zgeez/Pixel-Badge/docs/README.md

# Docs

Start here:

- [Architecture](architecture.md): how the pieces fit together
- [Hardware](hardware.md): the board and the parts on it
- [Firmware](firmware.md): building, controls, tests
- [Rev A firmware](rev-a-firmware.md): pins, memory, scan and power code on the nRF52840
- [App](../app/README.md)
- [Validation](validation.md): what has been measured, and what hasn't

Reference:

- [BLE protocol](ble-protocol.md) and [audio protocol](audio-protocol.md)
- [Power and USB](power.md)
- [NFC](nfc.md) and its [setup tools](../scripts/nfc/README.md)
- [Bring-up checklist](bringup.md), [expected values](bringup-expected.md), [log lines](bringup-logs.md)
- DK bench guides: [wiring](prototype-wiring.md), [BLE](ble-bench.md), [NFC](nfc-prototype.md), [audio](audio-prototype.md), [motion](motion-prototype.md)
- [Decision records](decisions/README.md), [datasheets and sources](references.md), [footprint provenance](../hardware/libraries/README.md)

Dated records in `validation/results/` describe the firmware and setup used at
the time. For how things work today, use these guides.
