zgeez/Pixel-Badge/docs/images/README.md

# Images

Photos and renders are WebP. App screenshots are 1170 × 2532 PNGs with test
data. None of the files carry EXIF, GPS or device metadata.

| Files | Shows |
|---|---|
| `rev-a-charging-bench.webp`, `rev-a-qr-hero.webp`, `rev-a-scan-artwork.webp` | Rev A board 1 running |
| `rev-a-audio-rec.webp` | Recording view with the app |
| `rev-a-fluid.mp4`, `rev-a-fluid-poster.webp` | Fluid effect video and its still |
| `rev-a-fluid-before-fix.webp`, `rev-a-fluid-settled.webp` | Fluid edge pile before and after the fix |
| `rev-a-carrier-kit.webp`, `rev-a-magnetic-backing-photo.webp`, `rev-a-pcb-rear-carrier.webp` | Printed carrier parts |
| `carrier-open.webp` | Carrier CAD |
| `pcb-front-render.webp`, `pcb-rear-render.webp` | KiCad renders |
| `qr-bench.webp`, `bench-overview.webp`, `display-wiring.webp` | nRF5340 DK prototype bench |
| `app-badge.png`, `app-links.png`, `app-text.png`, `app-studio.png` | App screens |
