zgeez/Pixel-Badge/docs/references.md

# References

Authoritative sources for hardware and API claims. Prefer original
manufacturer documentation over secondary sources. When a design decision relies
on a specific document, cite the document revision and section.

## Nordic Semiconductor

- [nRF Connect SDK v3.4.1 documentation](https://nrfconnectdocs.nordicsemi.com/ncs/3.4.1/nrf/index.html)
- [Zephyr documentation as shipped with nRF Connect SDK v3.4.1](https://nrfconnectdocs.nordicsemi.com/ncs/3.4.1/zephyr/index.html)
- [nRF Connect SDK toolchain Docker image](https://nrfconnectdocs.nordicsemi.com/ncs/3.4.1/nrf/scripts/docker/README.html)
- [nRF5340 Product Specification](https://docs.nordicsemi.com/r/bundle/ps_nrf5340/page/keyfeatures_html5.html)
  (HTML tracks the latest revision; accessed 2026-10-04):
  [USBREG](https://docs.nordicsemi.com/r/bundle/ps_nrf5340/page/chapters/usbregulator/doc/usbregulator.html)
  for dedicated VBUS/main-supply requirements, decoupling, USB operating limits,
  and source resistance;
  [Reference circuitry](https://docs.nordicsemi.com/r/bundle/ps_nrf5340/page/chapters/ref_circuitry.html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)
  for supply configurations and recommended VBUS series conditioning, and its
  BOM tables for the DC/DC inductors (10 µH, 50 mA and 80 mA, ±20%, 0603;
  accessed 2026-10-06).
- [nRF5340 SAADC](https://docs.nordicsemi.com/r/bundle/ps_nrf5340/page/saadc.html)
  (latest Product Specification HTML; accessed 2026-10-04), **Digital output**,
  **Reference**, **Acquisition time/Table 2** and **Electrical specification**:
  ADC errors/calibration, VSS–VDD analog-input limits, gain/reference and
  source-resistance/acquisition constraints for battery sensing.
- [nRF5340 DK Hardware user guide](https://docs.nordicsemi.com/bundle/ug_nrf5340_dk/page/ug/dk/intro.html);
  [Programming external boards](https://docs.nordicsemi.com/r/bundle/ug_nrf5340_dk/page/ug/dk/ext_programming_support_p19.html)
  (P19 10-pin debug out: pin 3 to GND selects the external target, the board's
  voltage must match the DK, 3 V when the DK is USB powered, pin 1 supplies
  power only with SB47 shorted);
  [nRF5340 SoC direct supply](https://docs.nordicsemi.com/r/bundle/ug_nrf5340_dk/page/ug/dk/direct_supply.html)
  (P21, SW10 VEXT->nRF, 1.7–3.6 V, also drives the voltage follower) and
  [VDD power sources](https://docs.nordicsemi.com/r/bundle/ug_nrf5340_dk/page/ug/dk/vdd_power_sources.html)
  (accessed 2026-10-06)

- [nRF52840 Product Specification](https://docs.nordicsemi.com/bundle/ps_nrf52840/page/keyfeatures_html5.html)
  (Rev A SoC, [ADR 0015](decisions/0015-nrf52840-e73-module.md)); [CLOCK](https://docs.nordicsemi.com/bundle/ps_nrf52840/page/clock.html): external LFXO load capacitors
  (accessed 2026-10-13)

## Ebyte E73-2G4M08S1C

- E73-2G4M08S1C specification (Chinese, ©2012–2019), LCSC copy for C356849:
  [PDF](https://wmsc.lcsc.com/wmsc/upload/file/pdf/v2/lcsc/2504101957_Chengdu-Ebyte-Elec-Tech-E73-2G4M08S1C_C356849.pdf),
  SHA-256 `4ffa0c3e959bc193ed013d5e9c3062cceb720c22aac751637a21cc0b9dc149af`
  (downloaded 2026-10-13). §2: parameters (1.7–5.5 V, 13 × 18 mm, ceramic
  antenna, 32.768 kHz crystal external); §3: mechanical drawing (3.00 mm thick,
  bottom-view pad dimensions) and pin table (low-frequency pins marked);
  §5.1: module reference circuit.
- [Ebyte product page, pin definitions](https://www.cdebyte.com/products/E73-2G4M08S1C/2)

## Raytac MDBT53-P1M (superseded for Rev A by ADR 0015)

- [MDBT53-1M & MDBT53-P1M Specification, Ver.E](https://www.raytac.com/document/act.php?act=1&index_id=78),
  issued **2024-10-25**. §2.1 (pp.7–8): dimensions/pin orientation;
  §2.2 (pp.9–10): solder-pad layout; §2.3 (pp.11–14): antenna keep-out;
  §2.5 (pp.15–18): pinout, including VDD/VDDH and USB VBUS/D+/D−;
  §5: ratings; §8 (p.42): clock/reference-circuit notes;
  §8.1.2 (p.44): normal-voltage DC/DC reference circuit, including external
  VBUS conditioning and decoupling. Page numbers are the document's printed
  numbers. Release notes on p.71 identify the Ver.E changes.
- [MDBT53 / MDBT53-P / MDBT53-U Footprint & Design Guide, 241021](https://www.raytac.com/document/act.php?act=1&index_id=74),
  package dated **2024-10-21** (RAR archive). Use the **MDBT53-P** variant:
  `2D & 3D Drawing/MDBT53-P/`, the supplied footprint libraries,
  `53 Series Reference solder pad Layout-F_v6-230825v2.pdf`,
  `Recommended RF Layout/53 recommendended RF layout-F-241021.pdf`,
  and `Recommended 32.768KHZ Crystal Spec/` (crystal specification and Nordic
  guidance). The package also includes the reflow profile. Check crystal load
  configuration against the chosen crystal and firmware; an example part in
  the package is not a frozen Rev A BOM selection.
- Raytac R&D, written reply to the project (email, **2026-10-08**): the DECUSB
  capacitor is included in the MDBT53 modules (no external capacitor needed
  for the internal USB LDO); C25 (4.7 µF behind R22 2.2 Ω) in the reference
  circuit is C_VBUS.
- nRF5340 VBUS source resistance: at most 6 Ω DC including the cable when VDDH
  is not connected to VBUS, so that VBUS stays above 4.35 V. The nRF5340
  Product Specification figure as quoted by a user and confirmed by Nordic staff on
  [DevZone](https://devzone.nordicsemi.com/f/nordic-q-a/129336/thingy-91-x---npm1300-vbusout-and-nrf5340-vbus-source-resistance);
  the Product Specification table itself was not retrieved for this project.

The manufacturer download endpoints above deliver the documents directly.
If Raytac replaces a file, locate the named revision via its
[module product downloads](https://www.raytac.com/tw/product/ins.php?index_id=103)
and [support index](https://www.raytac.com/document/). Downloads verified on
2026-10-04 had these SHA-256 hashes (retain the exact reviewed files in the
local design evidence; do not substitute a new revision silently):

| Document | SHA-256 |
|---|---|
| Ver.E PDF | `b10ea0cfdc962bf20122c0f91fb75d807f8feee2774d09086bf526208f93a217` |
| 241021 RAR | `aa0ffdbf622c99a0c9f68498f8f4eb870cc05d39fb83beda038e45ce71184220` |

## Zephyr RTOS

The nRF Connect SDK uses a Nordic fork of Zephyr; when upstream and SDK
documentation differ, the SDK-versioned documentation above applies.

- [C++ support](https://docs.zephyrproject.org/latest/develop/languages/cpp/index.html)
- [Logging](https://docs.zephyrproject.org/latest/services/logging/index.html)
- [Ztest](https://docs.zephyrproject.org/latest/develop/test/ztest.html)
- [Twister](https://docs.zephyrproject.org/latest/develop/test/twister.html)
- [native_sim board](https://docs.zephyrproject.org/latest/boards/native/native_sim/doc/index.html)

## Debug and logging

- [SEGGER Real-Time Transfer (RTT)](https://www.segger.com/products/debug-probes/j-link/technology/about-real-time-transfer/)

## PCB design and manufacturing

- [KiCad 10.0 documentation](https://docs.kicad.org/10.0/)
- [JLCPCB PCB capabilities](https://jlcpcb.com/capabilities/pcb-capabilities)

## Standards

- USB-IF [USB Type-C Cable and Connector Specification Release 2.5](https://www.usb.org/document-library/usb-type-cr-cable-and-connector-specification-release-25),
  **March 2026** (published 2026-04-08),
  [official release ZIP](https://www.usb.org/sites/default/files/USB%20Type-C%202.5%20Release%20202603.zip).
  Use `USB Type-C Spec R2.5 - March 2026.pdf`:
  §4.5.1.3.2/Figure 4-9 (p.165) requires CC1 and CC2 sink terminations;
  §4.11.1/Table 4-28 (p.245) specifies 5.1 kΩ Rd and total-resistance tolerance;
  §4.6.2.1 defines current behavior and refers Default USB Power sinks to the
  applicable USB specification; Table 4-36 (p.255) gives sink CC voltage ranges
  and thresholds for current-advertisement detection; tSinkAdj (60 ms) bounds
  the sink's reaction to an advertisement change. Page numbers are printed numbers;
  accessed 2026-10-04. No USB PD functionality is selected.
- QR Code: ISO/IEC 18004 (QR Code bar code symbology specification)
- DENSO WAVE:
  [QR versions and dimensions](https://www.qrcode.com/en/about/version.html)
  (Version 1: 21×21; each version adds four modules per side) and
  [required quiet zone](https://www.qrcode.com/en/howto/code.html/index.html)
  (four modules on every side). Accessed 2026-10-04; supports the 29×29
  Version 1 versus 33×33 Version 2 display-fit calculation.

## Component datasheets

Record part number, manufacturer, document revision, and link. Sources for
provisional parts do not imply final part selection or hardware validation.

| Part | Function | Manufacturer document | Revision |
|---|---|---|---|
| BQ25620 (selected charger) | Switching charger, NVDC power path, BC1.2 detection (Tables 8-1/8-2), POR defaults (§8.6), TS/JEITA network (§8.3.5.4.2), inductor/capacitor selection (§9.2.2), RYK0018A land pattern (4226526/A), I²C address 0x6B | [TI BQ25620/BQ25622, SLUSEG2D](https://www.ti.com/lit/ds/symlink/bq25620.pdf) | Rev.D, February 2025 |
| BQ24074 (previously selected; replaced) | Linear-charger analysis kept for reference: K_ISET, thermal Eq. 11 | [TI BQ2407x, SLUS810N](https://www.ti.com/lit/gpn/bq24074) | Rev.N, October 2021 |
| NT3H2111 (selected: NT3H2111W0FHKH, XQFN-8) | Passive NFC, I²C NDEF persistence and RF-write protection | [NXP NT3H2111_2211](https://www.nxp.com/docs/en/data-sheet/NT3H2111_2211.pdf), §8.3.11/Tables 9–10 (pp.26–29), §8.7 (pp.38–39), §10.8; memory maps §§8.3.2–8.3.5 | Rev.3.6, 2023-07-21 |
| NTAG NDEF example | Minimal URI TLV, CC and address-byte personalization | [NXP AN11786](https://www.nxp.com/docs/en/application-note/AN11786.pdf) | Rev.1.1, cover dated 2018-06-02 |
| Android NFC RF verifier | Native Type 2 transceive and reader mode | [NfcA](https://developer.android.com/reference/android/nfc/tech/NfcA), [NfcAdapter](https://developer.android.com/reference/android/nfc/NfcAdapter) | API documentation; checked 2026-10-11 |
| NT3H2111 / NT3H2211 errata | RF/I²C corruption, field-detect/timing, verification, configuration locks and recovery | [NXP ES_NT3H2111_2211](https://www.nxp.com/docs/en/errata/ES_NT3H2111_2211.pdf), §§2–4 | Rev.4.1, 2025-10-30 |
| NTAG antenna design | Coil target frequency, capacitance budget, rectangular-coil inductance formula, turn exponent | NXP AN11276 NTAG Antenna Design Guide, §§4.2–4.3, Table 5 (NXP-authored; retrieved from the [NXP Community attachment](https://community.nxp.com/pwmxy87654/attachments/pwmxy87654/nfc/10167/1/AN11276.pdf), SHA-256 `ce97eea73d4517fc5d9caed533aba2e35a2d25ca6f07b315bd40309bf5d77d2d`) | Rev.1.8, 2018-10-23 |
| TPS63802 (selected logic regulator) | 3.3 V buck-boost; pin functions Table 7-1; FB setting §10.2.2.5; inductor selection §10.2.2.2; DLA0010A package and land pattern (drawing 4223750/D) | [TI TPS63802, SLVSEU9D](https://www.ti.com/lit/ds/symlink/tps63802.pdf) | Rev.D, January 2021 |
| TPS61023 (selected LED boost) | VLED boost with load disconnect; VREF/OVP/EN in §6.5; FB §8.2.2.1; inductor §8.2.2.2; feed-forward §8.2.2.4; DRL0006A land pattern (4223266/F) | [TI TPS61023, SLVSF14B](https://www.ti.com/lit/ds/symlink/tps61023.pdf) | Rev.B, August 2020 |
| XGL4020-102MEC (TPS61023 and BQ25620 inductor) | 1.0 µH ±20%, DCR 9.0 mΩ max, Isat 3.8 / 6.3 / 8.8 A (10 / 20 / 30% drop, 25 °C), Irms 8.8 A (20 °C rise), L vs current, 4.0 × 4.0 × 2.10 mm max, recommended land pattern | [Coilcraft XGL4020, Documents 1529-1 to 1529-3](https://www.coilcraft.com/pdfs/xgl4020.pdf) | Revised 02/19/26 |
| DFE201612E-R47M=P2 (TPS63802 inductor) | 0.47 µH ±20%, DCR 26 mΩ max, 5.5 A (−30% L), 4.5 A (40 °C rise) | Murata reference specification J(E)TE243A-0006B-01 | — |
| ICM-42688-P (conditional IMU) | Pinout (Table 9), application circuit and bypass BOM (§§4.2–4.3), I²C address and 1 MHz limit, I²C driver settings §12.3, INT_ASYNC_RESET §12.6, invalid-data values §12.8, registers §§13–15, LGA-14 package §10.2 | TDK InvenSense DS-000347 | Rev.1.2 |
| SPH0641LM4H-1 (microphone) | Pinout, SELECT timing (Table 7), application circuit and bypass note, example land pattern and PCB acoustic hole (0.6–1.0 mm) | [Knowles SPH0641LM4H-1 datasheet](https://mm.digikey.com/Volume0/opasdata/d220001/medias/docus/1290/SPH0641LM4H-1.pdf) (Knowles document hosted by Digi-Key) | Rev D |
| NT3H2111W0FHKH package | XQFN8 SOT902-3 outline (Figure 31) and reflow footprint sot902-3_fr (Figure 32, p. 71) used for the project footprint | NXP NT3H2111_2211 | Rev. 3.6 |
| TYPE-C-31-M-12 (USB-C receptacle) | Pinout and recommended PCB layout (component side) | HRO drawing TYPE-C-31-M-12 | 2020-12-08 |
| PCM12SMTR (power switch) | SPDT terminal functions and PC mounting pattern | C&K PCM series | 27 Aug 2019 |
| TS-1088-AR02016 (buttons) | Body, height 2.0 mm, 160 gf; PCB welding drawing (pads 1.05 × 2.00 mm, 3.40/5.50 mm) | XUNPU TS-1088 drawing | — |
| KT-0603R (status LED) | Red 0603, Vf 1.8–2.4 V at 20 mA (distributor listing) | Hubei KENTO listing (LCSC C2286) | — |
| TLC59283 RGE package | Pin functions (Table 4-1, RGE column), thermal pad not connected inside, RGE0024C outline and land pattern (4224376/C) | TI TLC59283, SBVS199C | Rev.C, January 2024 |
| SN74LVC8T245 (row-chain translator) | Function table (OE low, DIR high = A to B), VCC isolation below 100 mV, Ioff, unused inputs | TI SN74LVC8T245, SCES584D | Rev.D, May 2026 |
| SN74HC595 (row registers) | Pinout, VCC 2–6 V, output drive at 4.5 V, timing | TI SN74HC595, SCLS041J | Rev.J, October 2021 |
| SN74LVC1G123 (scan-stall monostable) | Pin functions (Q output only), B rising-edge retrigger with A low and CLR high, tw 1.0–1.1 ms guaranteed at Rext 10 kΩ / Cext 0.1 µF (Switching Characteristics §§5.8–5.9, MIN/MAX at VCC 3.3 V ± 0.3 V, −40 to 125 °C) | TI SN74LVC1G123, SCES586E | Rev.E, March 2024 |
| SN74LVC1G04 / SN74LVC1G32 (SAFE inverter, BLANK OR) | DBV pin functions | TI SCES214AF / SCES219W | October 2025 / August 2026 |
| 4D03WGJ0103T5E (gate pull-ups) | 4 × 10 kΩ isolated, convex terminals, 0603 × 4 | UNI-ROYAL chip resistor array specification | — |
| KT-0603W (matrix LED) | Absolute maximums (25 °C): 100 mW, 30 mA DC, 60 mA peak (1/10 duty, 0.1 ms), 5 V reverse, −40 to 85 °C; at 5 mA: 145–360 mcd, Vf 2.6–3.1 V, 120°; typical curves (Vf and intensity vs current, current derating vs temperature); land pattern | Hubei KENTO specification for approval, CICADT 0603-0.6DT white, LCSC C2290 PDF | Rev A.0, 2018-12-06 |
| AO3401A / AO3400A | Row and VBAT high-side switch; VBAT and CC-sense N-MOSFETs; IDSS, VGS(th), RDS(on), SOT-23 pinout | Alpha & Omega AO3401A and AO3400A datasheets | Rev.3.1 (December 2023 / July 2023) |
| MLZ1608M100WT000 (module DC/DC inductors) | 10 µH ±20% (2 MHz), DCR 1.05 Ω ±30%; Isat 90 mA max (current at which inductance has fallen by up to 50%); Itemp 250 mA typ, a reference value for a 20 °C rise, not a rating; inductance vs DC bias curve | TDK *Inductors for decoupling circuits, Multilayer ferrite, MLZ series, MLZ1608 type* | 20201224 |
| CM7V-T1A 32.768 kHz, 9 pF (selected crystal) | CL, RS, C0, drive level against the Raytac crystal specification | Micro Crystal CM7V-T1A datasheet | Version 8.0, 10.2016 |
| Adafruit 328 / PKCELL LIPO785060 (selected pack) | Capacity, charge and discharge limits, temperature ranges, dimensions, plug | [Adafruit product 328](https://www.adafruit.com/product/328); [PKCELL LIPO785060 2500 mAh specification](https://cdn-shop.adafruit.com/product-files/328/LP785060+2500mAh+3.7V+20190510.pdf) | Valid 2019-05-10 (accessed 2026-10-05) |
| S2B-PH-K-S(LF)(SN) (battery header J302) | Through-hole side-entry header: height 4.8 mm, Ø0.7 mm holes at 2.0 mm pitch, circuit 1 position viewed from the mounting surface | [JST PH connector catalogue](https://www.jst-mfg.com/product/pdf/eng/ePH.pdf) | — |
| Ricoh R5478N101CD (pack protection IC) | Over-charge/over-discharge/excess-current thresholds and delays | Ricoh R5475N/R5478N datasheet EA-291-121009 (selection guide) | EA-291-121009 |
| NCP15XH103F03RC (board NTC) | 10 kΩ ±1%, B25/50 3380 K ±1% (B25/85 3434 K), 103AT-class; resistance–temperature table used for the TS thresholds | Murata NCP series, catalog R44E | R44E-12 |
| TLC59283 (selected column driver) | IREF setting (Equation 1), IOLC 32.9–37.7 mA at a 35.3 mA target (25 °C), IOLC vs temperature (Figure 5-9), 2–35 mA range below VCC 3.6 V | [TI TLC59283, SBVS199C](https://www.ti.com/lit/ds/symlink/tlc59283.pdf) | Rev.C, January 2024 |
| BQ27427 (comparison only; not selected) | Representative capacity/state-of-charge gauge with chemistry selection | [TI BQ27427, SLUSEB5B](https://www.ti.com/lit/ds/symlink/bq27427.pdf), features, §6.4 device modes and §7 application | Rev.B, September 2025 |

The pack's protection-board trip current, delays and recovery are not in the
documents above; record them if the vendor provides them. Do not assign
electrical values from targets.
