zgeez/Pixel-Badge/hardware/mechanical/mode-button-cap.3mf

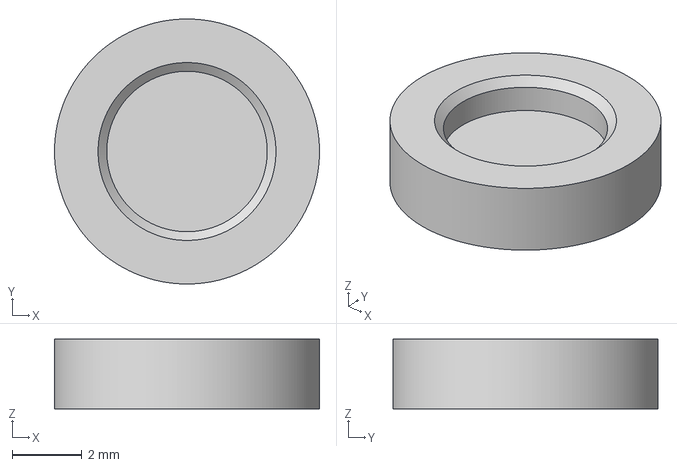
[picture p20: CAD file, 2026-11-04]
hardware/mechanical/mode-button-cap.3mf
7.60 x 7.60 x 2.00 mm
