zgeez/Pixel-Badge/hardware/mechanical/matrix-pixel-grid.3mf

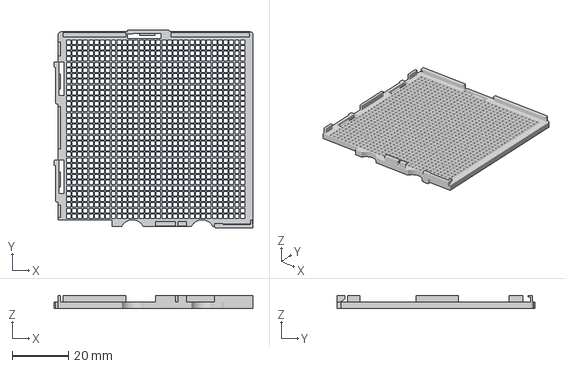
[picture p21: CAD file, 2026-11-04]
hardware/mechanical/matrix-pixel-grid.3mf
70.9 x 70.5 x 4.80 mm
