zgeez/Pixel-Badge/hardware/mechanical/button-plunger.3mf

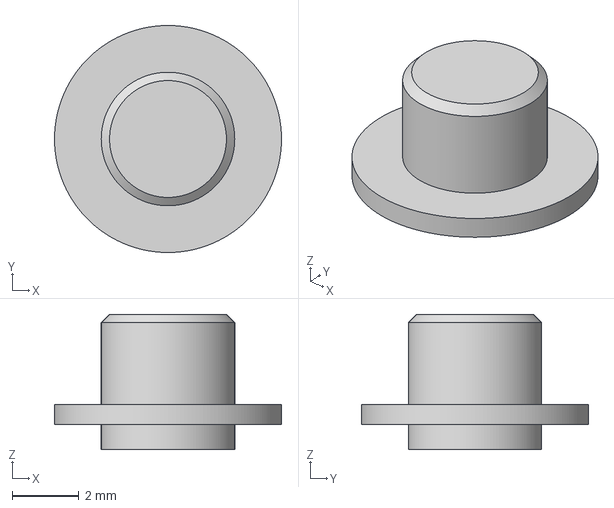
[picture p22: CAD file, 2026-11-04]
hardware/mechanical/button-plunger.3mf
6.80 x 6.80 x 4.05 mm
