zgeez/Pixel-Badge/hardware/mechanical/magnet-retaining-cap.3mf

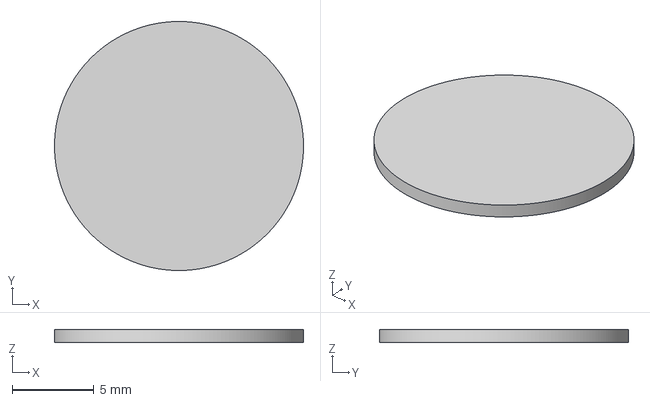
[picture p23: CAD file, 2026-11-04]
hardware/mechanical/magnet-retaining-cap.3mf
15.2 x 15.2 x 0.8 mm
