zgeez/Pixel-Badge/hardware/mechanical/action-button-cap.3mf

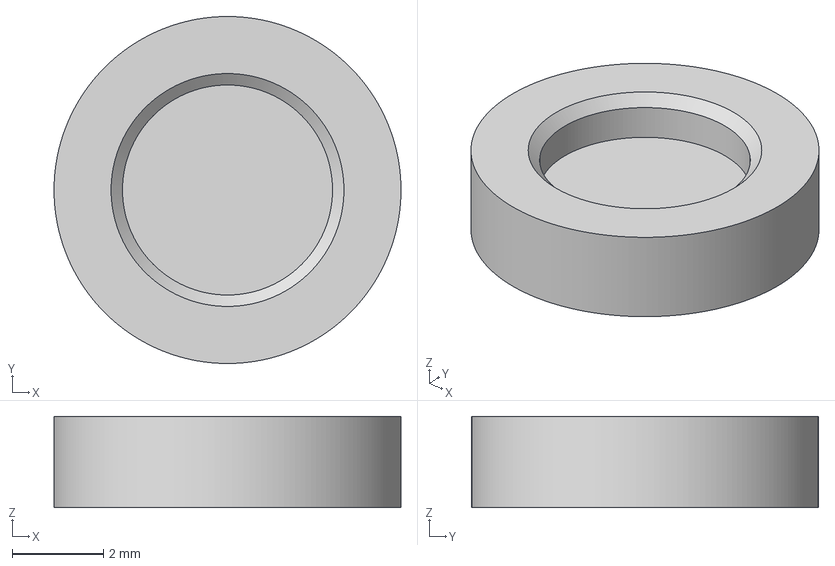
[picture p24: CAD file, 2026-11-04]
hardware/mechanical/action-button-cap.3mf
7.60 x 7.60 x 2.00 mm
