zgeez/Pixel-Badge/hardware/mechanical/matrix-diffuser.3mf

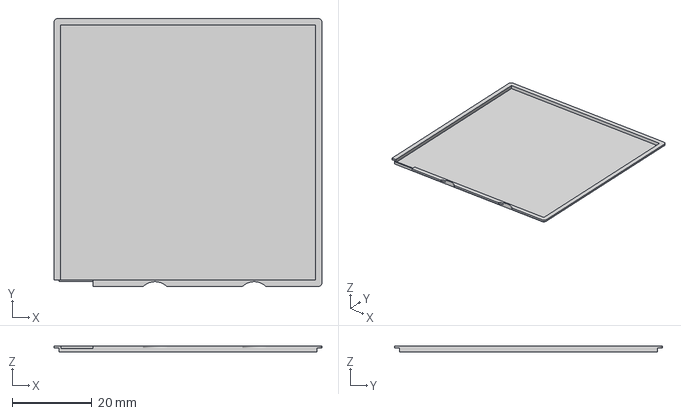
[picture p25: CAD file, 2026-11-04]
hardware/mechanical/matrix-diffuser.3mf
67.0 x 67.0 x 1.60 mm
