zgeez/Pixel-Badge/hardware/mechanical/magnetic-backing.3mf

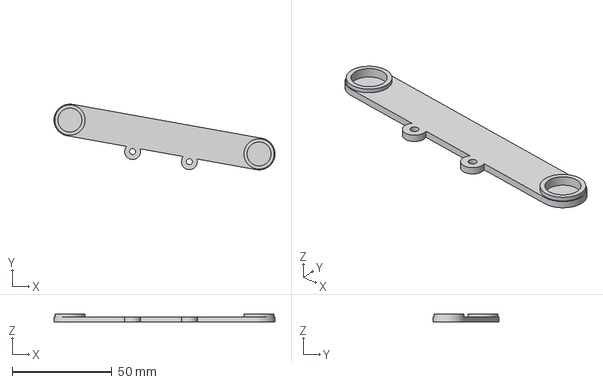
[picture p26: CAD file, 2026-11-04]
hardware/mechanical/magnetic-backing.3mf
110.9 x 33.0 x 3.80 mm
