zgeez/Pixel-Badge/hardware/mechanical/pcb-no-rear-jst.3mf

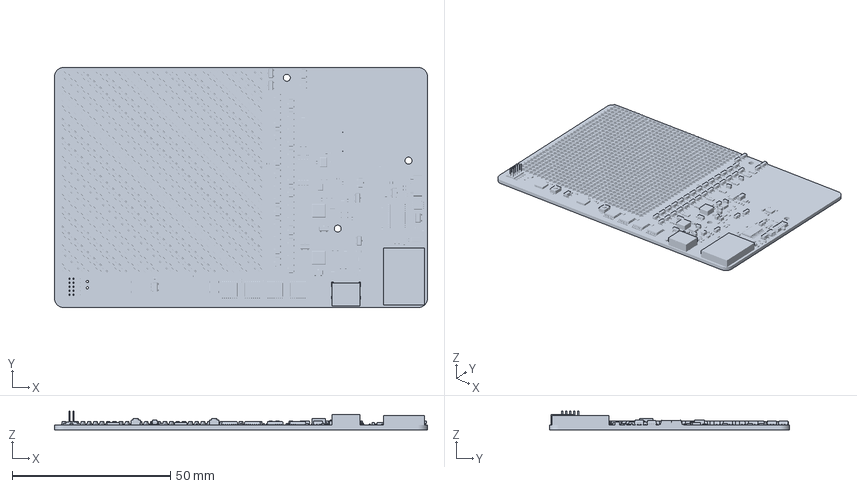
[picture p27: CAD file, 2026-11-04]
hardware/mechanical/pcb-no-rear-jst.3mf
118.0 x 76.0 x 6.00 mm
