zgeez/Pixel-Badge/hardware/mechanical/rear-carrier.3mf

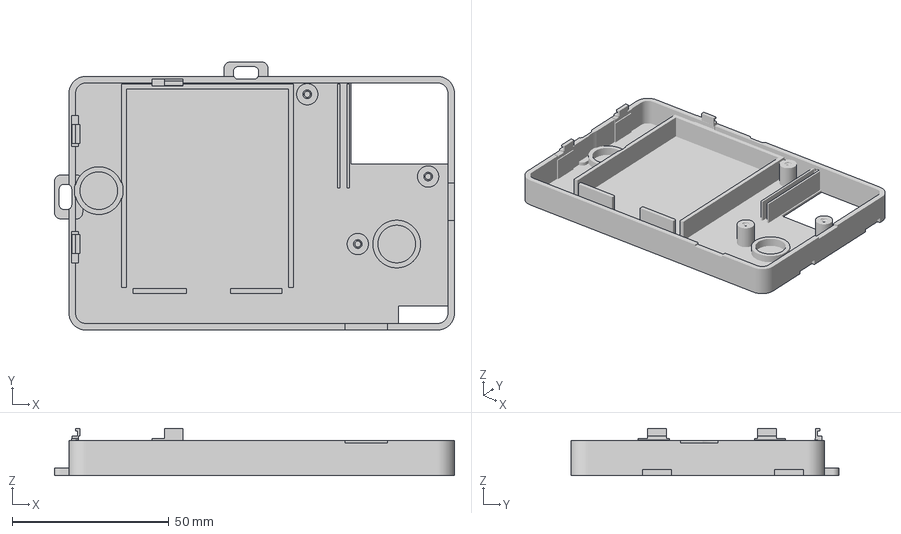
[picture p28: CAD file, 2026-11-04]
hardware/mechanical/rear-carrier.3mf
127.4 x 85.4 x 15.1 mm
