zgeez/Pixel-Badge/hardware/mechanical/m2-thread-coupon.3mf

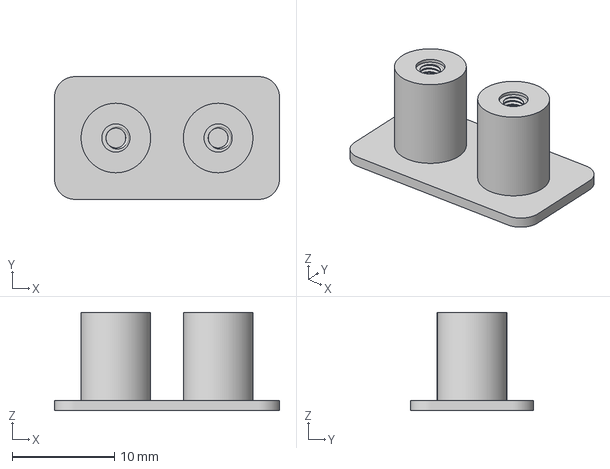
[picture p29: CAD file, 2026-11-04]
hardware/mechanical/m2-thread-coupon.3mf
22.0 x 12.0 x 9.60 mm
