zgeez/Pixel-Badge/hardware/mechanical/front-face.3mf

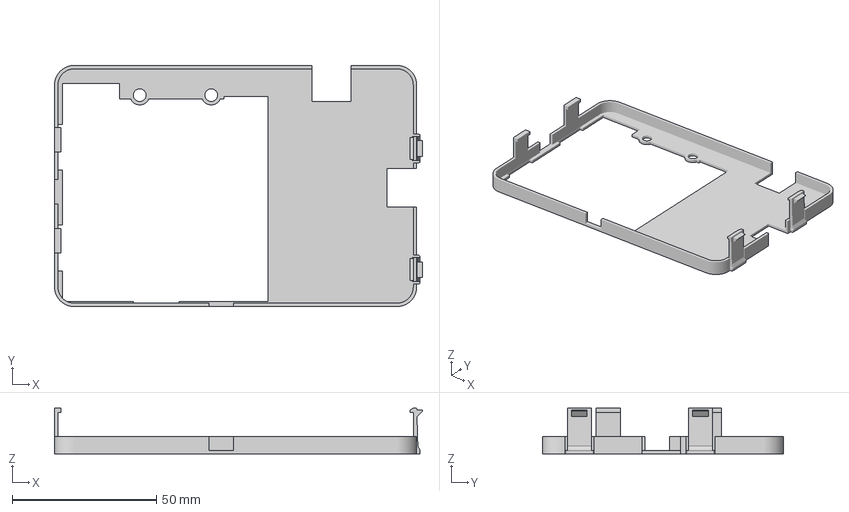
[picture p30: CAD file, 2026-11-04]
hardware/mechanical/front-face.3mf
127.6 x 83.6 x 15.9 mm
