zgeez/Pixel-Badge/validation/results/2026-10-11-hub75-qr-screening/results.csv

setting | code | payload | polarity | brightness | phone | app | distance_cm | angle_deg | light | trials | decoded_le_1s | decoded_le_3s | failed | notes
1 | V1-L | HTTPS://EXAMPLE.COM | normal | 255 | Nothing 4a Pro (owner wording) | Google Lens | adjusted | 0 | indoor, varied | 3 |  |  | 0 | decoded 3 of 3 (owner: all settings passed); time per try not recorded; distance adjusted to brightness and lighting
2 | V1-L | HTTPS://EXAMPLE.COM | normal | 64 | Nothing 4a Pro (owner wording) | Google Lens | adjusted | 0 | indoor, varied | 3 |  |  | 0 | decoded 3 of 3 (owner: all settings passed); time per try not recorded; distance adjusted to brightness and lighting
3 | V1-L | HTTPS://EXAMPLE.COM | normal | 16 | Nothing 4a Pro (owner wording) | Google Lens | adjusted | 0 | indoor, varied | 3 |  |  | 0 | decoded 3 of 3 (owner: all settings passed); time per try not recorded; distance adjusted to brightness and lighting
4 | V1-L | HTTPS://EXAMPLE.COM | inverted | 255 | Nothing 4a Pro (owner wording) | Google Lens | adjusted | 0 | indoor, varied | 3 |  |  | 0 | decoded 3 of 3 (owner: all settings passed); time per try not recorded; distance adjusted to brightness and lighting
5 | V1-L | HTTPS://EXAMPLE.COM | inverted | 64 | Nothing 4a Pro (owner wording) | Google Lens | adjusted | 0 | indoor, varied | 3 |  |  | 0 | decoded 3 of 3 (owner: all settings passed); time per try not recorded; distance adjusted to brightness and lighting
6 | V1-L | HTTPS://EXAMPLE.COM | inverted | 16 | Nothing 4a Pro (owner wording) | Google Lens | adjusted | 0 | indoor, varied | 3 |  |  | 0 | decoded 3 of 3 (owner: all settings passed); time per try not recorded; distance adjusted to brightness and lighting
7 | V1-M | HTTPS://EXAMPLE.COM | normal | 255 | Nothing 4a Pro (owner wording) | Google Lens | adjusted | 0 | indoor, varied | 3 |  |  | 0 | decoded 3 of 3 (owner: all settings passed); time per try not recorded; distance adjusted to brightness and lighting
8 | V1-M | HTTPS://EXAMPLE.COM | normal | 64 | Nothing 4a Pro (owner wording) | Google Lens | adjusted | 0 | indoor, varied | 3 |  |  | 0 | decoded 3 of 3 (owner: all settings passed); time per try not recorded; distance adjusted to brightness and lighting
9 | V1-M | HTTPS://EXAMPLE.COM | normal | 16 | Nothing 4a Pro (owner wording) | Google Lens | adjusted | 0 | indoor, varied | 3 |  |  | 0 | decoded 3 of 3 (owner: all settings passed); time per try not recorded; distance adjusted to brightness and lighting
10 | V1-M | HTTPS://EXAMPLE.COM | inverted | 255 | Nothing 4a Pro (owner wording) | Google Lens | adjusted | 0 | indoor, varied | 3 |  |  | 0 | decoded 3 of 3 (owner: all settings passed); time per try not recorded; distance adjusted to brightness and lighting
11 | V1-M | HTTPS://EXAMPLE.COM | inverted | 64 | Nothing 4a Pro (owner wording) | Google Lens | adjusted | 0 | indoor, varied | 3 |  |  | 0 | decoded 3 of 3 (owner: all settings passed); time per try not recorded; distance adjusted to brightness and lighting
12 | V1-M | HTTPS://EXAMPLE.COM | inverted | 16 | Nothing 4a Pro (owner wording) | Google Lens | adjusted | 0 | indoor, varied | 3 |  |  | 0 | decoded 3 of 3 (owner: all settings passed); time per try not recorded; distance adjusted to brightness and lighting
13 | V1-Q | HTTPS://IANA.ORG | normal | 255 | Nothing 4a Pro (owner wording) | Google Lens | adjusted | 0 | indoor, varied | 3 |  |  | 0 | decoded 3 of 3 (owner: all settings passed); time per try not recorded; distance adjusted to brightness and lighting
14 | V1-Q | HTTPS://IANA.ORG | normal | 64 | Nothing 4a Pro (owner wording) | Google Lens | adjusted | 0 | indoor, varied | 3 |  |  | 0 | decoded 3 of 3 (owner: all settings passed); time per try not recorded; distance adjusted to brightness and lighting
15 | V1-Q | HTTPS://IANA.ORG | normal | 16 | Nothing 4a Pro (owner wording) | Google Lens | adjusted | 0 | indoor, varied | 3 |  |  | 0 | decoded 3 of 3 (owner: all settings passed); time per try not recorded; distance adjusted to brightness and lighting
16 | V1-Q | HTTPS://IANA.ORG | inverted | 255 | Nothing 4a Pro (owner wording) | Google Lens | adjusted | 0 | indoor, varied | 3 |  |  | 0 | decoded 3 of 3 (owner: all settings passed); time per try not recorded; distance adjusted to brightness and lighting
17 | V1-Q | HTTPS://IANA.ORG | inverted | 64 | Nothing 4a Pro (owner wording) | Google Lens | adjusted | 0 | indoor, varied | 3 |  |  | 0 | decoded 3 of 3 (owner: all settings passed); time per try not recorded; distance adjusted to brightness and lighting
18 | V1-Q | HTTPS://IANA.ORG | inverted | 16 | Nothing 4a Pro (owner wording) | Google Lens | adjusted | 0 | indoor, varied | 3 |  |  | 0 | decoded 3 of 3 (owner: all settings passed); time per try not recorded; distance adjusted to brightness and lighting
