zgeez/Pixel-Badge/validation/results/2026-10-09-dk-matrix-timing/halt.png

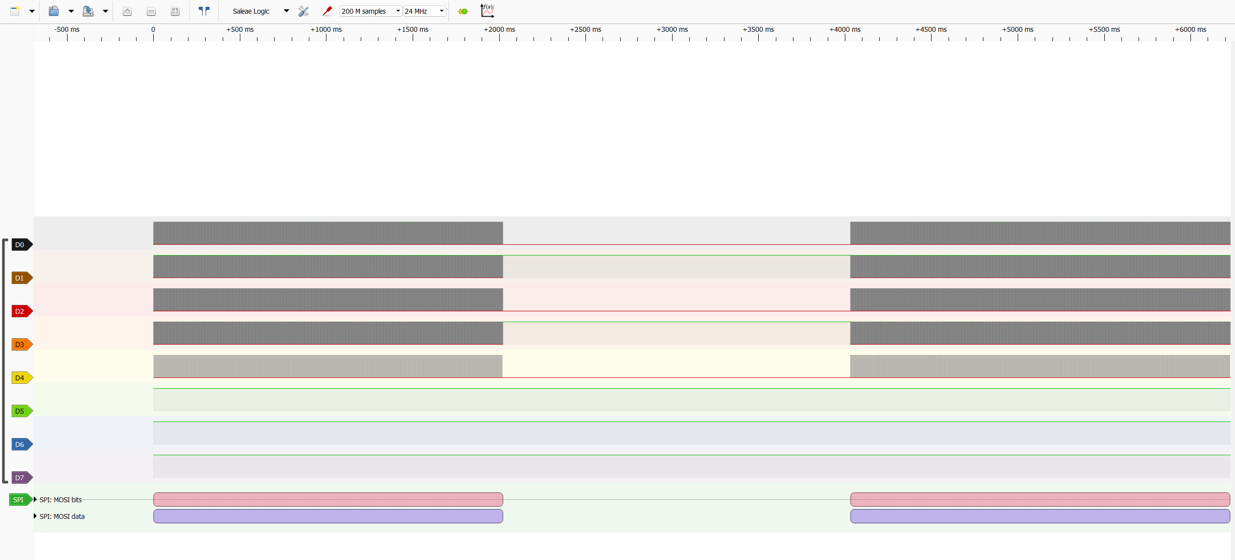
validation/results/2026-10-09-dk-matrix-timing/halt.png
