zgeez/Pixel-Badge/validation/results/2026-10-17-app-visual-cleanup/selection-menus.png

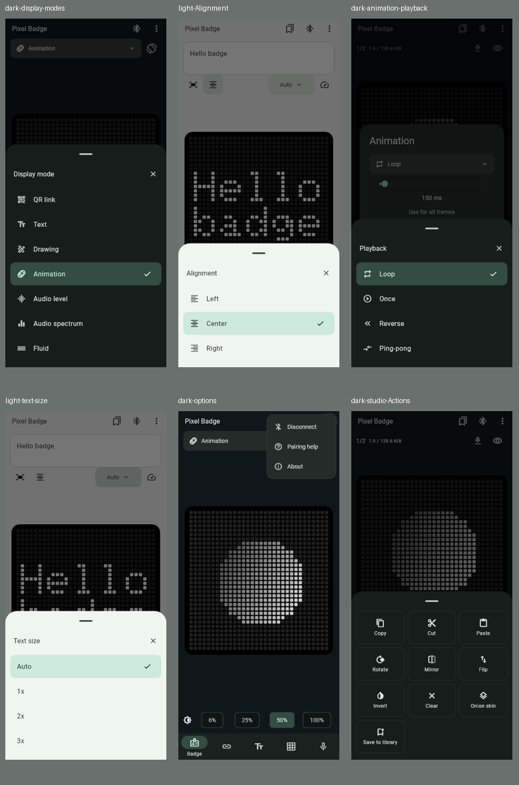
validation/results/2026-10-17-app-visual-cleanup/selection-menus.png
