zgeez/Pixel-Badge/validation/results/2026-10-17-bounce-lines/keyboard-editor.png

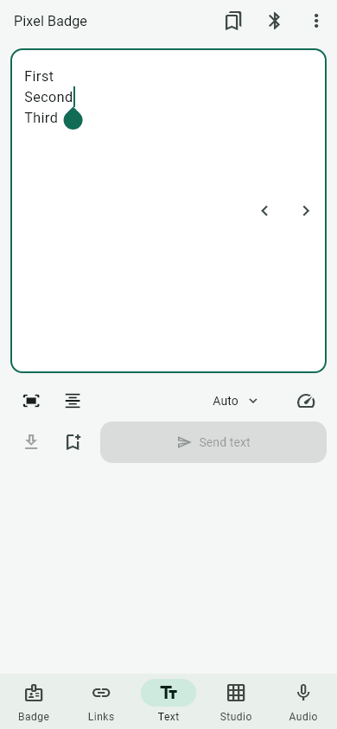
validation/results/2026-10-17-bounce-lines/keyboard-editor.png
