zgeez/Pixel-Badge/validation/results/2026-10-17-bounce-lines/keyboard-large-text.png

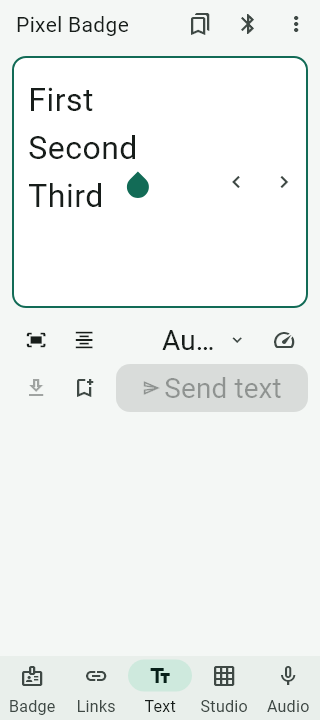
validation/results/2026-10-17-bounce-lines/keyboard-large-text.png
