zgeez/Pixel-Badge/validation/results/2026-10-17-editor-transfer/editor-caret.png

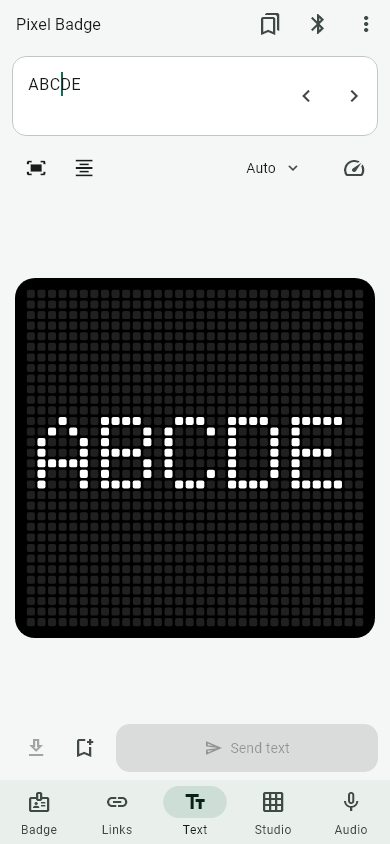
validation/results/2026-10-17-editor-transfer/editor-caret.png
