zgeez/Pixel-Badge/hardware/smart-led-badge.kicad_pcb

## KiCad design hardware/smart-led-badge.kicad_pcb (2026-10-19)

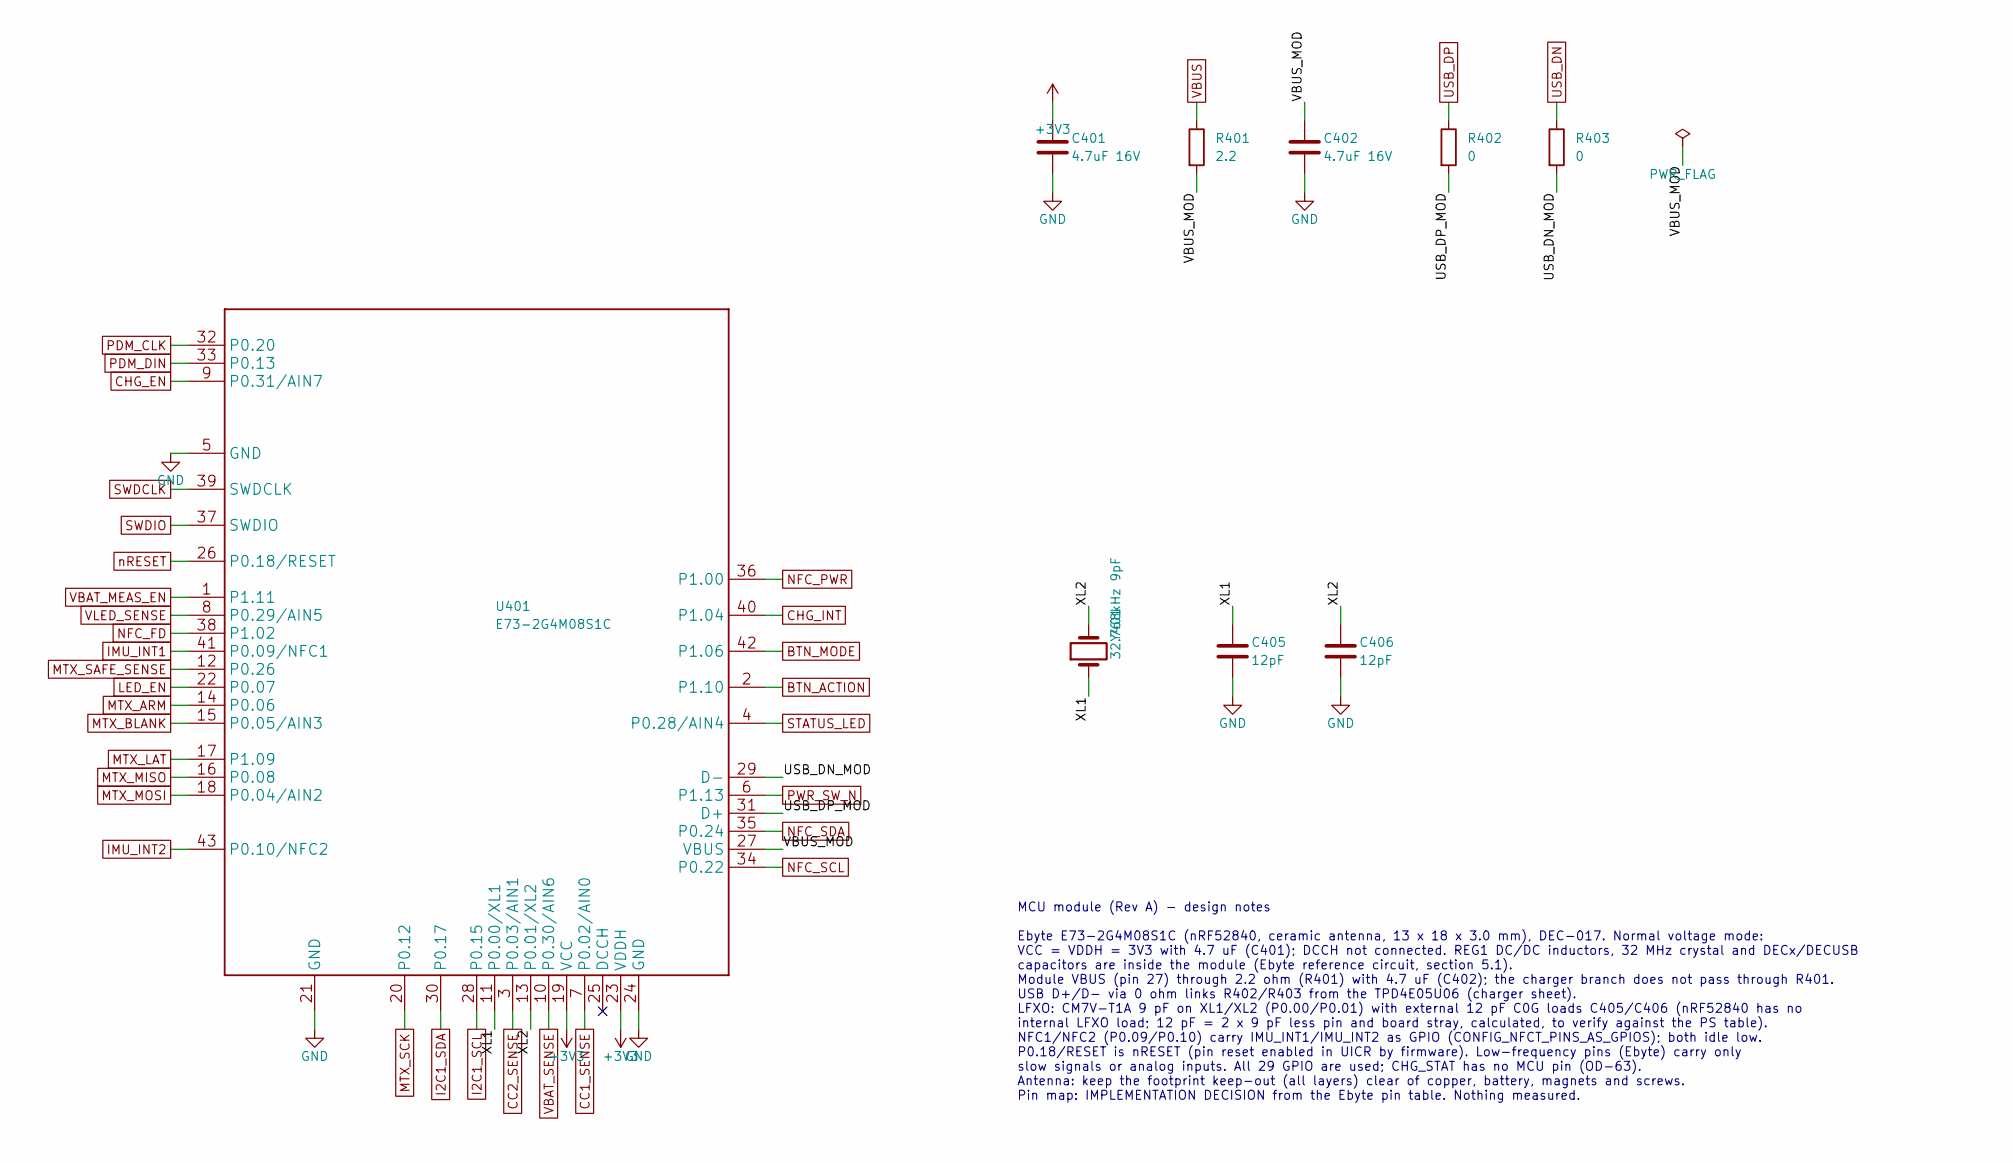
[picture p42: schematic mcu_module.kicad_sch, MCU Module]

Parts:
C401, C402: 4.7uF 16V; C_0603_1608Metric; MPN CL10A475KO8NNNC; LCSC C19666
C405, C406: 12pF; C_0402_1005Metric; MPN 0402CG120J500NT; LCSC C1547
R401: 2.2; R_0603_1608Metric; MPN 0603WAF220KT5E; LCSC C22939
R402, R403: 0; R_0402_1005Metric; MPN 0402WGF0000TCE; LCSC C17168
U401: E73-2G4M08S1C; Ebyte_E73-2G4M08S1C; MPN E73-2G4M08S1C; LCSC C356849
Y401: 32.768kHz 9pF; Crystal_SMD_3215-2Pin_3.2x1.5mm; MPN CM7V-T1A-32.768KHZ-9PF-20PPM-TA-QC; LCSC C5366538

Connections:
+3V3: C401.1, U401.19 (VCC), U401.23 (VDDH); also elsewhere on the board
/MCU Module/USB_DN_MOD: R403.2, U401.29 (D-)
/MCU Module/USB_DP_MOD: R402.2, U401.31 (D+)
/MCU Module/VBUS_MOD: C402.1, R401.2, U401.27 (VBUS)
/MCU Module/XL1: C405.1, U401.11 (P0.00/XL1), Y401.1
/MCU Module/XL2: C406.1, U401.13 (P0.01/XL2), Y401.2
BTN_ACTION: U401.2 (P1.10); also elsewhere on the board
BTN_MODE: U401.42 (P1.06); also elsewhere on the board
CC1_SENSE: U401.7 (P0.02/AIN0); also elsewhere on the board
CC2_SENSE: U401.3 (P0.03/AIN1); also elsewhere on the board
CHG_EN: U401.9 (P0.31/AIN7); also elsewhere on the board
CHG_INT: U401.40 (P1.04); also elsewhere on the board
GND: C401.2, C402.2, C405.2, C406.2, U401.5 (GND), U401.21 (GND), U401.24 (GND); also elsewhere on the board
I2C1_SCL: U401.28 (P0.15); also elsewhere on the board
I2C1_SDA: U401.30 (P0.17); also elsewhere on the board
IMU_INT1: U401.41 (P0.09/NFC1); also elsewhere on the board
IMU_INT2: U401.43 (P0.10/NFC2); also elsewhere on the board
LED_EN: U401.22 (P0.07); also elsewhere on the board
MTX_ARM: U401.14 (P0.06); also elsewhere on the board
MTX_BLANK: U401.15 (P0.05/AIN3); also elsewhere on the board
MTX_LAT: U401.17 (P1.09); also elsewhere on the board
MTX_MISO: U401.16 (P0.08); also elsewhere on the board
MTX_MOSI: U401.18 (P0.04/AIN2); also elsewhere on the board
MTX_SAFE_SENSE: U401.12 (P0.26); also elsewhere on the board
MTX_SCK: U401.20 (P0.12); also elsewhere on the board
NFC_FD: U401.38 (P1.02); also elsewhere on the board
NFC_PWR: U401.36 (P1.00); also elsewhere on the board
NFC_SCL: U401.34 (P0.22); also elsewhere on the board
NFC_SDA: U401.35 (P0.24); also elsewhere on the board
PDM_CLK: U401.32 (P0.20); also elsewhere on the board
PDM_DIN: U401.33 (P0.13); also elsewhere on the board
PWR_SW_N: U401.6 (P1.13); also elsewhere on the board
STATUS_LED: U401.4 (P0.28/AIN4); also elsewhere on the board
SWDCLK: U401.39 (SWDCLK); also elsewhere on the board
SWDIO: U401.37 (SWDIO); also elsewhere on the board
USB_DN: R403.1; also elsewhere on the board
USB_DP: R402.1; also elsewhere on the board
VBAT_MEAS_EN: U401.1 (P1.11); also elsewhere on the board
VBAT_SENSE: U401.10 (P0.30/AIN6); also elsewhere on the board
VBUS: R401.1; also elsewhere on the board
VLED_SENSE: U401.8 (P0.29/AIN5); also elsewhere on the board
nRESET: U401.26 (P0.18/RESET); also elsewhere on the board

Notes on the sheet:
MCU module (Rev A) - design notes Ebyte E73-2G4M08S1C (nRF52840, ceramic antenna, 13 x 18 x 3.0 mm), DEC-017. Normal voltage mode: VCC = VDDH = 3V3 with 4.7 uF (C401); DCCH not connected. REG1 DC/DC inductors, 32 MHz crystal and DECx/DECUSB capacitors are inside the module (Ebyte reference circuit,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

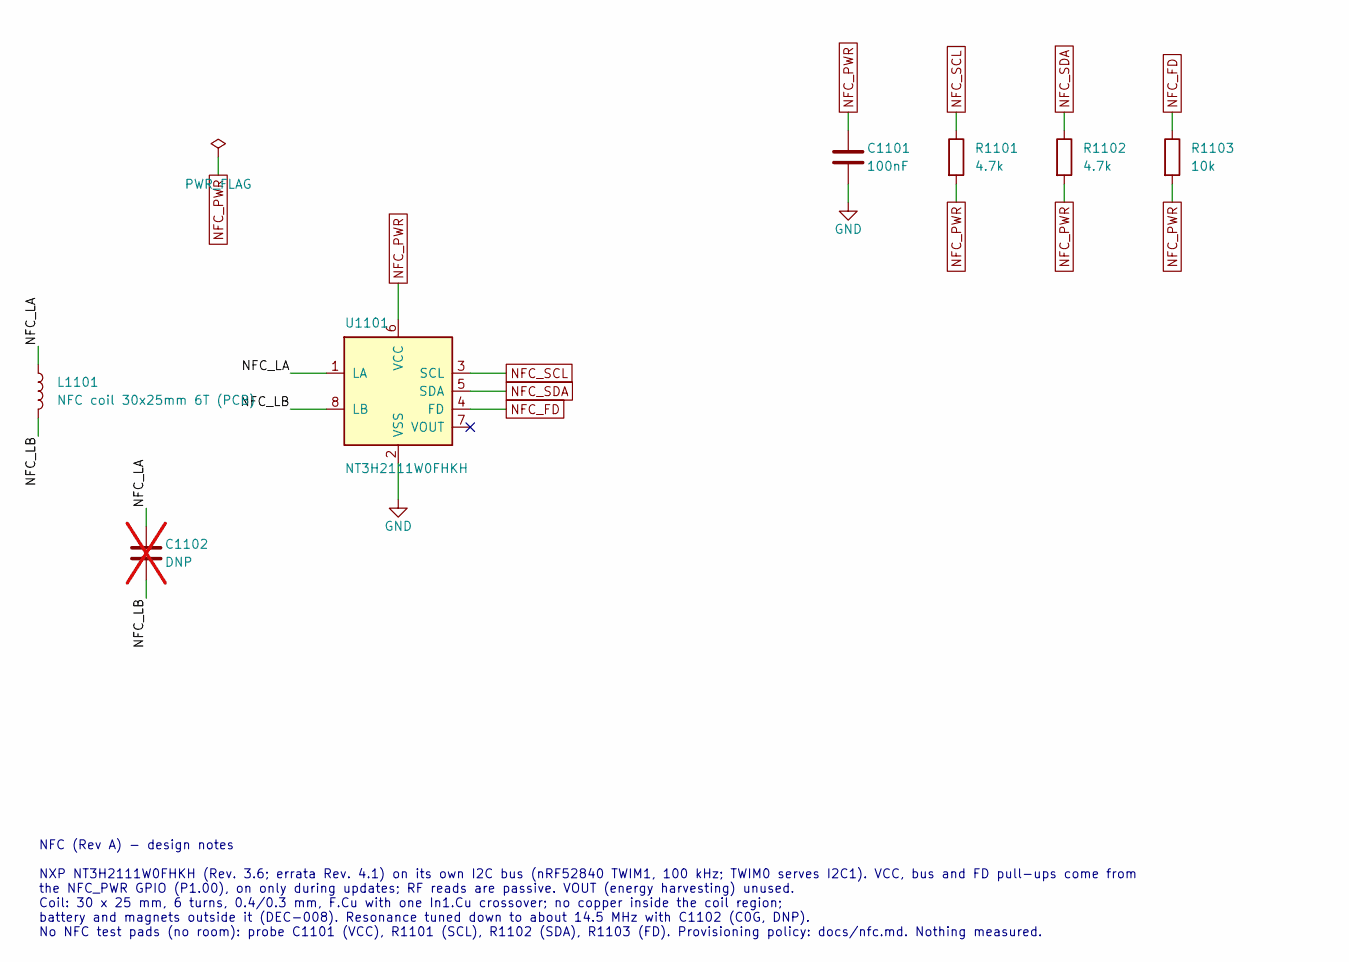
[picture p43: schematic nfc.kicad_sch]

Parts:
C1101: 100nF; C_0402_1005Metric; MPN CL05B104KO5NNNC; LCSC C1525
C1102: DNP; C_0402_1005Metric; not fitted
L1101: NFC coil 30x25mm 6T (PCB); L_NFC_Coil_30x25mm_6T
R1101, R1102: 4.7k; R_0402_1005Metric; MPN 0402WGF4701TCE; LCSC C25900
R1103: 10k; R_0402_1005Metric; MPN 0402WGF1002TCE; LCSC C25744
U1101: NT3H2111W0FHKH; NXP_XQFN-8_SOT902-3; MPN NT3H2111W0FHKH; LCSC C710403

Connections:
/NFC/NFC_LA: C1102.1, L1101.1, U1101.1 (LA)
/NFC/NFC_LB: C1102.2, L1101.2, U1101.8 (LB)
GND: C1101.2, U1101.2 (VSS); also elsewhere on the board
NFC_FD: R1103.1, U1101.4 (FD); also elsewhere on the board
NFC_PWR: C1101.1, R1101.2, R1102.2, R1103.2, U1101.6 (VCC); also elsewhere on the board
NFC_SCL: R1101.1, U1101.3 (SCL); also elsewhere on the board
NFC_SDA: R1102.1, U1101.5 (SDA); also elsewhere on the board

Notes on the sheet:
NFC (Rev A) - design notes NXP NT3H2111W0FHKH (Rev. 3.6; errata Rev. 4.1) on its own I2C bus (nRF52840 TWIM1, 100 kHz; TWIM0 serves I2C1). VCC, bus and FD pull-ups come from the NFC_PWR GPIO (P1.00), on only during updates; RF reads are passive. VOUT (energy harvesting) unused. Coil: 30 x 25 mm, 6 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

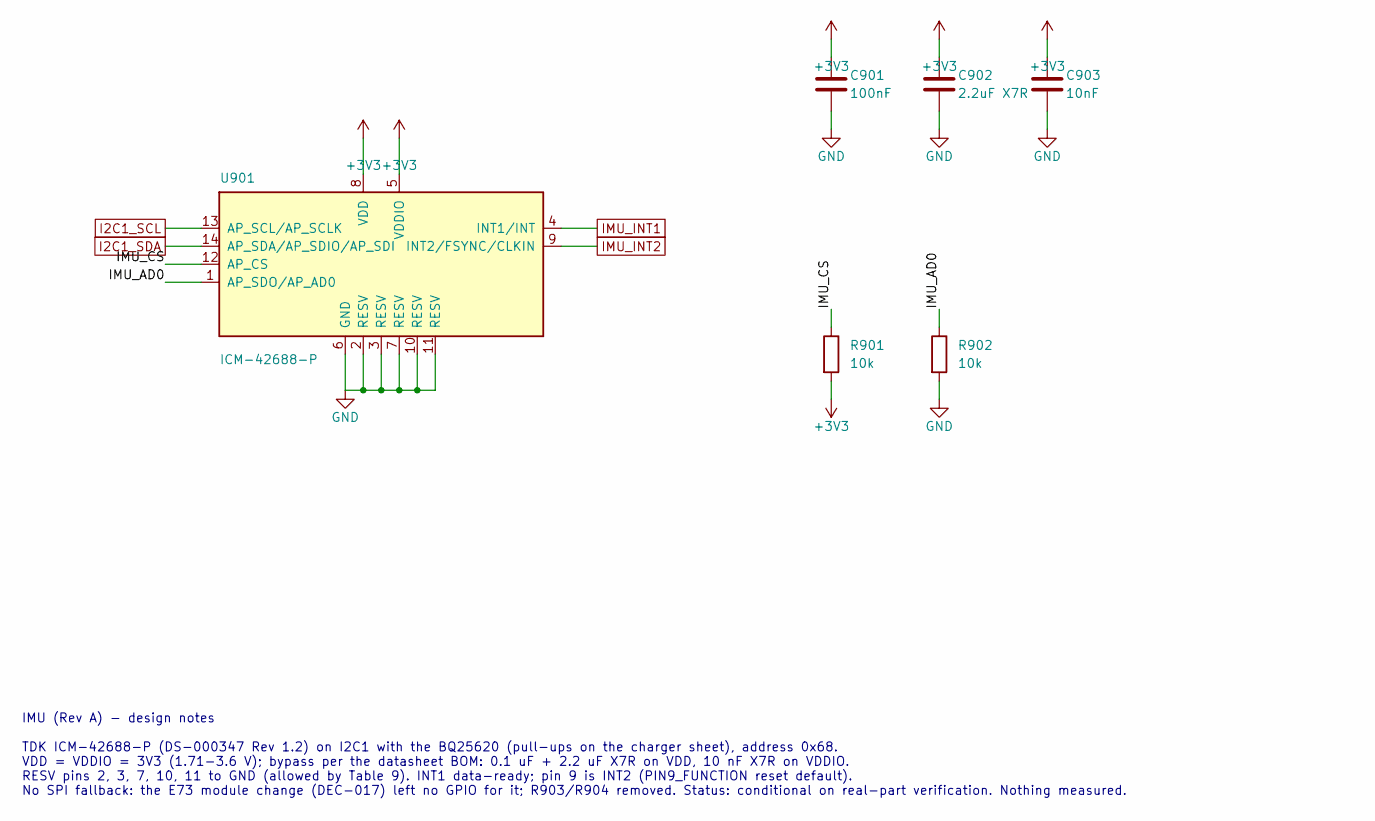
[picture p44: schematic imu.kicad_sch]

Parts:
C901: 100nF; C_0402_1005Metric; MPN CL05B104KO5NNNC; LCSC C1525
C902: 2.2uF X7R; C_0603_1608Metric; MPN 0603B225K160NT; LCSC C43922
C903: 10nF; C_0402_1005Metric; MPN CL05B103KB5NNNC; LCSC C15195
R901, R902: 10k; R_0402_1005Metric; MPN 0402WGF1002TCE; LCSC C25744
U901: ICM-42688-P; LGA-14_3x2.5mm_P0.5mm_LayoutBorder3x4y; MPN ICM-42688-P; LCSC C1850418

Connections:
+3V3: C901.1, C902.1, C903.1, R901.2, U901.5 (VDDIO), U901.8 (VDD); also elsewhere on the board
/IMU/IMU_AD0: R902.1, U901.1 (AP_SDO/AP_AD0)
/IMU/IMU_CS: R901.1, U901.12 (AP_CS)
GND: C901.2, C902.2, C903.2, R902.2, U901.2 (RESV), U901.3 (RESV), U901.6 (GND), U901.7 (RESV), U901.10 (RESV), U901.11 (RESV); also elsewhere on the board
I2C1_SCL: U901.13 (AP_SCL/AP_SCLK); also elsewhere on the board
I2C1_SDA: U901.14 (AP_SDA/AP_SDIO/AP_SDI); also elsewhere on the board
IMU_INT1: U901.4 (INT1/INT); also elsewhere on the board
IMU_INT2: U901.9 (INT2/FSYNC/CLKIN); also elsewhere on the board

Notes on the sheet:
IMU (Rev A) - design notes TDK ICM-42688-P (DS-000347 Rev 1.2) on I2C1 with the BQ25620 (pull-ups on the charger sheet), address 0x68. VDD = VDDIO = 3V3 (1.71-3.6 V); bypass per the datasheet BOM: 0.1 uF + 2.2 uF X7R on VDD, 10 nF X7R on VDDIO. RESV pins 2, 3, 7, 10, 11 to GND (allowed by Table 9).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

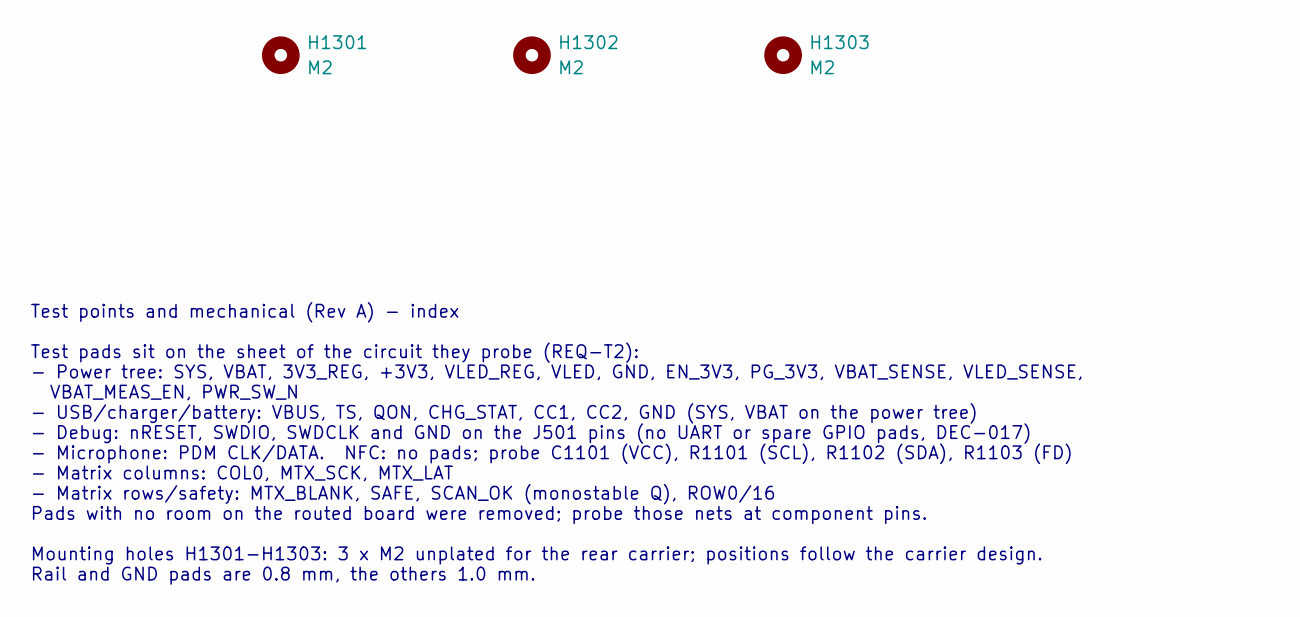
[picture p45: schematic test_points.kicad_sch, Test Points]

Parts:
H1301, H1302, H1303: M2; MountingHole_2.2mm_M2

Notes on the sheet:
Test points and mechanical (Rev A) - index Test pads sit on the sheet of the circuit they probe (REQ-T2): - Power tree: SYS, VBAT, 3V3_REG, +3V3, VLED_REG, VLED, GND, EN_3V3, PG_3V3, VBAT_SENSE, VLED_SENSE, VBAT_MEAS_EN, PWR_SW_N - USB/charger/battery: VBUS, TS, QON, CHG_STAT, CC1, CC2, GND (SYS, V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

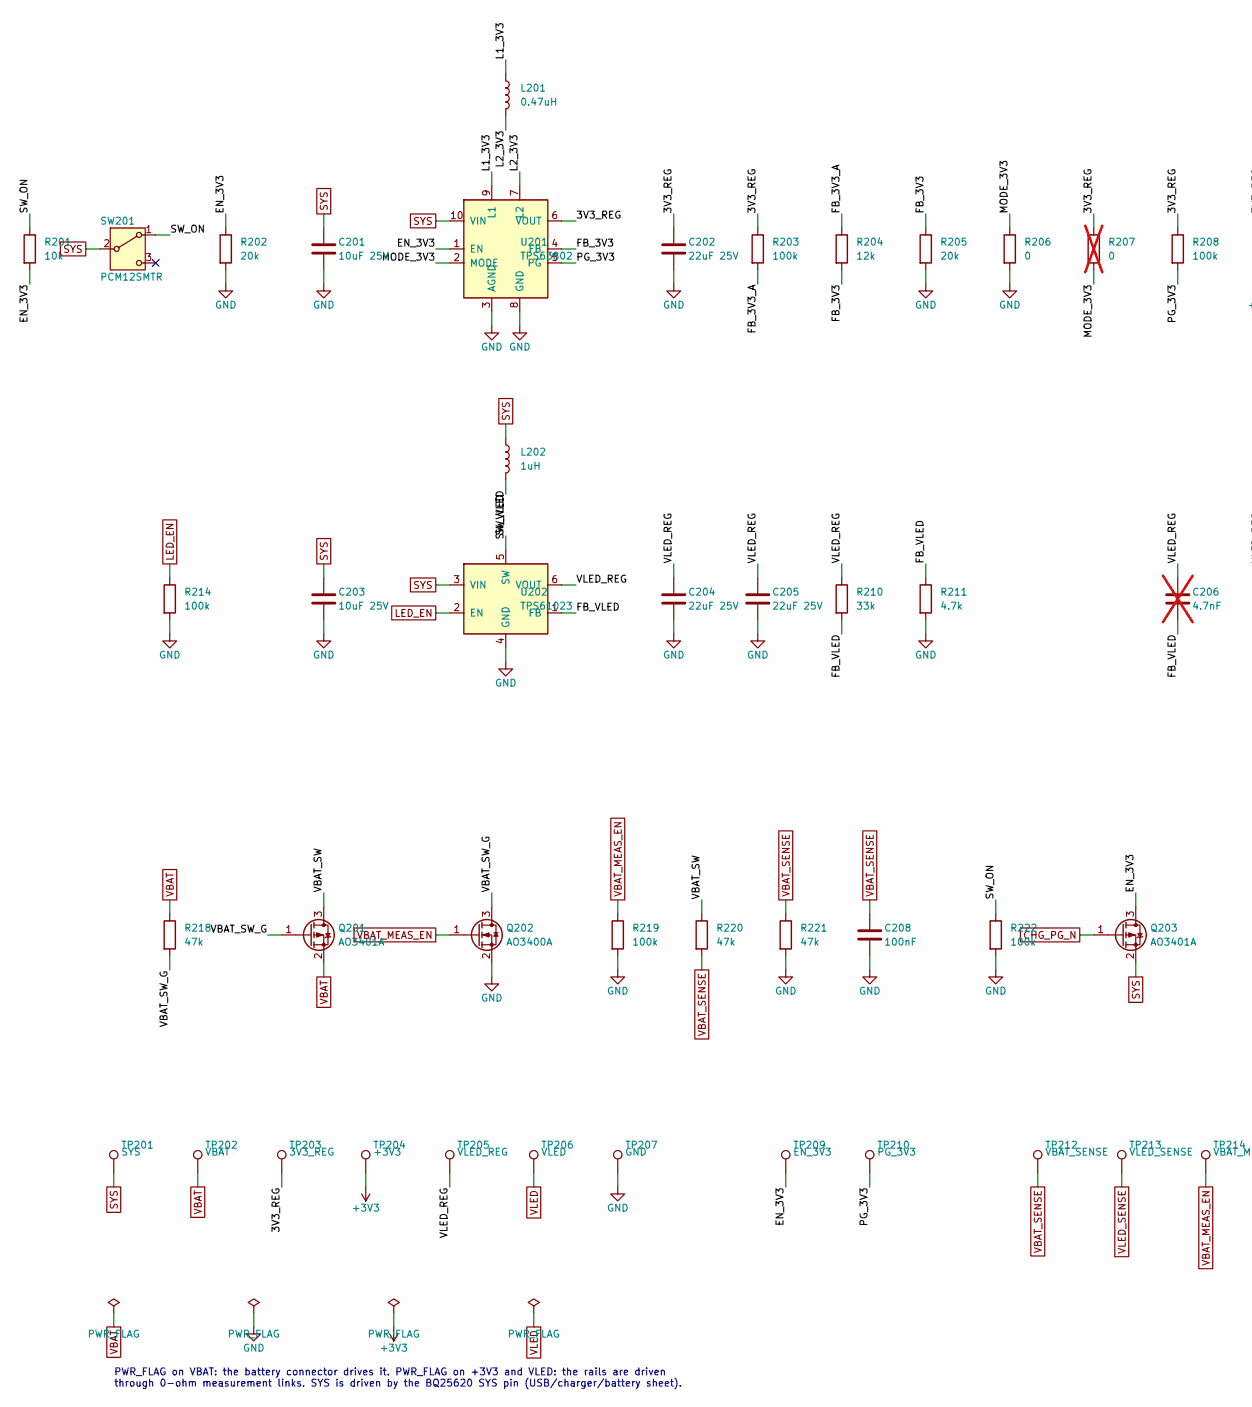
[picture p46: schematic power_tree.kicad_sch, Regulators and Power Tree, part in row 1, column 1]

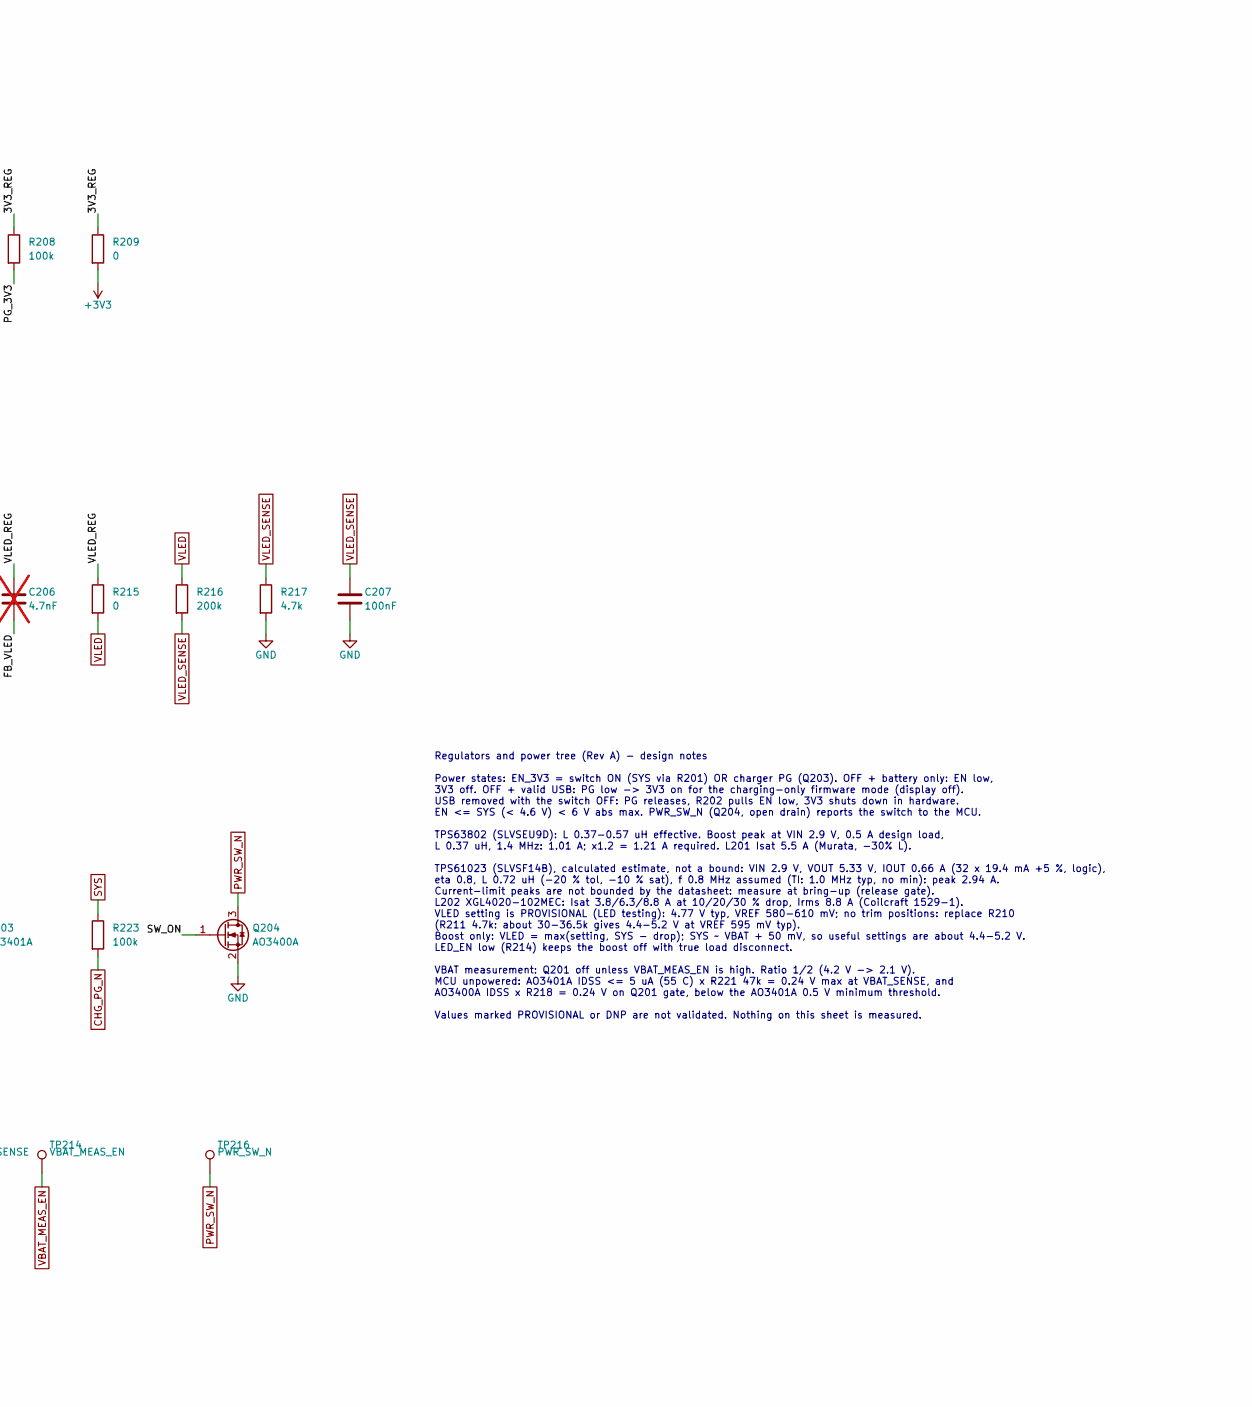
[picture p47: schematic power_tree.kicad_sch, Regulators and Power Tree, part in row 1, column 2]

Parts:
C201, C203: 10uF 25V; C_0805_2012Metric; MPN CL21A106KAYNNNE; LCSC C15850
C202, C204, C205: 22uF 25V; C_0805_2012Metric; MPN CL21A226MAQNNNE; LCSC C45783
C206: 4.7nF; C_0402_1005Metric; not fitted
C207, C208: 100nF; C_0402_1005Metric; MPN CL05B104KO5NNNC; LCSC C1525
L201: 0.47uH; L_Murata_DFE201612E; MPN DFE201612E-R47M=P2; LCSC C668312
L202: 1uH; L_Coilcraft_XGL4020; MPN XGL4020-102MEC; LCSC C5357696
Q201, Q203: AO3401A; SOT-23; MPN AO3401A; LCSC C15127
Q202, Q204: AO3400A; SOT-23; MPN AO3400A; LCSC C20917
R201: 10k; R_0402_1005Metric; MPN 0402WGF1002TCE; LCSC C25744
R202, R205: 20k; R_0402_1005Metric; MPN 0402WGF2002TCE; LCSC C25765
R203, R208, R214, R219, R222, R223: 100k; R_0402_1005Metric; MPN 0402WGF1003TCE; LCSC C25741
R204: 12k; R_0402_1005Metric; MPN 0402WGF1202TCE; LCSC C25752
R206: 0; R_0402_1005Metric; MPN 0402WGF0000TCE; LCSC C17168
R207: 0; R_0402_1005Metric; not fitted
R209, R215: 0; R_0805_2012Metric; MPN 0805W8F0000T5E; LCSC C17477
R210: 33k; R_0402_1005Metric; MPN 0402WGF3302TCE; LCSC C25779
R211, R217: 4.7k; R_0402_1005Metric; MPN 0402WGF4701TCE; LCSC C25900
R216: 200k; R_0402_1005Metric; MPN 0402WGF2003TCE; LCSC C25764
R218, R220, R221: 47k; R_0402_1005Metric; MPN 0402WGF4702TCE; LCSC C25792
SW201: PCM12SMTR; SW_SPDT_PCM12; MPN PCM12SMTR; LCSC C221841
TP201: SYS; TestPoint_Pad_D0.8mm
TP202: VBAT; TestPoint_Pad_D0.8mm
TP203: 3V3_REG; TestPoint_Pad_D0.8mm
TP204: +3V3; TestPoint_Pad_D0.8mm
TP205: VLED_REG; TestPoint_Pad_D0.8mm
TP206: VLED; TestPoint_Pad_D0.8mm
TP207: GND; TestPoint_Pad_D0.8mm
TP209: EN_3V3; TestPoint_Pad_D1.0mm
TP210: PG_3V3; TestPoint_Pad_D1.0mm
TP212: VBAT_SENSE; TestPoint_Pad_D1.0mm
TP213: VLED_SENSE; TestPoint_Pad_D1.0mm
TP214: VBAT_MEAS_EN; TestPoint_Pad_D1.0mm
TP216: PWR_SW_N; TestPoint_Pad_D1.0mm
U201: TPS63802; Texas_DLA0010A; MPN TPS63802DLAR; LCSC C2845237
U202: TPS61023; Texas_DRL0006A; MPN TPS61023DRLR; LCSC C919459

Connections:
+3V3: R209.2, TP204.1; also elsewhere on the board
/Regulators and Power Tree/3V3_REG: C202.1, R203.1, R207.1, R208.1, R209.1, TP203.1, U201.6 (VOUT)
/Regulators and Power Tree/EN_3V3: Q203.3 (D), R201.2, R202.1, TP209.1, U201.1 (EN)
/Regulators and Power Tree/FB_3V3: R204.2, R205.1, U201.4 (FB)
/Regulators and Power Tree/FB_3V3_A: R203.2, R204.1
/Regulators and Power Tree/FB_VLED: C206.2, R210.2, R211.1, U202.1 (FB)
/Regulators and Power Tree/L1_3V3: L201.1, U201.9 (L1)
/Regulators and Power Tree/L2_3V3: L201.2, U201.7 (L2)
/Regulators and Power Tree/MODE_3V3: R206.1, R207.2, U201.2 (MODE)
/Regulators and Power Tree/PG_3V3: R208.2, TP210.1, U201.5 (PG)
/Regulators and Power Tree/SW_ON: Q204.1 (G), R201.1, R222.1, SW201.1 (A)
/Regulators and Power Tree/SW_VLED: L202.2, U202.5 (SW)
/Regulators and Power Tree/VBAT_SW: Q201.3 (D), R220.1
/Regulators and Power Tree/VBAT_SW_G: Q201.1 (G), Q202.3 (D), R218.2
/Regulators and Power Tree/VLED_REG: C204.1, C205.1, C206.1, R210.1, R215.1, TP205.1, U202.6 (VOUT)
CHG_PG_N: Q203.1 (G), R223.2; also elsewhere on the board
GND: C201.2, C202.2, C203.2, C204.2, C205.2, C207.2, C208.2, Q202.2 (S), Q204.2 (S), R202.2, R205.2, R206.2, R211.2, R214.2, R217.2, R219.2, R221.2, R222.2, TP207.1, U201.3 (AGND), U201.8 (GND), U202.4 (GND); also elsewhere on the board
LED_EN: R214.1, U202.2 (EN); also elsewhere on the board
PWR_SW_N: Q204.3 (D), TP216.1; also elsewhere on the board
SYS: C201.1, C203.1, L202.1, Q203.2 (S), R223.1, SW201.2 (B), TP201.1, U201.10 (VIN), U202.3 (VIN); also elsewhere on the board
VBAT: Q201.2 (S), R218.1, TP202.1; also elsewhere on the board
VBAT_MEAS_EN: Q202.1 (G), R219.1, TP214.1; also elsewhere on the board
VBAT_SENSE: C208.1, R220.2, R221.1, TP212.1; also elsewhere on the board
VLED: R215.2, R216.1, TP206.1; also elsewhere on the board
VLED_SENSE: C207.1, R216.2, R217.1, TP213.1; also elsewhere on the board

Notes on the sheet:
PWR_FLAG on VBAT: the battery connector drives it. PWR_FLAG on +3V3 and VLED: the rails are driven through 0-ohm measurement links. SYS is driven by the BQ25620 SYS pin (USB/charger/battery sheet).
Regulators and power tree (Rev A) - design notes Power states: EN_3V3 = switch ON (SYS via R201) OR charger PG (Q203). OFF + battery only: EN low, 3V3 off. OFF + valid USB: PG low -> 3V3 on for the charging-only firmware mode (display off). USB removed with the switch OFF: PG releases, R202 pulls E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

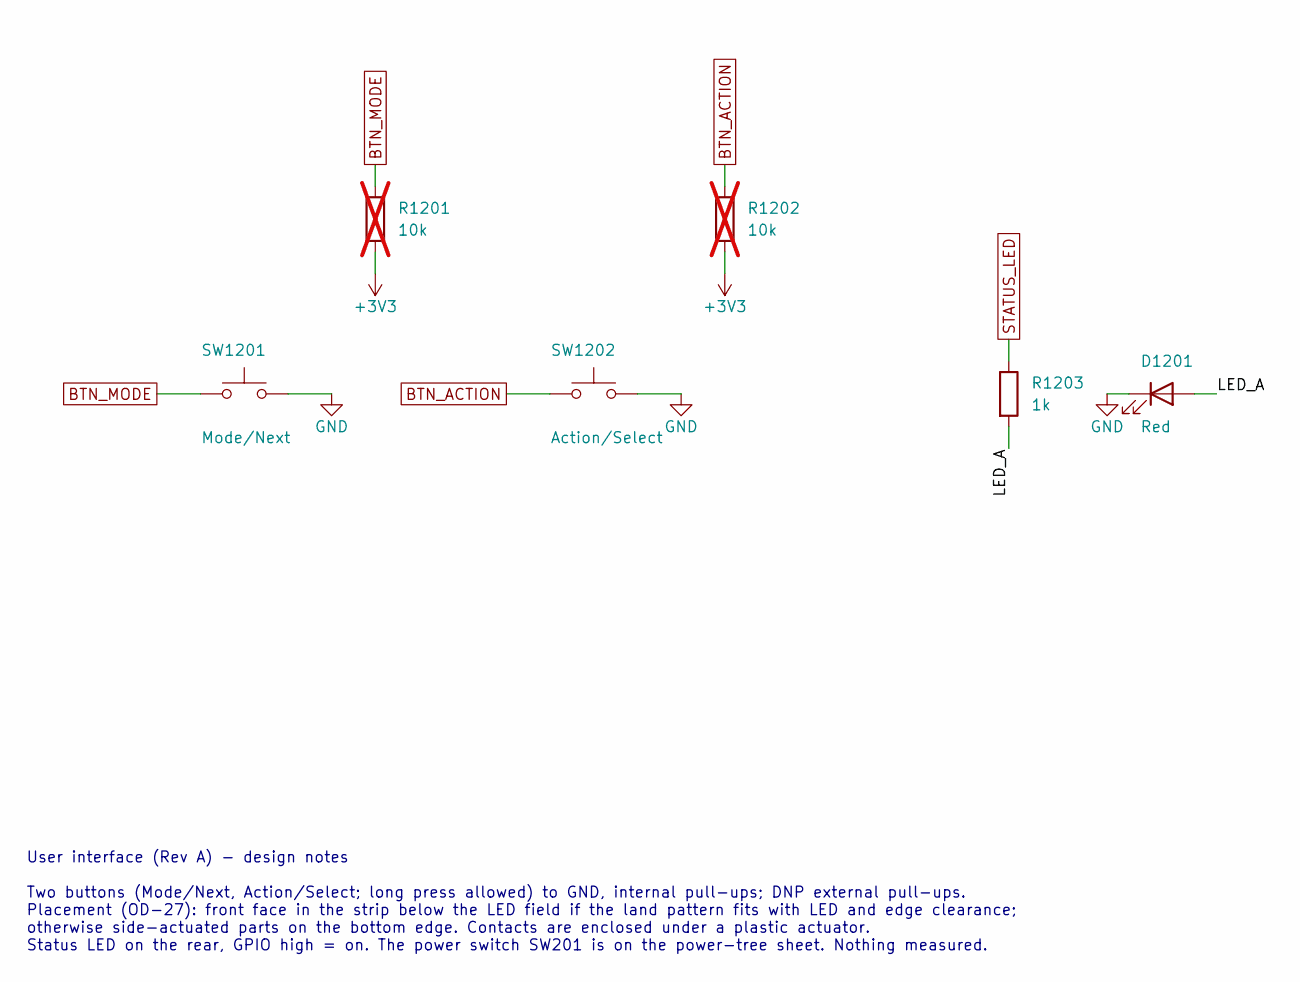
[picture p48: schematic user_interface.kicad_sch, User Interface]

Parts:
D1201: Red; LED_0603_1608Metric; MPN KT-0603R; LCSC C2286
R1201, R1202: 10k; R_0402_1005Metric; not fitted
R1203: 1k; R_0402_1005Metric; MPN 0402WGF1001TCE; LCSC C11702
SW1201: Mode/Next; SW_XUNPU_TS-1088; MPN TS-1088-AR02016; LCSC C720477
SW1202: Action/Select; SW_XUNPU_TS-1088; MPN TS-1088-AR02016; LCSC C720477

Connections:
+3V3: R1201.2, R1202.2; also elsewhere on the board
/User Interface/LED_A: D1201.2 (A), R1203.2
BTN_ACTION: R1202.1, SW1202.1; also elsewhere on the board
BTN_MODE: R1201.1, SW1201.1; also elsewhere on the board
GND: D1201.1 (K), SW1201.2, SW1202.2; also elsewhere on the board
STATUS_LED: R1203.1; also elsewhere on the board

Notes on the sheet:
User interface (Rev A) - design notes Two buttons (Mode/Next, Action/Select; long press allowed) to GND, internal pull-ups; DNP external pull-ups. Placement (OD-27): front face in the strip below the LED field if the land pattern fits with LED and edge clearance; otherwise side-actuated parts on th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
