zgeez/Pixel-Badge/hardware/smart-led-badge.kicad_pcb

## KiCad design hardware/smart-led-badge.kicad_pcb (continued)

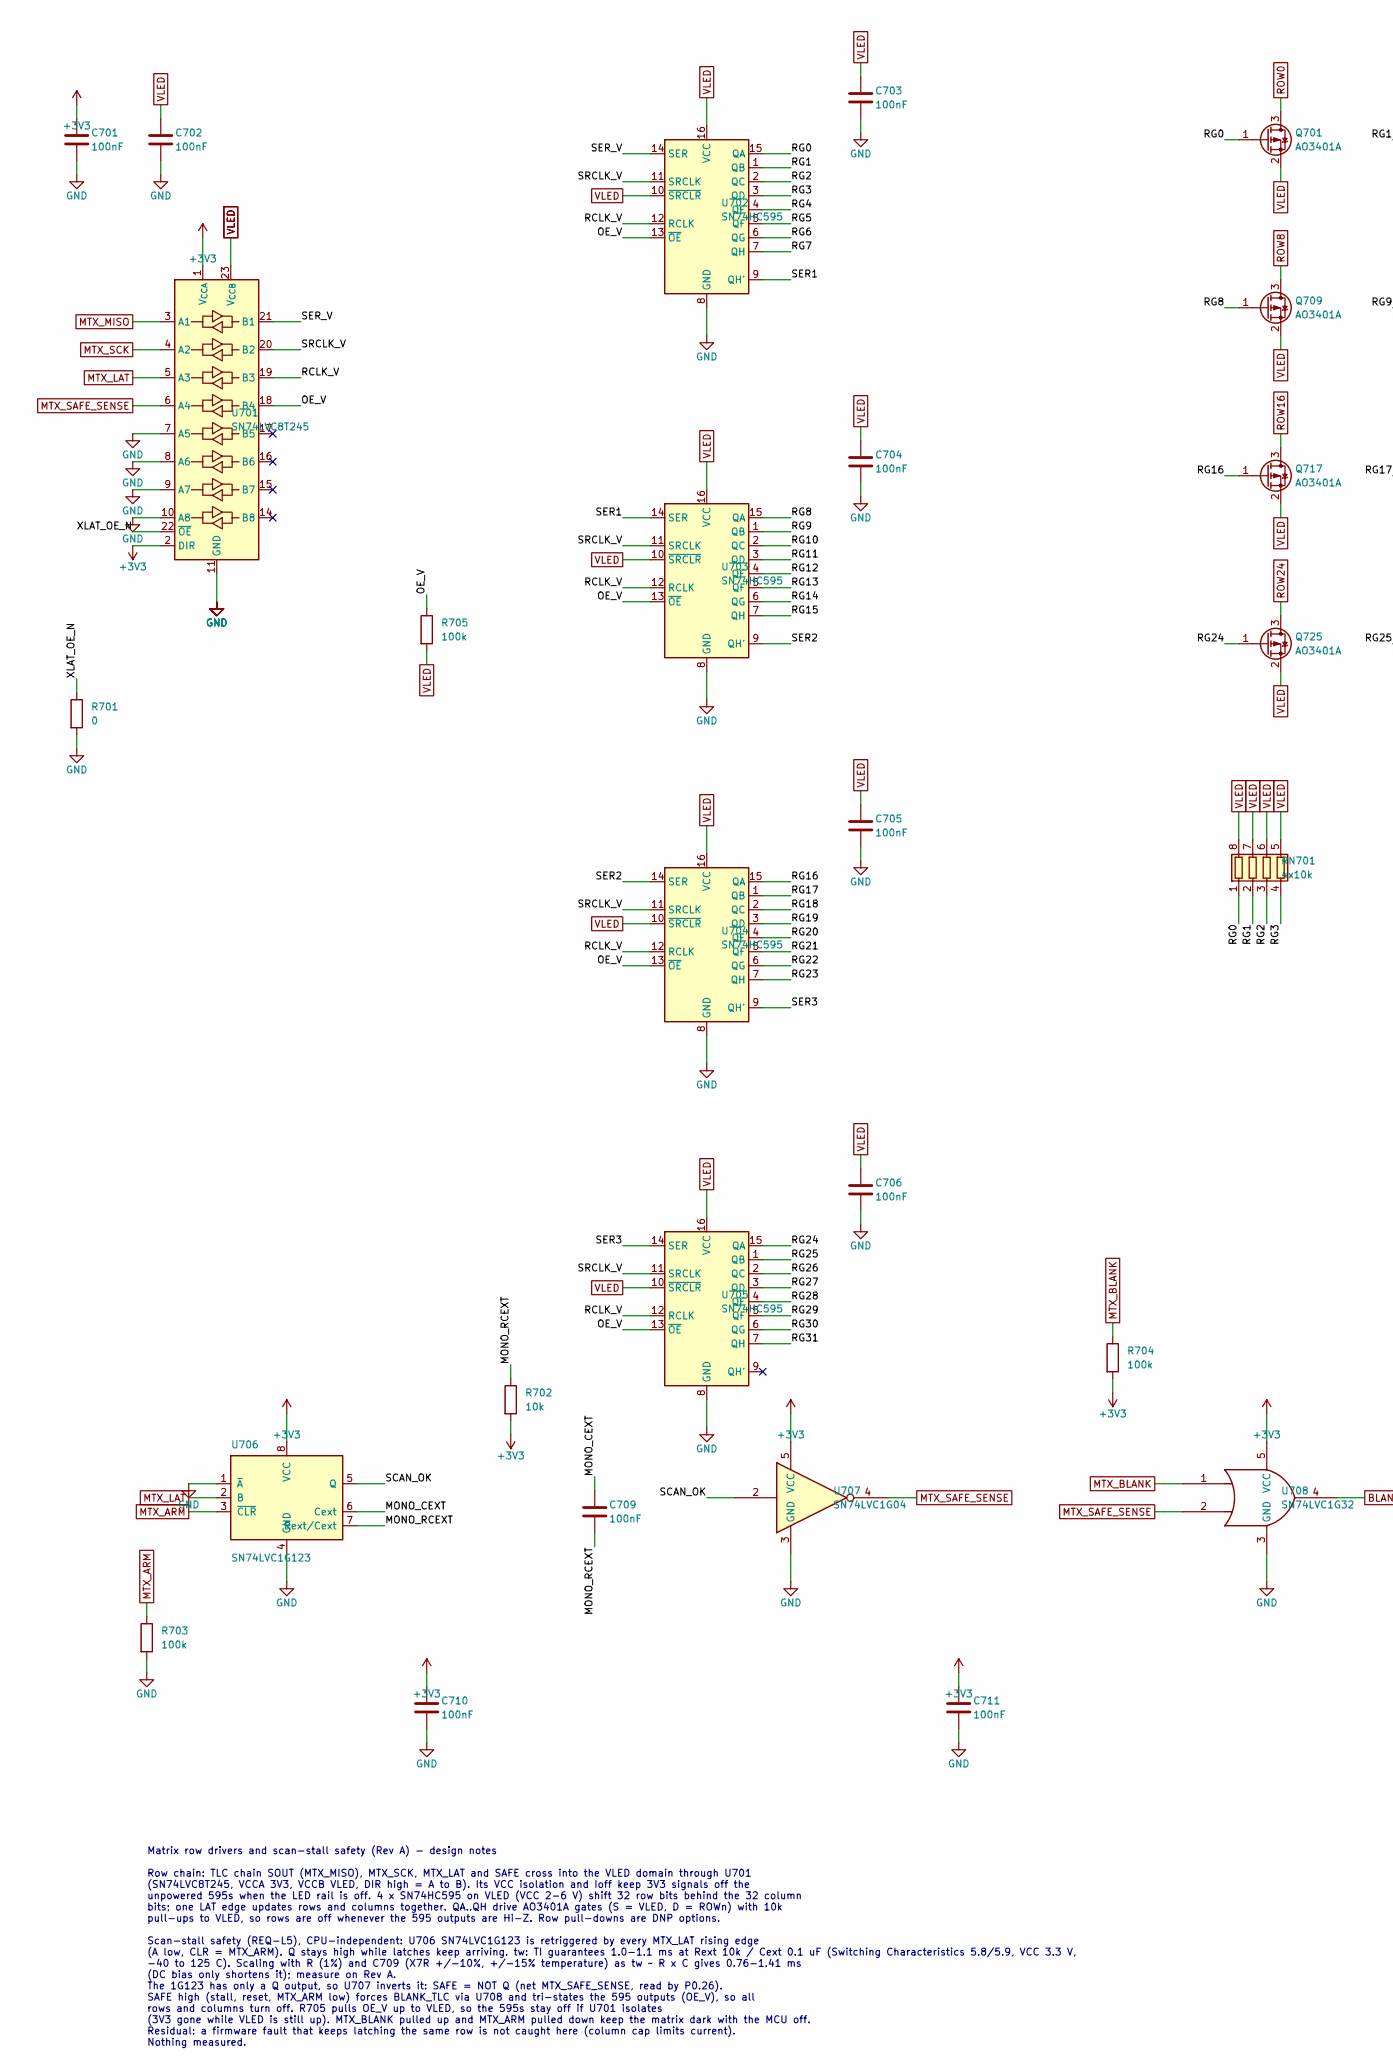
[picture p49: schematic matrix_rows.kicad_sch, Matrix Row Drivers and Safety, part in row 1, column 1]

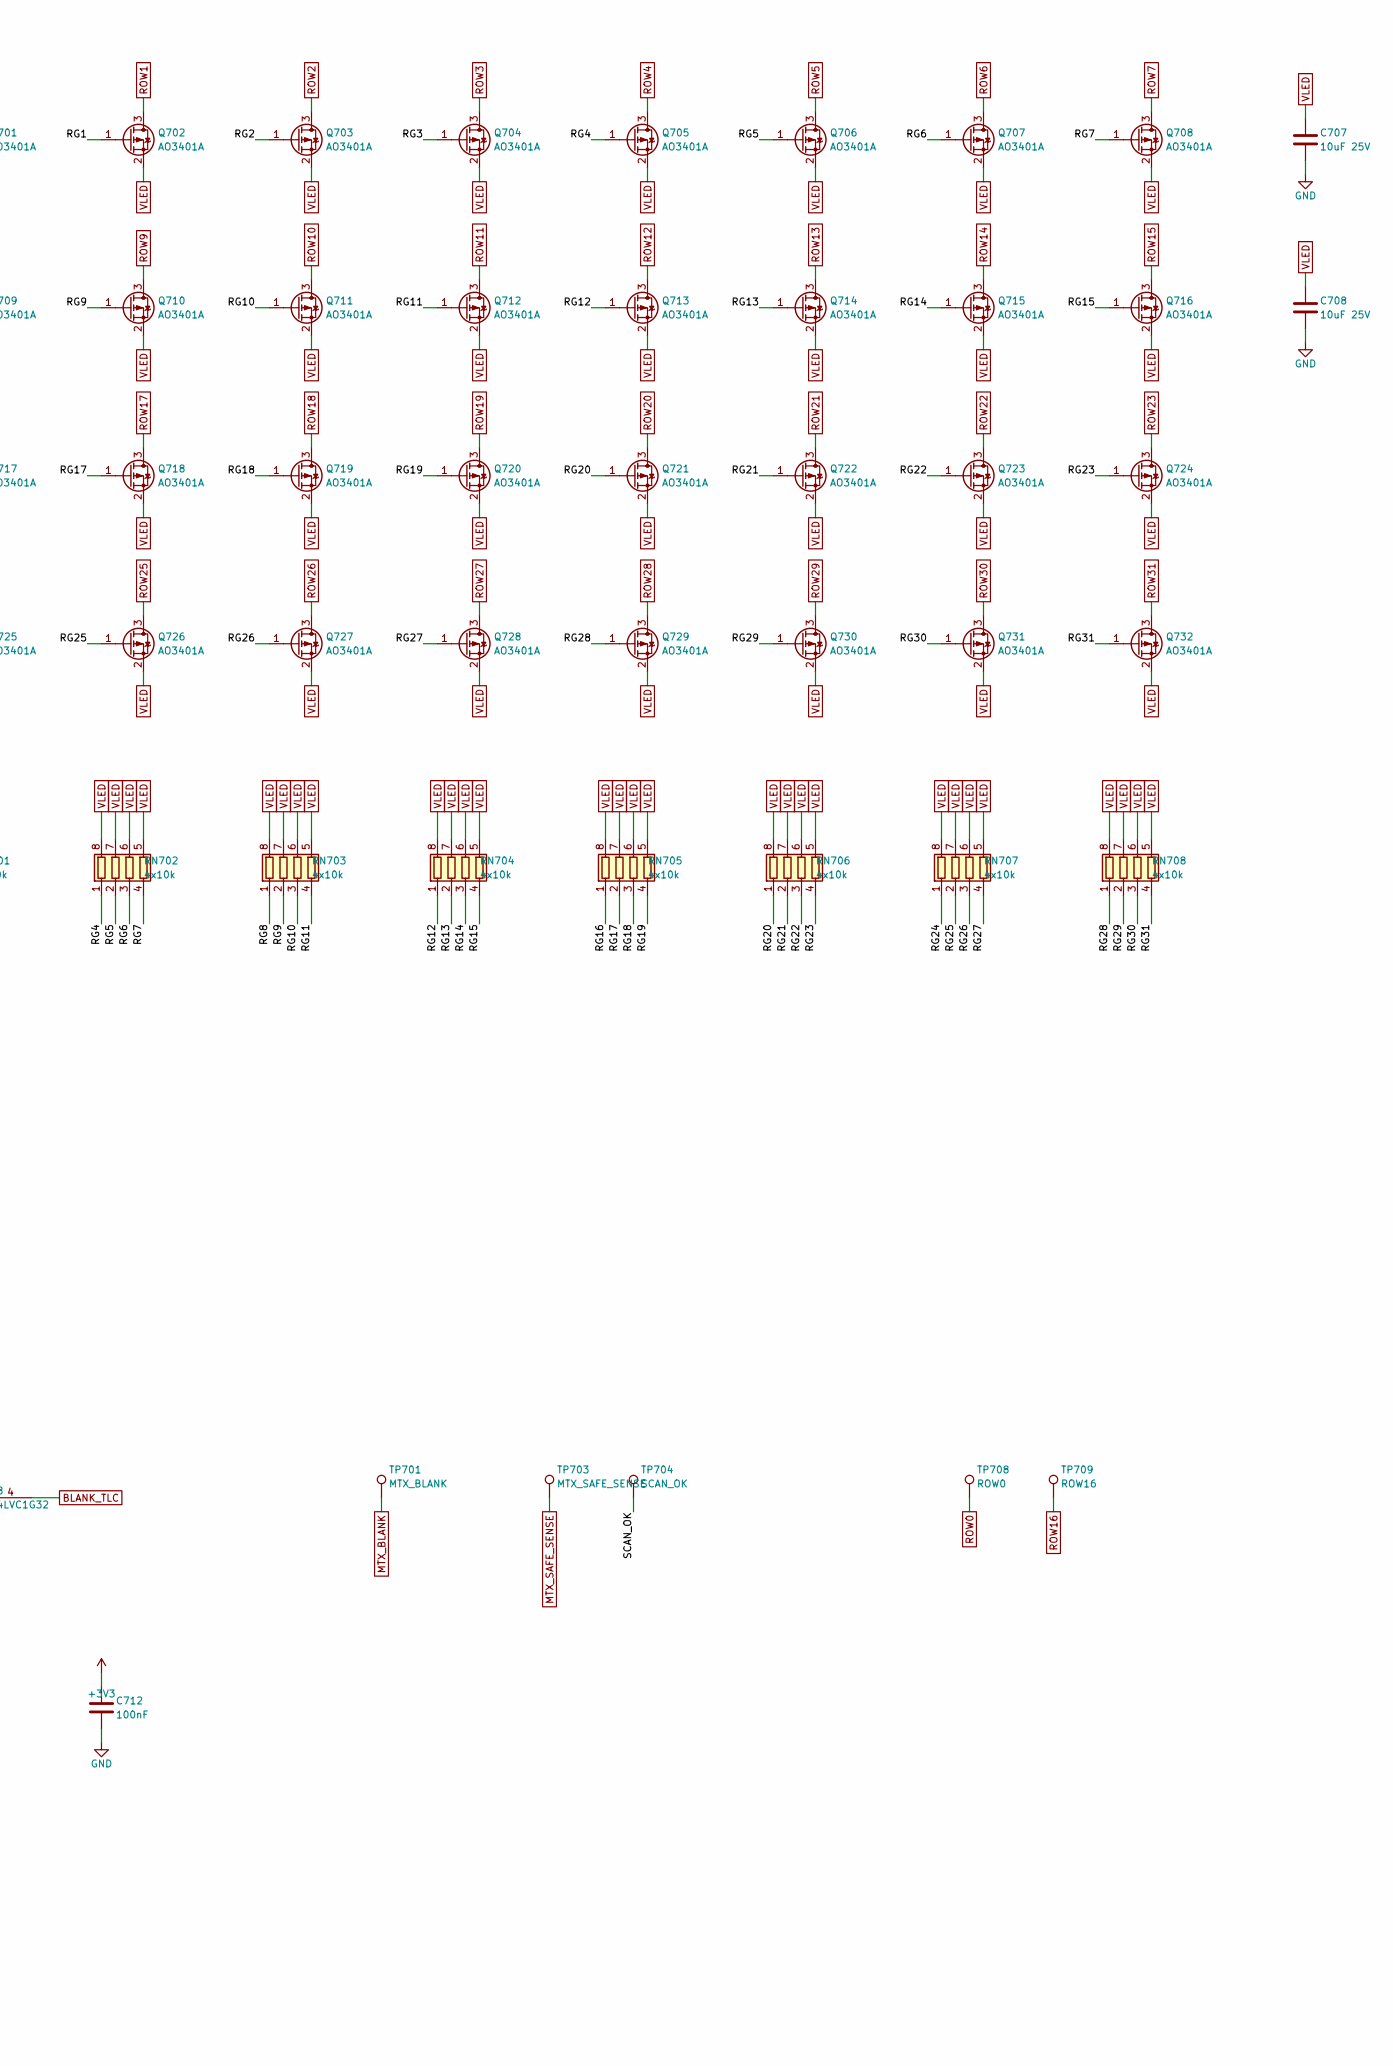
[picture p50: schematic matrix_rows.kicad_sch, Matrix Row Drivers and Safety, part in row 1, column 2]

Parts:
C701, C702, C703, C704, C705, C706, C709, C710, C711, C712: 100nF; C_0402_1005Metric; MPN CL05B104KO5NNNC; LCSC C1525
C707, C708: 10uF 25V; C_0805_2012Metric; MPN CL21A106KAYNNNE; LCSC C15850
Q701, Q702, Q703, Q704, Q705, Q706, Q707, Q708, Q709, Q710, Q711, Q712, Q713, Q714, Q715, Q716, Q717, Q718, Q719, Q720, Q721, Q722, Q723, Q724, Q725, Q726, Q727, Q728, Q729, Q730, Q731, Q732: AO3401A; SOT-23; MPN AO3401A; LCSC C15127
R701: 0; R_0402_1005Metric; MPN 0402WGF0000TCE; LCSC C17168
R702: 10k; R_0402_1005Metric; MPN 0402WGF1002TCE; LCSC C25744
R703, R704, R705: 100k; R_0402_1005Metric; MPN 0402WGF1003TCE; LCSC C25741
RN701, RN702, RN703, RN704, RN705, RN706, RN707, RN708: 4x10k; R_Array_Convex_4x0603; MPN 4D03WGJ0103T5E; LCSC C29718
TP701: MTX_BLANK; TestPoint_Pad_D1.0mm
TP703: MTX_SAFE_SENSE; TestPoint_Pad_D1.0mm
TP704: SCAN_OK; TestPoint_Pad_D1.0mm
TP708: ROW0; TestPoint_Pad_D1.0mm
TP709: ROW16; TestPoint_Pad_D1.0mm
U701: SN74LVC8T245; TSSOP-24_4.4x7.8mm_P0.65mm; MPN SN74LVC8T245PWR; LCSC C27643
U702, U703, U704, U705: SN74HC595; TSSOP-16_4.4x5mm_P0.65mm; MPN SN74HC595PWR; LCSC C273642
U706: SN74LVC1G123; SSOP-8_2.95x2.8mm_P0.65mm; MPN SN74LVC1G123DCTR; LCSC C123302
U707: SN74LVC1G04; SOT-23-5; MPN SN74LVC1G04DBVR; LCSC C7827
U708: SN74LVC1G32; SOT-23-5; MPN SN74LVC1G32DBVR; LCSC C10096

Connections:
+3V3: C701.1, C710.1, C711.1, C712.1, R702.2, R704.2, U701.1 (V_{CCA}), U701.2 (DIR), U706.8 (VCC), U707.5 (VCC), U708.5 (VCC); also elsewhere on the board
/Matrix Row Drivers and Safety/MONO_CEXT: C709.1, U706.6 (Cext)
/Matrix Row Drivers and Safety/MONO_RCEXT: C709.2, R702.1, U706.7 (Rext/Cext)
/Matrix Row Drivers and Safety/OE_V: R705.1, U701.18 (B4), U702.13 (~OE), U703.13 (~OE), U704.13 (~OE), U705.13 (~OE)
/Matrix Row Drivers and Safety/RCLK_V: U701.19 (B3), U702.12 (RCLK), U703.12 (RCLK), U704.12 (RCLK), U705.12 (RCLK)
/Matrix Row Drivers and Safety/RG0: Q701.1 (G), RN701.1 (R1.1), U702.15 (QA)
/Matrix Row Drivers and Safety/RG1: Q702.1 (G), RN701.2 (R2.1), U702.1 (QB)
/Matrix Row Drivers and Safety/RG2: Q703.1 (G), RN701.3 (R3.1), U702.2 (QC)
/Matrix Row Drivers and Safety/RG3: Q704.1 (G), RN701.4 (R4.1), U702.3 (QD)
/Matrix Row Drivers and Safety/RG4: Q705.1 (G), RN702.1 (R1.1), U702.4 (QE)
/Matrix Row Drivers and Safety/RG5: Q706.1 (G), RN702.2 (R2.1), U702.5 (QF)
/Matrix Row Drivers and Safety/RG6: Q707.1 (G), RN702.3 (R3.1), U702.6 (QG)
/Matrix Row Drivers and Safety/RG7: Q708.1 (G), RN702.4 (R4.1), U702.7 (QH)
/Matrix Row Drivers and Safety/RG8: Q709.1 (G), RN703.1 (R1.1), U703.15 (QA)
/Matrix Row Drivers and Safety/RG9: Q710.1 (G), RN703.2 (R2.1), U703.1 (QB)
/Matrix Row Drivers and Safety/RG10: Q711.1 (G), RN703.3 (R3.1), U703.2 (QC)
/Matrix Row Drivers and Safety/RG11: Q712.1 (G), RN703.4 (R4.1), U703.3 (QD)
/Matrix Row Drivers and Safety/RG12: Q713.1 (G), RN704.1 (R1.1), U703.4 (QE)
/Matrix Row Drivers and Safety/RG13: Q714.1 (G), RN704.2 (R2.1), U703.5 (QF)
/Matrix Row Drivers and Safety/RG14: Q715.1 (G), RN704.3 (R3.1), U703.6 (QG)
/Matrix Row Drivers and Safety/RG15: Q716.1 (G), RN704.4 (R4.1), U703.7 (QH)
/Matrix Row Drivers and Safety/RG16: Q717.1 (G), RN705.1 (R1.1), U704.15 (QA)
/Matrix Row Drivers and Safety/RG17: Q718.1 (G), RN705.2 (R2.1), U704.1 (QB)
/Matrix Row Drivers and Safety/RG18: Q719.1 (G), RN705.3 (R3.1), U704.2 (QC)
/Matrix Row Drivers and Safety/RG19: Q720.1 (G), RN705.4 (R4.1), U704.3 (QD)
/Matrix Row Drivers and Safety/RG20: Q721.1 (G), RN706.1 (R1.1), U704.4 (QE)
/Matrix Row Drivers and Safety/RG21: Q722.1 (G), RN706.2 (R2.1), U704.5 (QF)
/Matrix Row Drivers and Safety/RG22: Q723.1 (G), RN706.3 (R3.1), U704.6 (QG)
/Matrix Row Drivers and Safety/RG23: Q724.1 (G), RN706.4 (R4.1), U704.7 (QH)
/Matrix Row Drivers and Safety/RG24: Q725.1 (G), RN707.1 (R1.1), U705.15 (QA)
/Matrix Row Drivers and Safety/RG25: Q726.1 (G), RN707.2 (R2.1), U705.1 (QB)
/Matrix Row Drivers and Safety/RG26: Q727.1 (G), RN707.3 (R3.1), U705.2 (QC)
/Matrix Row Drivers and Safety/RG27: Q728.1 (G), RN707.4 (R4.1), U705.3 (QD)
/Matrix Row Drivers and Safety/RG28: Q729.1 (G), RN708.1 (R1.1), U705.4 (QE)
/Matrix Row Drivers and Safety/RG29: Q730.1 (G), RN708.2 (R2.1), U705.5 (QF)
/Matrix Row Drivers and Safety/RG30: Q731.1 (G), RN708.3 (R3.1), U705.6 (QG)
/Matrix Row Drivers and Safety/RG31: Q732.1 (G), RN708.4 (R4.1), U705.7 (QH)
/Matrix Row Drivers and Safety/SCAN_OK: TP704.1, U706.5 (Q), U707.2
/Matrix Row Drivers and Safety/SER1: U702.9 (QH'), U703.14 (SER)
/Matrix Row Drivers and Safety/SER2: U703.9 (QH'), U704.14 (SER)
/Matrix Row Drivers and Safety/SER3: U704.9 (QH'), U705.14 (SER)
/Matrix Row Drivers and Safety/SER_V: U701.21 (B1), U702.14 (SER)
/Matrix Row Drivers and Safety/SRCLK_V: U701.20 (B2), U702.11 (SRCLK), U703.11 (SRCLK), U704.11 (SRCLK), U705.11 (SRCLK)
/Matrix Row Drivers and Safety/XLAT_OE_N: R701.1, U701.22 (~OE)
BLANK_TLC: U708.4; also elsewhere on the board
GND: C701.2, C702.2, C703.2, C704.2, C705.2, C706.2, C707.2, C708.2, C710.2, C711.2, C712.2, R701.2, R703.2, U701.7 (A5), U701.8 (A6), U701.9 (A7), U701.10 (A8), U701.11 (GND), U701.12 (GND), U701.13 (GND), U702.8 (GND), U703.8 (GND), U704.8 (GND), U705.8 (GND), U706.1 (~A), U706.4 (GND), U707.3 (GND), U708.3 (GND); also elsewhere on the board
MTX_ARM: R703.1, U706.3 (~CLR); also elsewhere on the board
MTX_BLANK: R704.1, TP701.1, U708.1; also elsewhere on the board
MTX_LAT: U701.5 (A3), U706.2 (B); also elsewhere on the board
MTX_MISO: U701.3 (A1); also elsewhere on the board
MTX_SAFE_SENSE: TP703.1, U701.6 (A4), U707.4, U708.2; also elsewhere on the board
MTX_SCK: U701.4 (A2); also elsewhere on the board
ROW0: Q701.3 (D), TP708.1; also elsewhere on the board
ROW1: Q702.3 (D); also elsewhere on the board
ROW2: Q703.3 (D); also elsewhere on the board
ROW3: Q704.3 (D); also elsewhere on the board
ROW4: Q705.3 (D); also elsewhere on the board
ROW5: Q706.3 (D); also elsewhere on the board
ROW6: Q707.3 (D); also elsewhere on the board
ROW7: Q708.3 (D); also elsewhere on the board
ROW8: Q709.3 (D); also elsewhere on the board
ROW9: Q710.3 (D); also elsewhere on the board
ROW10: Q711.3 (D); also elsewhere on the board
ROW11: Q712.3 (D); also elsewhere on the board
ROW12: Q713.3 (D); also elsewhere on the board
ROW13: Q714.3 (D); also elsewhere on the board
ROW14: Q715.3 (D); also elsewhere on the board
ROW15: Q716.3 (D); also elsewhere on the board
ROW16: Q717.3 (D), TP709.1; also elsewhere on the board
ROW17: Q718.3 (D); also elsewhere on the board
ROW18: Q719.3 (D); also elsewhere on the board
ROW19: Q720.3 (D); also elsewhere on the board
ROW20: Q721.3 (D); also elsewhere on the board
ROW21: Q722.3 (D); also elsewhere on the board
ROW22: Q723.3 (D); also elsewhere on the board
ROW23: Q724.3 (D); also elsewhere on the board
ROW24: Q725.3 (D); also elsewhere on the board
ROW25: Q726.3 (D); also elsewhere on the board
ROW26: Q727.3 (D); also elsewhere on the board
ROW27: Q728.3 (D); also elsewhere on the board
ROW28: Q729.3 (D); also elsewhere on the board
ROW29: Q730.3 (D); also elsewhere on the board
ROW30: Q731.3 (D); also elsewhere on the board
ROW31: Q732.3 (D); also elsewhere on the board
VLED: C702.1, C703.1, C704.1, C705.1, C706.1, C707.1, C708.1, Q701.2 (S), Q702.2 (S), Q703.2 (S), Q704.2 (S), Q705.2 (S), Q706.2 (S), Q707.2 (S), Q708.2 (S), Q709.2 (S), Q710.2 (S), Q711.2 (S), Q712.2 (S), Q713.2 (S), Q714.2 (S), Q715.2 (S), Q716.2 (S), Q717.2 (S), Q718.2 (S), Q719.2 (S), Q720.2 (S), Q721.2 (S), Q722.2 (S), Q723.2 (S), Q724.2 (S), Q725.2 (S), Q726.2 (S), Q727.2 (S), Q728.2 (S), Q729.2 (S), Q730.2 (S), Q731.2 (S), Q732.2 (S), R705.2, RN701.5 (R4.2), RN701.6 (R3.2), RN701.7 (R2.2), RN701.8 (R1.2), RN702.5 (R4.2), RN702.6 (R3.2), RN702.7 (R2.2), RN702.8 (R1.2), RN703.5 (R4.2), RN703.6 (R3.2), RN703.7 (R2.2), RN703.8 (R1.2), RN704.5 (R4.2), RN704.6 (R3.2), RN704.7 (R2.2), RN704.8 (R1.2), RN705.5 (R4.2), RN705.6 (R3.2), RN705.7 (R2.2), RN705.8 (R1.2), RN706.5 (R4.2), RN706.6 (R3.2), RN706.7 (R2.2), RN706.8 (R1.2), RN707.5 (R4.2), RN707.6 (R3.2), RN707.7 (R2.2), RN707.8 (R1.2), RN708.5 (R4.2), RN708.6 (R3.2), RN708.7 (R2.2), RN708.8 (R1.2), U701.23 (V_{CCB}), U701.24 (V_{CCB}), U702.10 (~SRCLR), U702.16 (VCC), U703.10 (~SRCLR), U703.16 (VCC), U704.10 (~SRCLR), U704.16 (VCC), U705.10 (~SRCLR), U705.16 (VCC); also elsewhere on the board

Notes on the sheet:
Matrix row drivers and scan-stall safety (Rev A) - design notes Row chain: TLC chain SOUT (MTX_MISO), MTX_SCK, MTX_LAT and SAFE cross into the VLED domain through U701 (SN74LVC8T245, VCCA 3V3, VCCB VLED, DIR high = A to B). Its VCC isolation and Ioff keep 3V3 signals off the unpowered 595s when the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

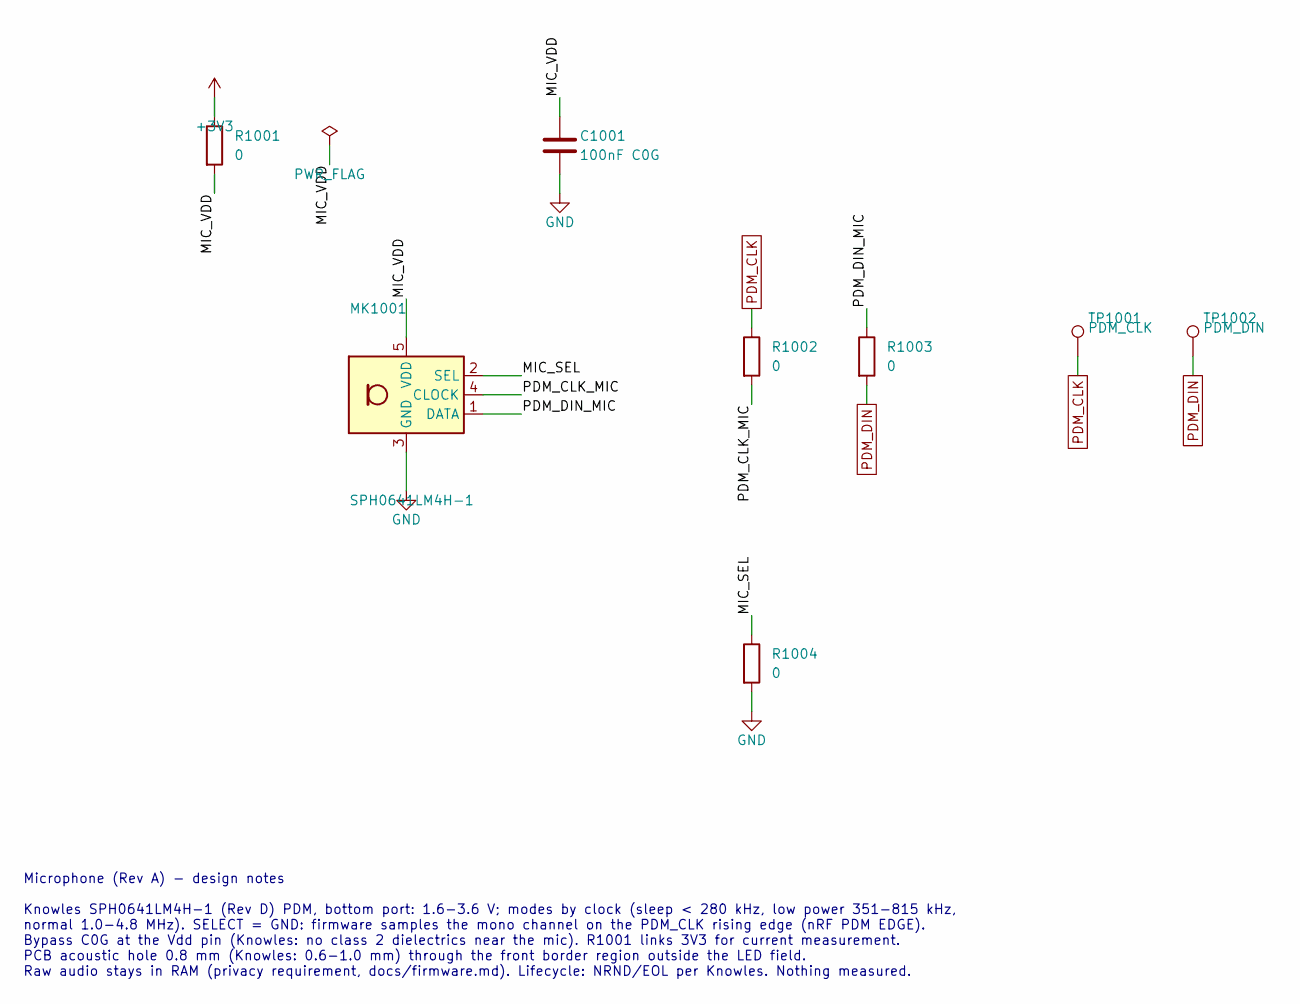
[picture p51: schematic microphone.kicad_sch]

Parts:
C1001: 100nF C0G; C_1206_3216Metric; MPN 1206N104J500CT; LCSC C170182
MK1001: SPH0641LM4H-1; Knowles_LGA-5_3.5x2.65mm_Hole0.6mm; MPN SPH0641LM4H-1; LCSC C497724
R1001, R1002, R1003, R1004: 0; R_0402_1005Metric; MPN 0402WGF0000TCE; LCSC C17168
TP1001: PDM_CLK; TestPoint_Pad_D1.0mm
TP1002: PDM_DIN; TestPoint_Pad_D1.0mm

Connections:
+3V3: R1001.1; also elsewhere on the board
/Microphone/MIC_SEL: MK1001.2 (SEL), R1004.1
/Microphone/MIC_VDD: C1001.1, MK1001.5 (VDD), R1001.2
/Microphone/PDM_CLK_MIC: MK1001.4 (CLOCK), R1002.2
/Microphone/PDM_DIN_MIC: MK1001.1 (DATA), R1003.1
GND: C1001.2, MK1001.3 (GND), R1004.2; also elsewhere on the board
PDM_CLK: R1002.1, TP1001.1; also elsewhere on the board
PDM_DIN: R1003.2, TP1002.1; also elsewhere on the board

Notes on the sheet:
Microphone (Rev A) - design notes Knowles SPH0641LM4H-1 (Rev D) PDM, bottom port: 1.6-3.6 V; modes by clock (sleep < 280 kHz, low power 351-815 kHz, normal 1.0-4.8 MHz). SELECT = GND: firmware samples the mono channel on the PDM_CLK rising edge (nRF PDM EDGE). Bypass C0G at the Vdd pin (Knowles: no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

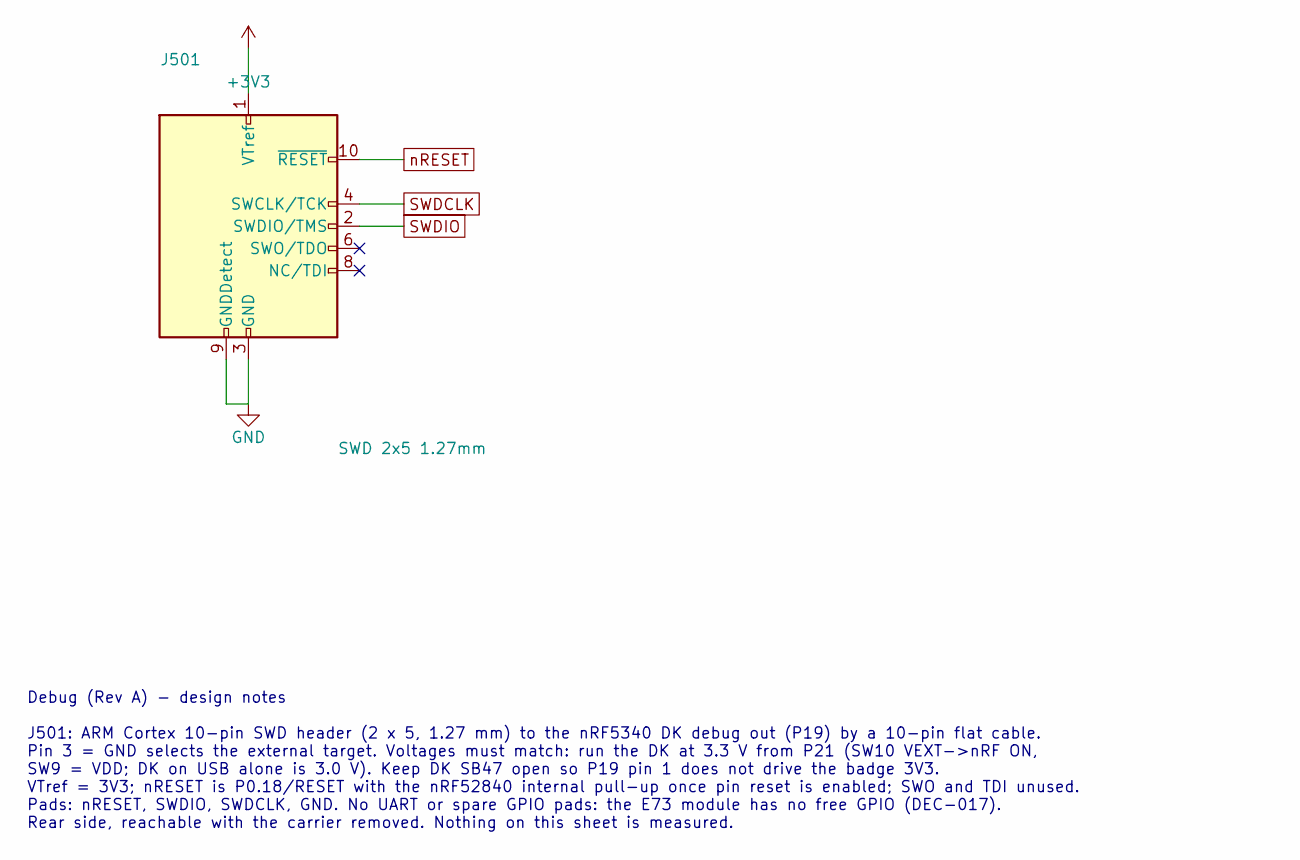
[picture p52: schematic debug.kicad_sch]

Parts:
J501: SWD 2x5 1.27mm; PinHeader_2x05_P1.27mm_Vertical_SMD; MPN HX PZ1.27-2x5P TP; LCSC C41376037

Connections:
+3V3: J501.1 (VTref); also elsewhere on the board
GND: J501.3 (GND), J501.5 (GND), J501.9 (GNDDetect); also elsewhere on the board
SWDCLK: J501.4 (SWCLK/TCK); also elsewhere on the board
SWDIO: J501.2 (SWDIO/TMS); also elsewhere on the board
nRESET: J501.10 (~RESET); also elsewhere on the board

Notes on the sheet:
Debug (Rev A) - design notes J501: ARM Cortex 10-pin SWD header (2 x 5, 1.27 mm) to the nRF5340 DK debug out (P19) by a 10-pin flat cable. Pin 3 = GND selects the external target. Voltages must match: run the DK at 3.3 V from P21 (SW10 VEXT->nRF ON, SW9 = VDD; DK on USB alone is 3.0 V). Keep DK SB4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
