zgeez/Pixel-Badge/hardware/smart-led-badge.kicad_pcb

## KiCad design hardware/smart-led-badge.kicad_pcb (continued)

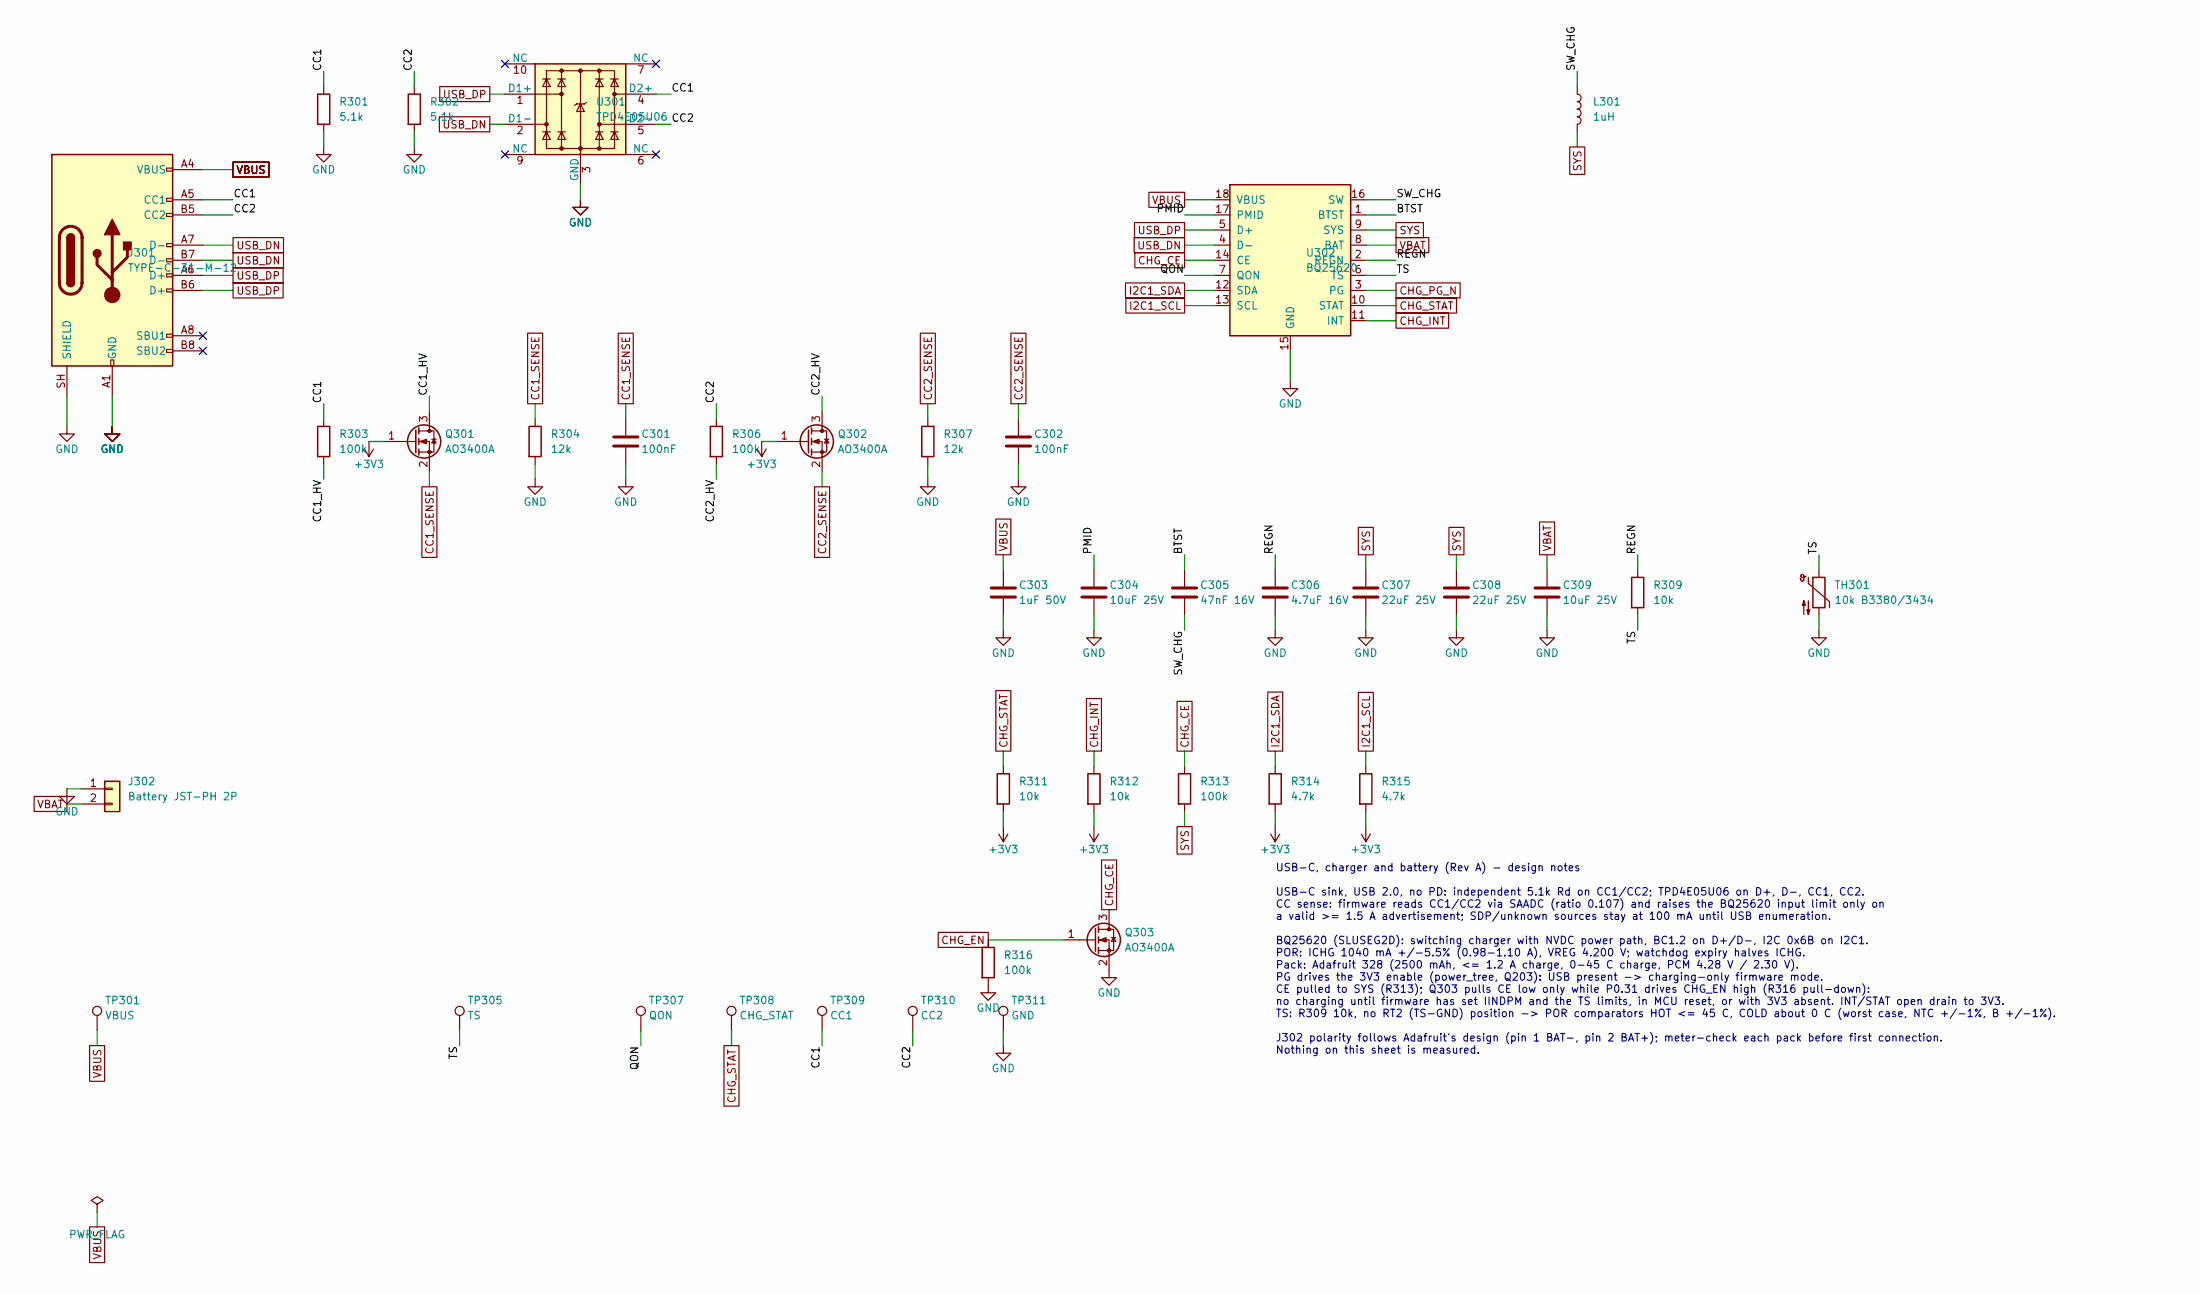
[picture p55: schematic usb_charger_battery.kicad_sch, USB Charger Battery]

Parts:
C301, C302: 100nF; C_0402_1005Metric; MPN CL05B104KO5NNNC; LCSC C1525
C303: 1uF 50V; C_0603_1608Metric; MPN CL10A105KB8NNNC; LCSC C15849
C304, C309: 10uF 25V; C_0805_2012Metric; MPN CL21A106KAYNNNE; LCSC C15850
C305: 47nF 16V; C_0402_1005Metric; MPN CL05B473KO5NNNC; LCSC C307434
C306: 4.7uF 16V; C_0603_1608Metric; MPN CL10A475KO8NNNC; LCSC C19666
C307, C308: 22uF 25V; C_0805_2012Metric; MPN CL21A226MAQNNNE; LCSC C45783
J301: TYPE-C-31-M-12; USB_C_Receptacle_HRO_TYPE-C-31-M-12; MPN TYPE-C-31-M-12; LCSC C165948
J302: Battery JST-PH 2P; JST_PH_S2B-PH-K_1x02_P2.00mm_Horizontal; MPN S2B-PH-K-S(LF)(SN); LCSC C173752
L301: 1uH; L_Coilcraft_XGL4020; MPN XGL4020-102MEC; LCSC C5357696
Q301, Q302, Q303: AO3400A; SOT-23; MPN AO3400A; LCSC C20917
R301, R302: 5.1k; R_0402_1005Metric; MPN 0402WGF5101TCE; LCSC C25905
R303, R306, R313, R316: 100k; R_0402_1005Metric; MPN 0402WGF1003TCE; LCSC C25741
R304, R307: 12k; R_0402_1005Metric; MPN 0402WGF1202TCE; LCSC C25752
R309, R311, R312: 10k; R_0402_1005Metric; MPN 0402WGF1002TCE; LCSC C25744
R314, R315: 4.7k; R_0402_1005Metric; MPN 0402WGF4701TCE; LCSC C25900
TH301: 10k B3380/3434; R_0402_1005Metric; MPN NCP15XH103F03RC; LCSC C77131
TP301: VBUS; TestPoint_Pad_D0.8mm
TP305: TS; TestPoint_Pad_D1.0mm
TP307: QON; TestPoint_Pad_D1.0mm
TP308: CHG_STAT; TestPoint_Pad_D1.0mm
TP309: CC1; TestPoint_Pad_D1.0mm
TP310: CC2; TestPoint_Pad_D1.0mm
TP311: GND; TestPoint_Pad_D0.8mm
U301: TPD4E05U06; TI_DQA0010A_USON-10_2.5x1.0mm_P0.5mm; MPN TPD4E05U06DQAR; LCSC C138714
U302: BQ25620; Texas_RYK0018A; MPN BQ25620RYKR; LCSC C6164243

Connections:
+3V3: Q301.1 (G), Q302.1 (G), R311.2, R312.2, R314.2, R315.2; also elsewhere on the board
/USB Charger Battery/BTST: C305.1, U302.1 (BTST)
/USB Charger Battery/CC1: J301.A5 (CC1), R301.1, R303.1, TP309.1, U301.4 (D2+)
/USB Charger Battery/CC1_HV: Q301.3 (D), R303.2
/USB Charger Battery/CC2: J301.B5 (CC2), R302.1, R306.1, TP310.1, U301.5 (D2-)
/USB Charger Battery/CC2_HV: Q302.3 (D), R306.2
/USB Charger Battery/PMID: C304.1, U302.17 (PMID)
/USB Charger Battery/QON: TP307.1, U302.7 (QON)
/USB Charger Battery/REGN: C306.1, R309.1, U302.2 (REGN)
/USB Charger Battery/SW_CHG: C305.2, L301.1, U302.16 (SW)
/USB Charger Battery/TS: R309.2, TH301.1, TP305.1, U302.6 (TS)
CC1_SENSE: C301.1, Q301.2 (S), R304.1; also elsewhere on the board
CC2_SENSE: C302.1, Q302.2 (S), R307.1; also elsewhere on the board
CHG_CE: Q303.3 (D), R313.1, U302.14 (CE)
CHG_EN: Q303.1 (G), R316.1; also elsewhere on the board
CHG_INT: R312.1, U302.11 (INT); also elsewhere on the board
CHG_PG_N: U302.3 (PG); also elsewhere on the board
CHG_STAT: R311.1, TP308.1, U302.10 (STAT)
GND: C301.2, C302.2, C303.2, C304.2, C306.2, C307.2, C308.2, C309.2, J301.A1 (GND), J301.A12 (GND), J301.B1 (GND), J301.B12 (GND), J301.SH (SHIELD), J302.1, Q303.2 (S), R301.2, R302.2, R304.2, R307.2, R316.2, TH301.2, TP311.1, U301.3 (GND), U301.8 (GND), U302.15 (GND); also elsewhere on the board
I2C1_SCL: R315.1, U302.13 (SCL); also elsewhere on the board
I2C1_SDA: R314.1, U302.12 (SDA); also elsewhere on the board
SYS: C307.1, C308.1, L301.2, R313.2, U302.9 (SYS); also elsewhere on the board
USB_DN: J301.A7 (D-), J301.B7 (D-), U301.2 (D1-), U302.4 (D-); also elsewhere on the board
USB_DP: J301.A6 (D+), J301.B6 (D+), U301.1 (D1+), U302.5 (D+); also elsewhere on the board
VBAT: C309.1, J302.2, U302.8 (BAT); also elsewhere on the board
VBUS: C303.1, J301.A4 (VBUS), J301.A9 (VBUS), J301.B4 (VBUS), J301.B9 (VBUS), TP301.1, U302.18 (VBUS); also elsewhere on the board

Notes on the sheet:
USB-C, charger and battery (Rev A) - design notes USB-C sink, USB 2.0, no PD: independent 5.1k Rd on CC1/CC2; TPD4E05U06 on D+, D-, CC1, CC2. CC sense: firmware reads CC1/CC2 via SAADC (ratio 0.107) and raises the BQ25620 input limit only on a valid >= 1.5 A advertisement; SDP/unknown sources stay 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

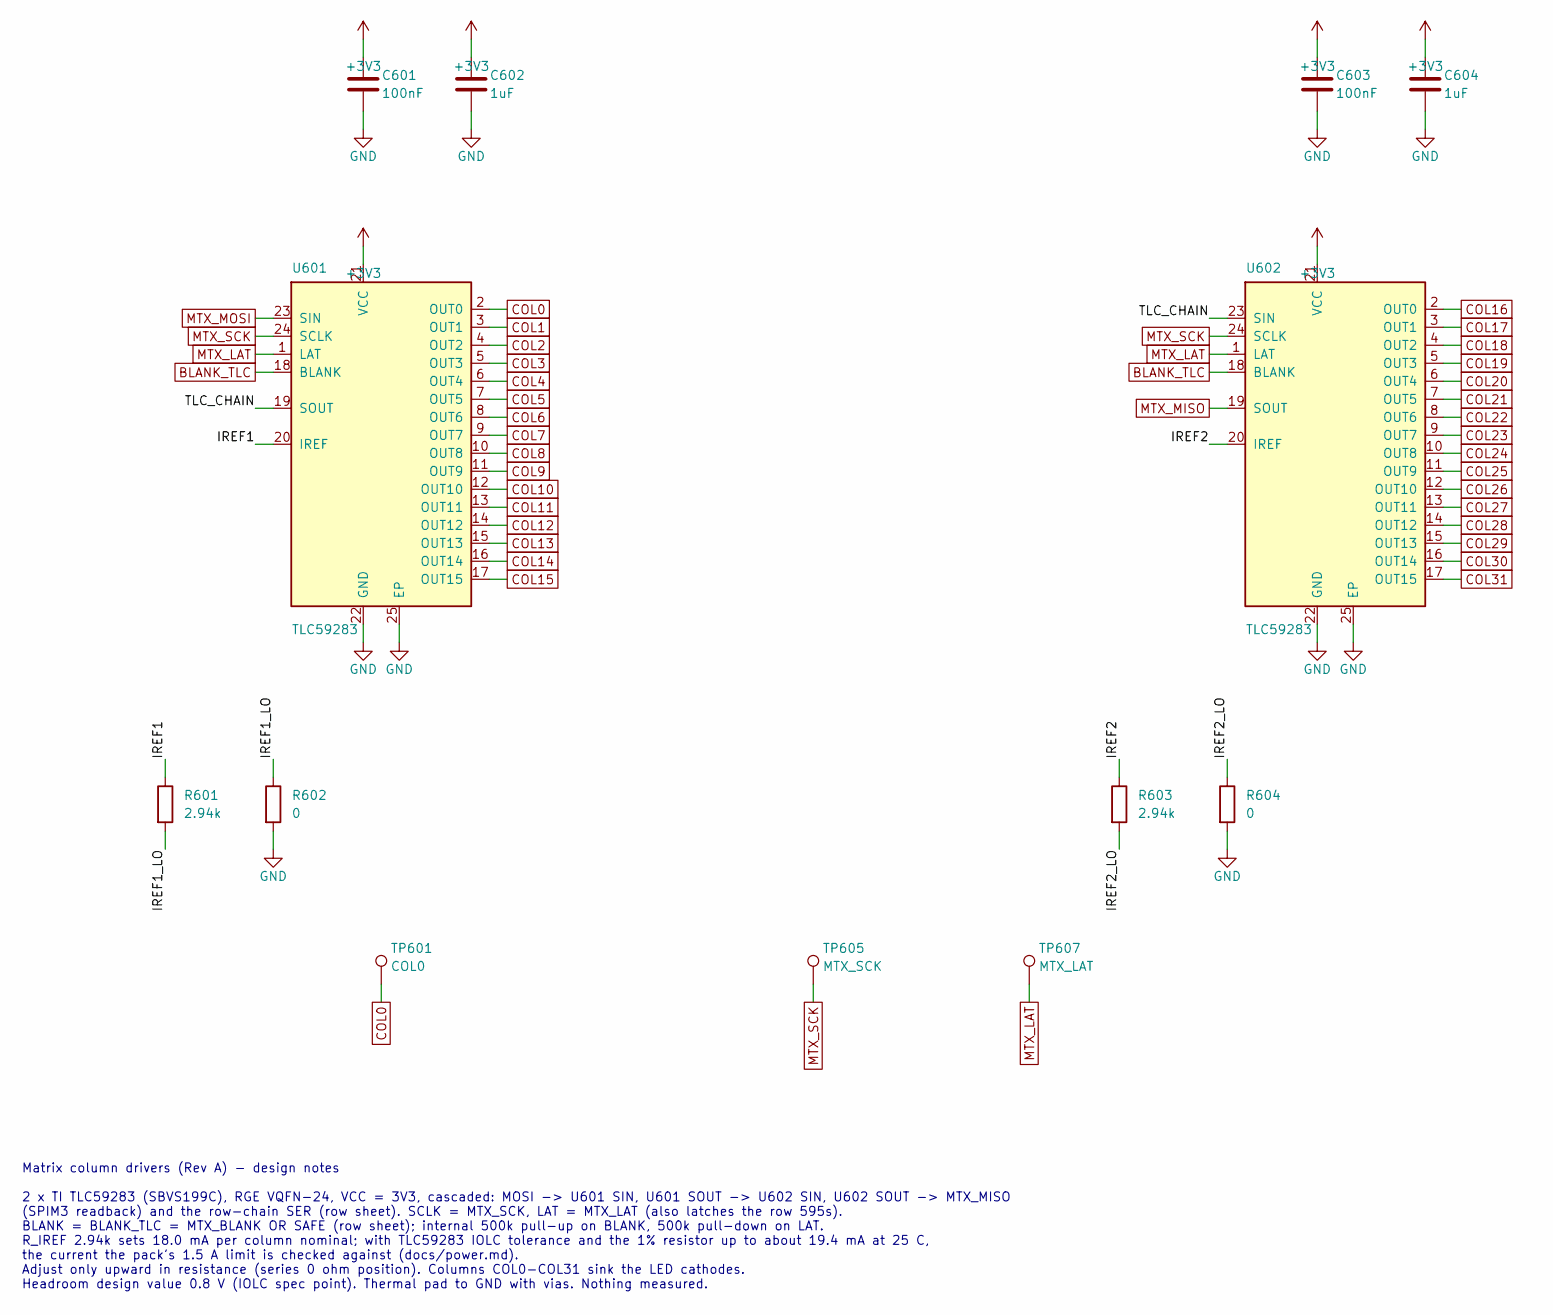
[picture p56: schematic matrix_columns.kicad_sch, Matrix Column Drivers]

Parts:
C601, C603: 100nF; C_0402_1005Metric; MPN CL05B104KO5NNNC; LCSC C1525
C602, C604: 1uF; C_0402_1005Metric; MPN CL05A105KA5NQNC; LCSC C52923
R601, R603: 2.94k; R_0402_1005Metric; MPN 0402WGF2941TCE; LCSC C25886
R602, R604: 0; R_0402_1005Metric; MPN 0402WGF0000TCE; LCSC C17168
TP601: COL0; TestPoint_Pad_D1.0mm
TP605: MTX_SCK; TestPoint_Pad_D1.0mm
TP607: MTX_LAT; TestPoint_Pad_D1.0mm
U601, U602: TLC59283; Texas_RGE0024C_VQFN-24-1EP_4x4mm_P0.5mm_EP2.1x2.1mm_Thermal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; MPN TLC59283RGER; LCSC C485815

Connections:
+3V3: C601.1, C602.1, C603.1, C604.1, U601.21 (VCC), U602.21 (VCC); also elsewhere on the board
/Matrix Column Drivers/IREF1: R601.1, U601.20 (IREF)
/Matrix Column Drivers/IREF1_LO: R601.2, R602.1
/Matrix Column Drivers/IREF2: R603.1, U602.20 (IREF)
/Matrix Column Drivers/IREF2_LO: R603.2, R604.1
/Matrix Column Drivers/TLC_CHAIN: U601.19 (SOUT), U602.23 (SIN)
BLANK_TLC: U601.18 (BLANK), U602.18 (BLANK); also elsewhere on the board
COL0: TP601.1, U601.2 (OUT0); also elsewhere on the board
COL1: U601.3 (OUT1); also elsewhere on the board
COL2: U601.4 (OUT2); also elsewhere on the board
COL3: U601.5 (OUT3); also elsewhere on the board
COL4: U601.6 (OUT4); also elsewhere on the board
COL5: U601.7 (OUT5); also elsewhere on the board
COL6: U601.8 (OUT6); also elsewhere on the board
COL7: U601.9 (OUT7); also elsewhere on the board
COL8: U601.10 (OUT8); also elsewhere on the board
COL9: U601.11 (OUT9); also elsewhere on the board
COL10: U601.12 (OUT10); also elsewhere on the board
COL11: U601.13 (OUT11); also elsewhere on the board
COL12: U601.14 (OUT12); also elsewhere on the board
COL13: U601.15 (OUT13); also elsewhere on the board
COL14: U601.16 (OUT14); also elsewhere on the board
COL15: U601.17 (OUT15); also elsewhere on the board
COL16: U602.2 (OUT0); also elsewhere on the board
COL17: U602.3 (OUT1); also elsewhere on the board
COL18: U602.4 (OUT2); also elsewhere on the board
COL19: U602.5 (OUT3); also elsewhere on the board
COL20: U602.6 (OUT4); also elsewhere on the board
COL21: U602.7 (OUT5); also elsewhere on the board
COL22: U602.8 (OUT6); also elsewhere on the board
COL23: U602.9 (OUT7); also elsewhere on the board
COL24: U602.10 (OUT8); also elsewhere on the board
COL25: U602.11 (OUT9); also elsewhere on the board
COL26: U602.12 (OUT10); also elsewhere on the board
COL27: U602.13 (OUT11); also elsewhere on the board
COL28: U602.14 (OUT12); also elsewhere on the board
COL29: U602.15 (OUT13); also elsewhere on the board
COL30: U602.16 (OUT14); also elsewhere on the board
COL31: U602.17 (OUT15); also elsewhere on the board
GND: C601.2, C602.2, C603.2, C604.2, R602.2, R604.2, U601.22 (GND), U601.25 (EP), U602.22 (GND), U602.25 (EP); also elsewhere on the board
MTX_LAT: TP607.1, U601.1 (LAT), U602.1 (LAT); also elsewhere on the board
MTX_MISO: U602.19 (SOUT); also elsewhere on the board
MTX_MOSI: U601.23 (SIN); also elsewhere on the board
MTX_SCK: TP605.1, U601.24 (SCLK), U602.24 (SCLK); also elsewhere on the board

Notes on the sheet:
Matrix column drivers (Rev A) - design notes 2 x TI TLC59283 (SBVS199C), RGE VQFN-24, VCC = 3V3, cascaded: MOSI -> U601 SIN, U601 SOUT -> U602 SIN, U602 SOUT -> MTX_MISO (SPIM3 readback) and the row-chain SER (row sheet). SCLK = MTX_SCK, LAT = MTX_LAT (also latches the row 595s). BLANK = BLANK_TLC 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

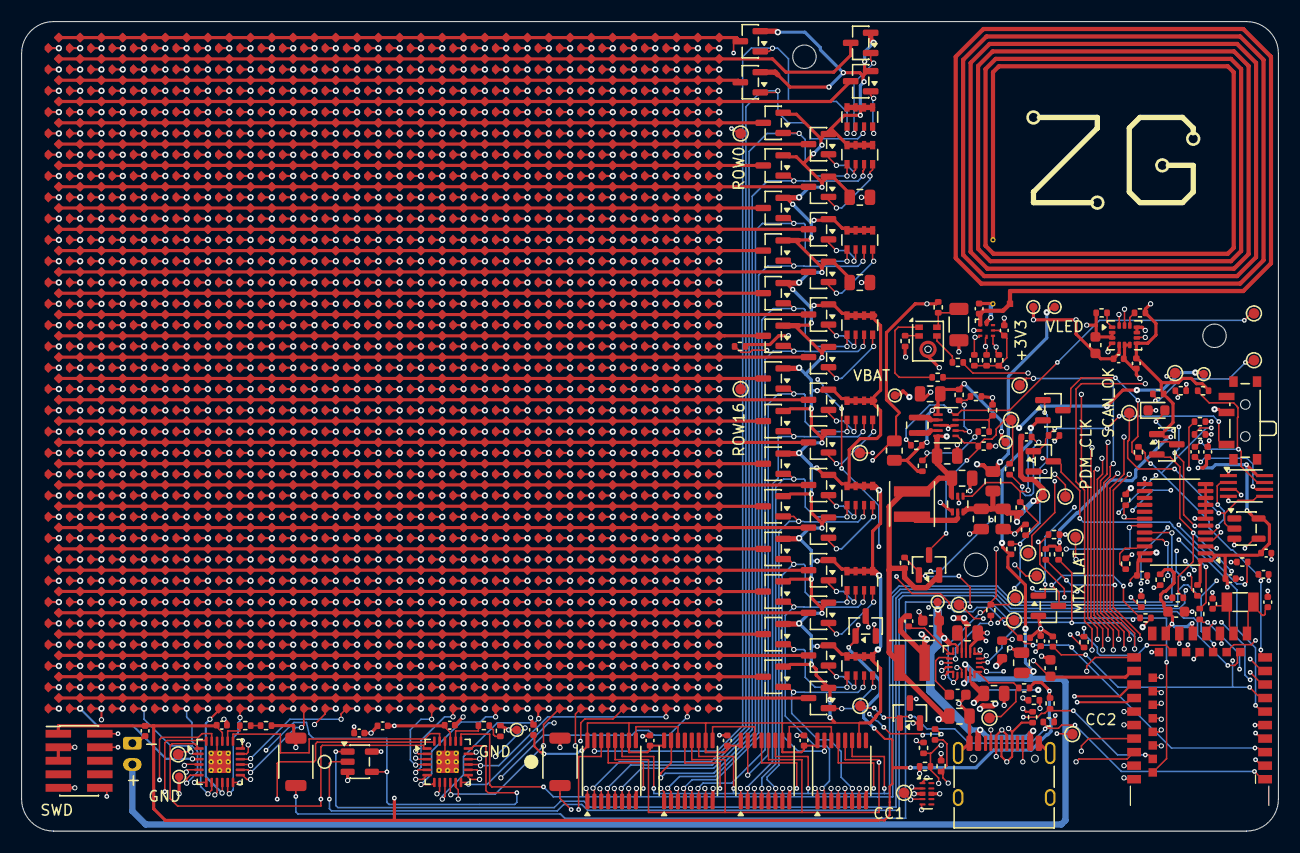
[picture p57: board smart-led-badge.kicad_pcb from above]

Board: 4 copper layers, 118.0 x 76.0 mm, 1236 parts (1 on the bottom side), 194 nets.
