zgeez/Pixel-Badge/firmware/common/src/app/ble.cpp

/* SPDX-License-Identifier: MIT */
#include "badge/ble.hpp"
#include "badge/settings_store.hpp"
#include <zephyr/sys/byteorder.h>
#include <zephyr/sys/atomic.h>
#include "badge/nfc.hpp"
#include "badge/text.hpp"
#include "badge/modes.hpp"
#if defined(CONFIG_APP_MOTION)
#include "badge/motion_runtime.hpp"
#endif
#if defined(CONFIG_APP_AUDIO)
#include "badge/audio_runtime.hpp"
#endif
#if defined(CONFIG_APP_POWER_MANAGER)
#include "badge/power_manager.hpp"
#endif
#include <zephyr/bluetooth/bluetooth.h>
#include <zephyr/bluetooth/conn.h>
#include <zephyr/bluetooth/gatt.h>
#include <zephyr/bluetooth/hci.h>
#include <zephyr/kernel.h>
#include <zephyr/logging/log.h>
#include <zephyr/settings/settings.h>
#include <errno.h>
#include <string.h>

LOG_MODULE_REGISTER(badge_ble, CONFIG_APP_LOG_LEVEL);
namespace badge
{
namespace
{
#define BADGE_UUID(n) BT_UUID_128_ENCODE(0xf3b00000 + (n), 0x6e9b, 0x4f4c, 0xa8f8, 0x731a9d46e1c0)
bt_uuid_128 service_uuid = BT_UUID_INIT_128(BADGE_UUID(1));
bt_uuid_128 info_uuid = BT_UUID_INIT_128(BADGE_UUID(2));
bt_uuid_128 name_uuid = BT_UUID_INIT_128(BADGE_UUID(3));
bt_uuid_128 url_uuid = BT_UUID_INIT_128(BADGE_UUID(4));
bt_uuid_128 brightness_uuid = BT_UUID_INIT_128(BADGE_UUID(5));
bt_uuid_128 mode_uuid = BT_UUID_INIT_128(BADGE_UUID(6));
bt_uuid_128 apply_uuid = BT_UUID_INIT_128(BADGE_UUID(7));
bt_uuid_128 status_uuid = BT_UUID_INIT_128(BADGE_UUID(8));
bt_uuid_128 text_uuid = BT_UUID_INIT_128(BADGE_UUID(9));
bt_uuid_128 artwork_uuid = BT_UUID_INIT_128(BADGE_UUID(10));
bt_uuid_128 nfc_uuid = BT_UUID_INIT_128(BADGE_UUID(11));
bt_uuid_128 motion_uuid = BT_UUID_INIT_128(BADGE_UUID(12));
bt_uuid_128 motion_status_uuid = BT_UUID_INIT_128(BADGE_UUID(13));
bt_uuid_128 battery_uuid = BT_UUID_INIT_128(BADGE_UUID(14));
K_MUTEX_DEFINE(ble_mutex);
K_SEM_DEFINE(ble_started, 0, 1);
K_SEM_DEFINE(main_requested, 0, 1);
K_SEM_DEFINE(main_completed, 0, 1);
K_MSGQ_DEFINE(config_requests, sizeof(uint8_t), 1, 1);
BleProtocol protocol;
Settings snapshot = kDefaultSettings;
uint32_t snapshot_art_crc;
Mode active_mode = Mode::kQr;
bt_conn *connection;
bool writable, stageable, enabled, job_active;
uint64_t pairing_deadline;
bool passkey_visible;
uint32_t displayed_passkey;
ConfigCommand main_command;
int main_result;
ArtworkReadCursor artwork_read;
atomic_t artwork_uploading, artwork_applying;
int64_t artwork_upload_deadline;
K_SEM_DEFINE(artwork_requested, 0, 1);
K_SEM_DEFINE(artwork_completed, 0, 1);
struct ArtFragment {
	uint32_t offset, total;
	size_t length;
	uint8_t bytes[235];
	int result;
	const uint8_t *view;
} art_fragment;
void artwork_worker(void *, void *, void *)
{
	while (true) {
		k_sem_take(&artwork_requested, K_FOREVER);
		art_fragment.view = nullptr;
		art_fragment.result = stage_artwork_flash(art_fragment.offset, art_fragment.total,
							  art_fragment.bytes, art_fragment.length,
							  &art_fragment.view);
		k_sem_give(&artwork_completed);
	}
}
K_THREAD_DEFINE(artwork_tid, 4096, artwork_worker, nullptr, nullptr, nullptr, 9, 0, 0);
int stage_art(void *, uint32_t offset, uint32_t total, const uint8_t *bytes, size_t length,
	      const uint8_t **view)
{
	if (length > sizeof(art_fragment.bytes)) {
		return -EINVAL;
	}
	art_fragment.offset = offset;
	art_fragment.total = total;
	art_fragment.length = length;
	memcpy(art_fragment.bytes, bytes, length);
	k_sem_give(&artwork_requested);
	k_sem_take(&artwork_completed, K_FOREVER);
	*view = art_fragment.view;
	if (art_fragment.result != 0) {
		LOG_WRN("BLE artwork fragment at %u of %u rejected (%d)", offset, total,
			art_fragment.result);
	}
	return art_fragment.result;
}

uint8_t flags()
{
	return (writable && enabled ? 1 : 0) | (nfc_ready() ? 2 : 0) |
	       (pairing_deadline > static_cast<uint64_t>(k_uptime_get()) ? 4 : 0);
}
bool secure(bt_conn *conn)
{
	return bt_conn_get_security(conn) == BT_SECURITY_L4;
}
ssize_t att_error(int rc)
{
	return BT_GATT_ERR(rc == -EACCES  ? BT_ATT_ERR_AUTHENTICATION
			   : rc == -EBUSY ? BT_ATT_ERR_UNLIKELY
					  : BT_ATT_ERR_VALUE_NOT_ALLOWED);
}
ssize_t read_info(bt_conn *conn, const bt_gatt_attr *attr, void *buf, uint16_t len, uint16_t offset)
{
	k_mutex_lock(&ble_mutex, K_FOREVER);
	const uint8_t info[] = {kBleVersion,
				kPayloadMax,
				kNameMax,
				4,
				IS_ENABLED(CONFIG_APP_MOTION)  ? 7
				: IS_ENABLED(CONFIG_APP_AUDIO) ? 6
							       : 4,
				flags(),
				kArtworkFrames,
				IS_ENABLED(CONFIG_APP_MOTION)  ? 255
				: IS_ENABLED(CONFIG_APP_AUDIO) ? 239
							       : 231};
	k_mutex_unlock(&ble_mutex);
	return bt_gatt_attr_read(conn, attr, buf, len, offset, info, sizeof(info));
}
ssize_t read_setting(bt_conn *conn, const bt_gatt_attr *attr, void *buf, uint16_t len,
		     uint16_t offset)
{
	if (!secure(conn)) {
		return att_error(-EACCES);
	}
	uint8_t data[244];
	size_t length = 1, artwork_payload = 0;
	const Field field = static_cast<Field>(reinterpret_cast<uintptr_t>(attr->user_data));
	k_mutex_lock(&ble_mutex, K_FOREVER);
	if (field == Field::kUrl) {
		length = strlen(snapshot.url);
		memcpy(data, snapshot.url, length);
	} else if (field == Field::kName) {
		length = strlen(snapshot.name);
		memcpy(data, snapshot.name, length);
	} else if (field == Field::kText) {
		length = snapshot.text.length;
		memcpy(data, snapshot.text.bytes, length);
	} else if (field == Field::kArtwork) {
		if (artwork_read.sequential && offset != 0) {
			k_mutex_unlock(&ble_mutex);
			return BT_GATT_ERR(BT_ATT_ERR_INVALID_OFFSET);
		}
		if (artwork_read.metadata) {
			sys_put_le32(snapshot.artwork.length, data);
			sys_put_le32(snapshot_art_crc, data + 4);
			length = 8;
		} else {
			const uint32_t total = snapshot.artwork.length;
			const uint32_t cursor =
				artwork_read.offset <= total ? artwork_read.offset : total;
			const size_t header = artwork_read.wide ? 8 : 4;
			const size_t available = artwork_read.capacity(len);
			length = MIN(total - cursor, available);
			artwork_payload = length;
			for (unsigned i = 0; i < (artwork_read.wide ? 4U : 2U); i++) {
				data[i] = cursor >> (8 * i);
				data[(artwork_read.wide ? 4 : 2) + i] = total >> (8 * i);
			}
			memcpy(data + header, snapshot.artwork.bytes + cursor, length);
			length += header;
		}
	} else if (field == Field::kMotion) {
		length = kMotionBytes;
		memcpy(data, snapshot.motion.bytes, length);
	} else if (field == kNfcSyncField) {
		const int result = nfc_last_result();
		data[0] = 1;
		data[1] = nfc_ready();
		data[2] = nfc_update_busy();
		for (unsigned i = 0; i < 4; ++i) {
			data[3 + i] = static_cast<uint32_t>(result) >> (i * 8);
		}
		length = 7;
	} else {
		data[0] = field == Field::kBrightness ? snapshot.brightness
						      : static_cast<uint8_t>(active_mode);
	}
	const ssize_t result = bt_gatt_attr_read(conn, attr, buf, len, offset, data, length);
	if (field == Field::kArtwork) {
		artwork_read.complete(offset, result, length, artwork_payload);
	}
	k_mutex_unlock(&ble_mutex);
	return result;
}
ssize_t stage_setting(bt_conn *conn, const bt_gatt_attr *attr, const void *buf, uint16_t len,
		      uint16_t offset, uint8_t write_flags)
{
	if (offset != 0 || write_flags != 0) {
		return BT_GATT_ERR(BT_ATT_ERR_INVALID_OFFSET);
	}
	const Field field = static_cast<Field>(reinterpret_cast<uintptr_t>(attr->user_data));
	k_mutex_lock(&ble_mutex, K_FOREVER);
	const auto *read_command = static_cast<const uint8_t *>(buf);
	if (field == Field::kArtwork &&
	    ((len == 1 && (read_command[0] == 3 || read_command[0] == 4)) ||
	     (len == 3 && read_command[0] == 0) || (len == 5 && read_command[0] == 2))) {
		const bool allowed = secure(conn) && connection == conn;
		const bool selected =
			allowed && artwork_read.select(read_command, len, snapshot.artwork.length);
		k_mutex_unlock(&ble_mutex);
		return !allowed ? att_error(-EACCES) : selected ? len : att_error(-EINVAL);
	}
	if (field == Field::kArtwork) {
		if (!secure(conn) || connection != conn || !stageable || passkey_visible ||
		    job_active) {
			k_mutex_unlock(&ble_mutex);
			return att_error(-EACCES);
		}
		atomic_set(&artwork_uploading, 1);
		artwork_upload_deadline = k_uptime_get() + 10000;
		k_mutex_unlock(&ble_mutex);
#if defined(CONFIG_APP_AUDIO)
		bool recording_busy = audio_ui_busy();
		const int64_t pause_deadline = k_uptime_get() + 500;
		while (!recording_busy && !audio_quiescent() && k_uptime_get() < pause_deadline) {
			k_msleep(1);
		}
		recording_busy = recording_busy || !audio_quiescent();
#else
		const bool recording_busy = false;
#endif
		k_mutex_lock(&ble_mutex, K_FOREVER);
		if (recording_busy || nfc_update_busy()) {
			atomic_clear(&artwork_uploading);
			k_mutex_unlock(&ble_mutex);
			return att_error(-EBUSY);
		}
	}
	const int rc = job_active ? -EBUSY
				  : protocol.stage(field, static_cast<const uint8_t *>(buf), len,
						   secure(conn) && connection == conn &&
							   stageable && !passkey_visible);
	if (field == Field::kArtwork && rc != 0) {
		atomic_clear(&artwork_uploading);
	}
	k_mutex_unlock(&ble_mutex);
	return rc == 0 ? len : att_error(rc);
}
ssize_t read_status(bt_conn *conn, const bt_gatt_attr *attr, void *buf, uint16_t len,
		    uint16_t offset)
{
	if (!secure(conn)) {
		return att_error(-EACCES);
	}
	uint8_t data[kBleStatusSize];
	k_mutex_lock(&ble_mutex, K_FOREVER);
	protocol.status(data, flags());
	k_mutex_unlock(&ble_mutex);
	return bt_gatt_attr_read(conn, attr, buf, len, offset, data, sizeof(data));
}
void notify_status(k_work *);
k_work status_work{};
ssize_t apply_setting(bt_conn *conn, const bt_gatt_attr *, const void *buf, uint16_t len,
		      uint16_t offset, uint8_t write_flags)
{
	if (offset != 0 || write_flags != 0) {
		return BT_GATT_ERR(BT_ATT_ERR_INVALID_OFFSET);
	}
	/* The serialized job owns one mailbox through main completion.
	 * The queue carries only a wakeup, never additional artwork copies. */
	auto &command = main_command;
	k_mutex_lock(&ble_mutex, K_FOREVER);
	int rc = job_active ? -EBUSY
			    : protocol.accept(static_cast<const uint8_t *>(buf), len,
					      secure(conn) && connection == conn && writable &&
						      !passkey_visible,
					      command);
	if (rc == 0) {
		const uint8_t token = 1;
		rc = k_msgq_put(&config_requests, &token, K_NO_WAIT);
		if (rc == 0) {
			job_active = true;
			if (command.field == Field::kArtwork) {
				atomic_set(&artwork_applying, 1);
			}
		} else {
			protocol.complete(command, rc);
		}
	}
	k_mutex_unlock(&ble_mutex);
	if (rc == 0) {
		k_work_submit(&status_work);
	}
	return rc == 0 ? len : att_error(rc);
}
void ccc_changed(const bt_gatt_attr *, uint16_t)
{
}
ssize_t read_motion_status(bt_conn *conn, const bt_gatt_attr *attr, void *buf, uint16_t len,
			   uint16_t offset)
{
	if (!secure(conn)) {
		return att_error(-EACCES);
	}
	uint8_t data[16] = {1};
#if defined(CONFIG_APP_MOTION)
	motion_status(data);
#endif
	return bt_gatt_attr_read(conn, attr, buf, len, offset, data, sizeof(data));
}
/* [version 1, level, flags, 0, mv:u16le]; level 0 (unknown) without a
 * power manager, as on the DK. */
ssize_t read_battery(bt_conn *conn, const bt_gatt_attr *attr, void *buf, uint16_t len,
		     uint16_t offset)
{
	if (!secure(conn)) {
		return att_error(-EACCES);
	}
	uint8_t data[6] = {1};
#if defined(CONFIG_APP_POWER_MANAGER)
	const BatteryReport report = power_battery_report();

	data[1] = report.level;
	data[2] = report.flags;
	sys_put_le16(report.mv, &data[4]);
#endif
	return bt_gatt_attr_read(conn, attr, buf, len, offset, data, sizeof(data));
}
bt_gatt_ccc_managed_user_data status_ccc{};
constexpr uint16_t read_permission = BT_GATT_PERM_READ_AUTHEN | BT_GATT_PERM_READ_LESC;
constexpr uint16_t write_permission = BT_GATT_PERM_WRITE_AUTHEN | BT_GATT_PERM_WRITE_LESC;
#define SETTING_CHARACTERISTIC(uuid_value, field)                                                  \
	BT_GATT_CHARACTERISTIC(&(uuid_value).uuid, BT_GATT_CHRC_READ | BT_GATT_CHRC_WRITE,         \
			       read_permission | write_permission, read_setting, stage_setting,    \
			       reinterpret_cast<void *>(static_cast<uintptr_t>(field)))
/* Zephyr's C attribute macros omit internal zero-initialized handle fields.
 * Keep the exception local to their declaration; application code stays strict. */
#pragma GCC diagnostic push
#pragma GCC diagnostic ignored "-Wmissing-field-initializers"
BT_GATT_SERVICE_DEFINE(badge_service, BT_GATT_PRIMARY_SERVICE(&service_uuid),
		       BT_GATT_CHARACTERISTIC(&info_uuid.uuid, BT_GATT_CHRC_READ, BT_GATT_PERM_READ,
					      read_info, nullptr, nullptr),
		       SETTING_CHARACTERISTIC(name_uuid, Field::kName),
		       SETTING_CHARACTERISTIC(url_uuid, Field::kUrl),
		       SETTING_CHARACTERISTIC(brightness_uuid, Field::kBrightness),
		       SETTING_CHARACTERISTIC(mode_uuid, Field::kDefaultMode),
		       BT_GATT_CHARACTERISTIC(&apply_uuid.uuid, BT_GATT_CHRC_WRITE,
					      write_permission, nullptr, apply_setting, nullptr),
		       BT_GATT_CHARACTERISTIC(&status_uuid.uuid,
					      BT_GATT_CHRC_READ | BT_GATT_CHRC_NOTIFY,
					      read_permission, read_status, nullptr, nullptr),
		       BT_GATT_CCC_MANAGED(&status_ccc, read_permission | write_permission),
		       /* Append extensions to preserve the original v1 attribute order. */
		       SETTING_CHARACTERISTIC(text_uuid, Field::kText),
		       SETTING_CHARACTERISTIC(artwork_uuid, Field::kArtwork),
		       SETTING_CHARACTERISTIC(nfc_uuid, kNfcSyncField),
		       SETTING_CHARACTERISTIC(motion_uuid, Field::kMotion),
		       BT_GATT_CHARACTERISTIC(&motion_status_uuid.uuid, BT_GATT_CHRC_READ,
					      read_permission, read_motion_status, nullptr,
					      nullptr),
		       BT_GATT_CHARACTERISTIC(&battery_uuid.uuid, BT_GATT_CHRC_READ,
					      read_permission, read_battery, nullptr, nullptr));
#pragma GCC diagnostic pop

void notify_status(k_work *)
{
	uint8_t data[kBleStatusSize];
	k_mutex_lock(&ble_mutex, K_FOREVER);
	bt_conn *conn = connection != nullptr ? bt_conn_ref(connection) : nullptr;
	protocol.status(data, flags());
	k_mutex_unlock(&ble_mutex);
	if (conn != nullptr) {
		if (secure(conn)) {
			(void)bt_gatt_notify_uuid(conn, &status_uuid.uuid, badge_service.attrs,
						  data, sizeof(data));
		}
		bt_conn_unref(conn);
	}
}
void advertise(k_work *)
{
	/* BT_DATA_BYTES creates C compound literals. In C++ their temporary
	 * buffers expire at the declaration's semicolon. Keep every payload
	 * alive through bt_le_adv_start(), using the service's static UUID. */
	static const uint8_t advertising_flags[] = {BT_LE_AD_GENERAL | BT_LE_AD_NO_BREDR};
	const bt_data ad[] = {
		BT_DATA(BT_DATA_FLAGS, advertising_flags, sizeof(advertising_flags)),
		BT_DATA(BT_DATA_UUID128_ALL, service_uuid.val, sizeof(service_uuid.val))};
	const bt_data sd[] = {BT_DATA(BT_DATA_NAME_COMPLETE, CONFIG_BT_DEVICE_NAME,
				      sizeof(CONFIG_BT_DEVICE_NAME) - 1)};
	int rc = bt_le_adv_start(BT_LE_ADV_CONN_FAST_1, ad, ARRAY_SIZE(ad), sd, ARRAY_SIZE(sd));
	if (rc != 0 && rc != -EALREADY) {
		LOG_WRN("BLE advertising failed (%d)", rc);
	} else {
		LOG_INF("BLE advertising started");
	}
}
k_work advertise_work{};
void connected(bt_conn *conn, uint8_t error)
{
	if (error != 0) {
		return;
	}
#if defined(CONFIG_APP_AUDIO)
	audio_connected(conn);
#endif
	k_mutex_lock(&ble_mutex, K_FOREVER);
	connection = bt_conn_ref(conn);
	protocol.reset();
	atomic_clear(&artwork_uploading);
	artwork_read = {};
	k_mutex_unlock(&ble_mutex);
	/* Bonded reconnection does not require the physical pairing window. The
	 * pairing_accept callback blocks all new pairing outside that window. */
	const int rc = bt_conn_set_security(conn, BT_SECURITY_L4);
	if (rc != 0) {
		LOG_WRN("BLE security request failed (%d)", rc);
		bt_conn_disconnect(conn, BT_HCI_ERR_AUTH_FAIL);
	}
}
void disconnected(bt_conn *conn, uint8_t)
{
#if defined(CONFIG_APP_AUDIO)
	audio_disconnected();
#endif
	k_mutex_lock(&ble_mutex, K_FOREVER);
	if (connection == conn) {
		bt_conn_unref(connection);
		connection = nullptr;
	}
	protocol.reset();
	atomic_clear(&artwork_uploading);
	passkey_visible = false;
	k_mutex_unlock(&ble_mutex);
	/* Recycling has not finished here. Advertising starts in recycled(). */
}
void recycled()
{
	k_work_submit(&advertise_work);
}
void security_changed(bt_conn *conn, bt_security_t level, bt_security_err error)
{
	LOG_INF("BLE security outcome: level %u error %u", static_cast<unsigned>(level),
		static_cast<unsigned>(error));
	if (error != BT_SECURITY_ERR_SUCCESS || level != BT_SECURITY_L4) {
		bt_conn_disconnect(conn, BT_HCI_ERR_AUTH_FAIL);
	}
}
bt_conn_cb connection_callbacks{};
bt_security_err pairing_accept(bt_conn *, const bt_conn_pairing_feat *const feat)
{
	if (IS_ENABLED(CONFIG_APP_BLE_PAIRING_BENCH)) {
		LOG_WRN("BLE bench pairing request: io %u oob %u auth 0x%02x key %u",
			feat->io_capability, feat->oob_data_flag, feat->auth_req,
			feat->max_enc_key_size);
	}
	k_mutex_lock(&ble_mutex, K_FOREVER);
	bool allowed =
		writable && !job_active && pairing_deadline > static_cast<uint64_t>(k_uptime_get());
	k_mutex_unlock(&ble_mutex);
	LOG_INF("BLE new pairing policy: %s", allowed ? "allowed" : "rejected");
#if defined(CONFIG_APP_AUDIO)
	if (allowed) {
		allowed = audio_new_pairing();
	}
#endif
	return allowed ? BT_SECURITY_ERR_SUCCESS : BT_SECURITY_ERR_PAIR_NOT_ALLOWED;
}
void passkey_display(bt_conn *conn, unsigned key)
{
	k_mutex_lock(&ble_mutex, K_FOREVER);
	const bool allowed = writable && pairing_deadline > static_cast<uint64_t>(k_uptime_get());
	displayed_passkey = key;
	passkey_visible = allowed;
	k_mutex_unlock(&ble_mutex);
	if (IS_ENABLED(CONFIG_APP_BLE_PAIRING_BENCH) && allowed) {
		LOG_WRN("BLE bench passkey: %06u", key);
	}
	if (!allowed) {
		bt_conn_auth_cancel(conn);
		bt_conn_disconnect(conn, BT_HCI_ERR_AUTH_FAIL);
	}
}
void pairing_cancel(bt_conn *)
{
	k_mutex_lock(&ble_mutex, K_FOREVER);
	passkey_visible = false;
	pairing_deadline = 0;
	k_mutex_unlock(&ble_mutex);
}
bt_conn_auth_cb authentication{};
void paired(bt_conn *conn, bool bonded)
{
	LOG_INF("BLE pairing completed: bonded %u", static_cast<unsigned>(bonded));
	pairing_cancel(conn);
}
void pairing_failed(bt_conn *conn, bt_security_err error)
{
	LOG_INF("BLE pairing failed (%u)", static_cast<unsigned>(error));
	pairing_cancel(conn);
}
bt_conn_auth_info_cb authentication_info{};

void worker(void *, void *, void *)
{
	k_sem_take(&ble_started, K_FOREVER);
	protocol.artwork_staging(stage_art, nullptr);
	LOG_INF("BLE startup: registering callbacks");
	k_work_init(&status_work, notify_status);
	k_work_init(&advertise_work, advertise);
	status_ccc.cfg_changed = ccc_changed;
	connection_callbacks.connected = connected;
	connection_callbacks.disconnected = disconnected;
	connection_callbacks.recycled = recycled;
	connection_callbacks.security_changed = security_changed;
	bt_conn_cb_register(&connection_callbacks);
	authentication.pairing_accept = pairing_accept;
	authentication.passkey_display = passkey_display;
	authentication.cancel = pairing_cancel;
	authentication_info.pairing_complete = paired;
	authentication_info.pairing_failed = pairing_failed;
	int rc = bt_conn_auth_cb_register(&authentication);
	if (rc == 0) {
		rc = bt_conn_auth_info_cb_register(&authentication_info);
	}
	if (rc == 0) {
		LOG_INF("BLE startup: enabling host and IPC radio");
		rc = bt_enable(nullptr);
	}
	if (rc == 0) {
		LOG_INF("BLE startup: loading bonds");
		rc = settings_load_subtree("bt");
	}
	if (rc != 0) {
		LOG_ERR("BLE startup failed (%d)", rc);
		return;
	}
	k_mutex_lock(&ble_mutex, K_FOREVER);
	enabled = true;
	k_mutex_unlock(&ble_mutex);
#if defined(CONFIG_APP_AUDIO)
	start_audio_service();
#endif
	LOG_INF("BLE ready: configuration service available");
	k_work_submit(&advertise_work);
	while (true) {
		/* job_active keeps the shared mailbox immutable until main completion. */
		uint8_t token;
		k_msgq_get(&config_requests, &token, K_FOREVER);
		const auto &command = main_command;
		k_mutex_lock(&ble_mutex, K_FOREVER);
		const bool current = protocol.current(command) && writable;
		k_mutex_unlock(&ble_mutex);
		int result = current ? 0 : -ECANCELED;
		if (result == 0 && command.field == Field::kUrl) {
			result = change_nfc_url(reinterpret_cast<const char *>(command.data),
						command.length);
		}
		if (result == 0 && command.field == kNfcSyncField) {
			result = resync_nfc();
		}
		/* Main owns all settings/mode/display state and publishes readback
		 * before status completion. No Bluetooth callback touches flash/I2C. */
		main_result = result;
		k_sem_give(&main_requested);
		k_sem_take(&main_completed, K_FOREVER);
	}
}
K_THREAD_DEFINE(ble_tid, 4096, worker, nullptr, nullptr, nullptr, 9, 0, 0);
} // namespace

void start_ble()
{
	k_sem_give(&ble_started);
}
void open_ble_pairing()
{
	k_mutex_lock(&ble_mutex, K_FOREVER);
	if (writable && enabled && !job_active) {
#if defined(CONFIG_APP_AUDIO)
		if (audio_pairing_window())
#endif
			pairing_deadline = k_uptime_get() + 60000;
	}
	k_mutex_unlock(&ble_mutex);
}
#if defined(CONFIG_BADGE_USB_BENCH)
bool ble_bench_passkey(uint32_t &passkey)
{
	k_mutex_lock(&ble_mutex, K_FOREVER);
	const bool visible = writable && enabled && passkey_visible &&
			     pairing_deadline > static_cast<uint64_t>(k_uptime_get());
	if (visible) {
		passkey = displayed_passkey;
	}
	k_mutex_unlock(&ble_mutex);
	return visible;
}
#endif
bool ble_config_busy()
{
	k_mutex_lock(&ble_mutex, K_FOREVER);
	const bool busy = job_active || passkey_visible;
	k_mutex_unlock(&ble_mutex);
	return busy;
}
bool ble_pairing_frame(Frame &frame)
{
	k_mutex_lock(&ble_mutex, K_FOREVER);
	const bool visible = passkey_visible;
	const uint32_t key = displayed_passkey;
	k_mutex_unlock(&ble_mutex);
	if (visible) {
		draw_passkey(frame, key);
	}
	return visible;
}
bool ble_artwork_busy()
{
	return atomic_get(&artwork_uploading) != 0 || atomic_get(&artwork_applying) != 0;
}

void poll_ble(const Settings &settings, Modes &modes, bool allow_writes, bool allow_staging,
	      ApplyConfig apply, void *context)
{
	const bool requested = k_sem_take(&main_requested, K_NO_WAIT) == 0;
	k_mutex_lock(&ble_mutex, K_FOREVER);
	writable = allow_writes;
	stageable = allow_writes || allow_staging;
	if (artwork_upload_deadline <= k_uptime_get()) {
		atomic_clear(&artwork_uploading);
	}
	bool expired = pairing_deadline != 0 &&
		       (!writable || pairing_deadline <= static_cast<uint64_t>(k_uptime_get()));
	bt_conn *cancel = expired && passkey_visible && connection != nullptr
				  ? bt_conn_ref(connection)
				  : nullptr;
	if (expired) {
		pairing_deadline = 0;
		passkey_visible = false;
	}
	const bool current = requested && protocol.current(main_command);
	k_mutex_unlock(&ble_mutex);
	if (expired) {
		LOG_INF("BLE pairing window expired");
	}
	if (cancel != nullptr) {
		bt_conn_auth_cancel(cancel);
		bt_conn_disconnect(cancel, BT_HCI_ERR_AUTH_FAIL);
		bt_conn_unref(cancel);
	}
	if (requested && main_result == 0 && main_command.field != Field::kUrl &&
	    main_command.field != kNfcSyncField) {
		main_result = current && allow_writes ? apply(context, main_command) : -ECANCELED;
	}
	if (requested && main_result != 0) {
		LOG_WRN("BLE change to field %u rejected (%d)",
			static_cast<unsigned>(main_command.field), main_result);
	}
	k_mutex_lock(&ble_mutex, K_FOREVER);
	/* settings references the live main-owned values, including apply() changes. */
	snapshot = settings;
	snapshot_art_crc = current_artwork_crc(snapshot.artwork);
	active_mode = modes.active();
	if (requested) {
		protocol.complete(main_command, main_result);
		if (main_command.field == Field::kArtwork) {
			atomic_clear(&artwork_uploading);
			atomic_clear(&artwork_applying);
		}
		job_active = false;
	}
	k_mutex_unlock(&ble_mutex);
	if (requested) {
		k_work_submit(&status_work);
		k_sem_give(&main_completed);
	}
}
} // namespace badge
