zgeez/Pixel-Badge/firmware/common/include/badge/ble.hpp

/* SPDX-License-Identifier: MIT */
#pragma once
#include "badge/ble_protocol.hpp"

namespace badge
{
class Modes;
using ApplyConfig = int (*)(void *, const ConfigCommand &);
void start_ble();
/* Called only by the main-loop settings/display owner. Never blocks on NFC.
 * `writable` gates Apply and pairing, which need a visible display;
 * `stageable` gates staging a value, which a brief display recovery must not
 * interrupt (a large artwork upload would fail part-way). */
void poll_ble(const Settings &settings, Modes &modes, bool writable, bool stageable,
	      ApplyConfig apply, void *context);
void open_ble_pairing();
#if defined(CONFIG_BADGE_USB_BENCH)
/* USB terminal is the bench display; never publish through logging/GATT. */
bool ble_bench_passkey(uint32_t &passkey);
#endif
bool ble_pairing_frame(Frame &frame);
bool ble_config_busy();
bool ble_artwork_busy();
} // namespace badge
