zgeez/Pixel-Badge/firmware/tests/ble_protocol/src/main.cpp

/* SPDX-License-Identifier: MIT */
#include "badge/ble_protocol.hpp"
#include <zephyr/ztest.h>
#include <errno.h>
#include <string.h>
using namespace badge;

namespace
{
uint8_t art_staging[kArtworkBytes];
int stage_art_test(void *, uint32_t offset, uint32_t total, const uint8_t *bytes, size_t count,
		   const uint8_t **view)
{
	memcpy(art_staging + offset, bytes, count);
	*view = offset + count == total ? art_staging : nullptr;
	return 0;
}
struct TestProtocol: BleProtocol {
	TestProtocol()
	{
		artwork_staging(stage_art_test, nullptr);
	}
};
} // namespace
static ConfigCommand accept(BleProtocol &protocol, uint8_t id, Field field)
{
	uint8_t packet[] = {kBleVersion, id, 0, 0, 0, static_cast<uint8_t>(field)};
	ConfigCommand command;
	zassert_ok(protocol.accept(packet, sizeof(packet), true, command));
	return command;
}
ZTEST(ble_protocol, test_reject_unauthenticated_and_unstaged_requests)
{
	TestProtocol protocol;
	const uint8_t brightness = 64;
	zassert_equal(protocol.stage(Field::kBrightness, &brightness, 1, false), -EACCES);
	const uint8_t request[] = {kBleVersion, 1, 0, 0, 0, 3};
	ConfigCommand untouched;
	untouched.id = 99;
	zassert_equal(protocol.accept(request, sizeof(request), false, untouched), -EACCES);
	zassert_equal(protocol.accept(request, sizeof(request), true, untouched), -EINVAL);
	zassert_equal(untouched.id, 99);
	zassert_false(protocol.busy());
}
ZTEST(ble_protocol, test_field_bounds_and_qr_fit)
{
	TestProtocol protocol;
	const char *valid = "HTTPS://A.B/X";
	zassert_ok(protocol.stage(Field::kUrl, reinterpret_cast<const uint8_t *>(valid),
				  strlen(valid), true));
	const char *invalid = "HTTPS://EXAMPLE.COM/x";
	zassert_equal(protocol.stage(Field::kUrl, reinterpret_cast<const uint8_t *>(invalid),
				     strlen(invalid), true),
		      -EINVAL);
	uint8_t value = 0;
	zassert_equal(protocol.stage(Field::kBrightness, &value, 1, true), -EINVAL);
	value = 100;
	zassert_equal(protocol.stage(Field::kBrightness, &value, 1, true), -EINVAL);
	value = 7;
	zassert_equal(protocol.stage(Field::kDefaultMode, &value, 1, true), -EINVAL);
	zassert_equal(protocol.stage(Field::kSchema, &value, 1, true), -EINVAL);
	zassert_equal(protocol.stage(Field::kUrl, nullptr, 1000, true), -EINVAL);
}
ZTEST(ble_protocol, test_audio_modes_can_be_staged_and_applied)
{
	constexpr Mode modes[] = {Mode::kAudioLevel, Mode::kAudioSpectrum};
	for (const Mode mode : modes) {
		TestProtocol protocol;
		const uint8_t value = static_cast<uint8_t>(mode);
		zassert_ok(protocol.stage(Field::kDefaultMode, &value, 1, true));
		const auto command = accept(protocol, 1, Field::kDefaultMode);
		zassert_equal(command.length, 1);
		zassert_equal(command.data[0], value);
		protocol.complete(command, 0);
		zassert_false(protocol.busy());
	}
}
ZTEST(ble_protocol, test_name_fragments_must_be_complete_and_contiguous)
{
	TestProtocol protocol;
	uint8_t first[20] = {0, 32}, second[16] = {18, 32};
	memset(first + 2, 'A', 18);
	memset(second + 2, 'B', 14);
	zassert_ok(protocol.stage(Field::kName, first, sizeof(first), true));
	ConfigCommand command;
	const uint8_t request[] = {kBleVersion, 1, 0, 0, 0, 2};
	zassert_equal(protocol.accept(request, sizeof(request), true, command), -EINVAL);
	second[0] = 17;
	zassert_equal(protocol.stage(Field::kName, second, sizeof(second), true), -EINVAL);
	second[0] = 18;
	zassert_ok(protocol.stage(Field::kName, second, sizeof(second), true));
	command = accept(protocol, 1, Field::kName);
	zassert_equal(command.length, 32);
	zassert_mem_equal(command.data, first + 2, 18);
	zassert_mem_equal(command.data + 18, second + 2, 14);
}
ZTEST(ble_protocol, test_name_restart_cannot_reuse_a_partial_or_invalid_value)
{
	TestProtocol protocol;
	const uint8_t name[] = {0, 3, 'A', 'B', 'C'};
	zassert_ok(protocol.stage(Field::kName, name, sizeof(name), true));
	const uint8_t partial[] = {0, 3, 'X'};
	zassert_ok(protocol.stage(Field::kName, partial, sizeof(partial), true));
	const uint8_t request[] = {kBleVersion, 1, 0, 0, 0, 2};
	ConfigCommand command;
	zassert_equal(protocol.accept(request, sizeof(request), true, command), -EINVAL);
	const uint8_t invalid[] = {1, 3, 0, 'Z'};
	zassert_equal(protocol.stage(Field::kName, invalid, sizeof(invalid), true), -EINVAL);
	zassert_equal(protocol.accept(request, sizeof(request), true, command), -EINVAL);
}
ZTEST(ble_protocol, test_busy_duplicate_and_status_encoding)
{
	TestProtocol protocol;
	const uint8_t level = 64;
	zassert_ok(protocol.stage(Field::kBrightness, &level, 1, true));
	const auto command = accept(protocol, 1, Field::kBrightness);
	zassert_equal(protocol.stage(Field::kBrightness, &level, 1, true), -EBUSY);
	uint8_t status[kBleStatusSize];
	protocol.status(status, 3);
	const uint8_t pending[] = {kBleVersion, 1, 0, 0, 0, 3, 1, 0x8d, 0xff, 0xff, 0xff, 3};
	zassert_mem_equal(status, pending, sizeof(pending));
	protocol.complete(command, -EACCES);
	protocol.status(status, 1);
	const uint8_t failed[] = {kBleVersion, 1, 0, 0, 0, 3, 2, 0xf3, 0xff, 0xff, 0xff, 1};
	zassert_mem_equal(status, failed, sizeof(failed));
	zassert_ok(protocol.stage(Field::kBrightness, &level, 1, true));
	const uint8_t duplicate[] = {kBleVersion, 1, 0, 0, 0, 3};
	ConfigCommand ignored;
	zassert_equal(protocol.accept(duplicate, sizeof(duplicate), true, ignored), -EALREADY);
	(void)accept(protocol, 2, Field::kBrightness);
}
ZTEST(ble_protocol, test_disconnect_discards_staging_and_late_completion)
{
	TestProtocol protocol;
	const uint8_t mode = 1;
	zassert_ok(protocol.stage(Field::kDefaultMode, &mode, 1, true));
	const auto previous = accept(protocol, 1, Field::kDefaultMode);
	protocol.reset();
	zassert_false(protocol.current(previous));
	protocol.complete(previous, 0);
	uint8_t status[kBleStatusSize];
	protocol.status(status, 1);
	zassert_equal(status[1], 0);
	zassert_equal(status[6], 0);
	zassert_ok(protocol.stage(Field::kDefaultMode, &mode, 1, true));
	const auto next = accept(protocol, 1, Field::kDefaultMode);
	protocol.complete(previous, -EIO);
	zassert_true(protocol.current(next));
	protocol.complete(next, 0);
	zassert_false(protocol.busy());
}
ZTEST(ble_protocol, test_apply_wire_version_length_and_zero_id)
{
	TestProtocol protocol;
	const uint8_t level = 16;
	zassert_ok(protocol.stage(Field::kBrightness, &level, 1, true));
	uint8_t packet[] = {99, 1, 0, 0, 0, 3};
	ConfigCommand output;
	zassert_equal(protocol.accept(packet, sizeof(packet), true, output), -EINVAL);
	packet[0] = kBleVersion;
	zassert_equal(protocol.accept(packet, 5, true, output), -EINVAL);
	packet[1] = 0;
	zassert_equal(protocol.accept(packet, sizeof(packet), true, output), -EALREADY);
	packet[1] = 0x78;
	packet[2] = 0x56;
	packet[3] = 0x34;
	packet[4] = 0x12;
	zassert_ok(protocol.accept(packet, sizeof(packet), true, output));
	zassert_equal(output.id, 0x12345678);
}
ZTEST(ble_protocol, test_maximum_artwork_and_interrupted_fragments)
{
	TestProtocol protocol;
	uint8_t artwork[(4 + 16 * kFrameBytes)] = {1, 16, 50, 0};
	for (size_t i = 4; i < sizeof(artwork); ++i) {
		artwork[i] = i;
	}
	ConfigCommand command;
	const uint8_t request[] = {kBleVersion, 1, 0, 0, 0, 6};
	for (size_t offset = 0; offset < sizeof(artwork); offset += 15) {
		const size_t count = sizeof(artwork) - offset < 15 ? sizeof(artwork) - offset : 15;
		uint8_t fragment[20] = {1, static_cast<uint8_t>(offset),
					static_cast<uint8_t>(offset >> 8),
					static_cast<uint8_t>(sizeof(artwork)),
					static_cast<uint8_t>(sizeof(artwork) >> 8)};
		memcpy(fragment + 5, artwork + offset, count);
		zassert_equal(protocol.stage(Field::kArtwork, fragment, count + 5, false), -EACCES);
		zassert_ok(protocol.stage(Field::kArtwork, fragment, count + 5, true));
		if (offset + count < sizeof(artwork)) {
			zassert_equal(protocol.accept(request, sizeof(request), true, command),
				      -EINVAL);
		}
	}
	command = accept(protocol, 1, Field::kArtwork);
	zassert_equal(command.length, sizeof(artwork));
	zassert_mem_equal(command.value(), artwork, sizeof(artwork));
	protocol.complete(command, 0);
	uint8_t first[] = {1, 0, 0, 132, 0, 1, 1, 50, 0};
	zassert_ok(protocol.stage(Field::kArtwork, first, sizeof(first), true));
	first[1] = 3;
	zassert_equal(protocol.stage(Field::kArtwork, first, sizeof(first), true), -EINVAL);
	protocol.reset();
	zassert_equal(protocol.accept(request, sizeof(request), true, command), -EINVAL);
}
ZTEST(ble_protocol, test_text_validation_and_ephemeral_nfc_action)
{
	TestProtocol protocol;
	const uint8_t text[] = {0, 0, 7, 0, 1, 2, 1, 1, 50, 0, 'a'};
	zassert_ok(protocol.stage(Field::kText, text, sizeof(text), true));
	const auto command = accept(protocol, 1, Field::kText);
	zassert_equal(command.length, 7);
	zassert_equal(command.data[6], 'a');
	protocol.complete(command, 0);
	const uint8_t malformed[] = {0, 0, 7, 0, 1, 2, 1, 1, 50, 0, 0xff};
	zassert_equal(protocol.stage(Field::kText, malformed, sizeof(malformed), true), -EINVAL);
	const uint8_t sync = 1;
	zassert_equal(protocol.stage(kNfcSyncField, &sync, 1, false), -EACCES);
	zassert_ok(protocol.stage(kNfcSyncField, &sync, 1, true));
	const auto action = accept(protocol, 2, kNfcSyncField);
	zassert_equal(action.length, 1);
	zassert_equal(action.data[0], 1);
	protocol.complete(action, -EPERM);
	const uint8_t request[] = {kBleVersion, 3, 0, 0, 0, 127};
	ConfigCommand empty;
	zassert_equal(protocol.accept(request, sizeof(request), true, empty), -EINVAL);
}
ZTEST(ble_protocol, test_motion_and_nfc_staging_do_not_alias)
{
	TestProtocol protocol;
	MotionConfig config;
	const uint8_t sync = 1;
	zassert_equal(protocol.stage(Field::kMotion, config.bytes, kMotionBytes, false), -EACCES);
	zassert_ok(protocol.stage(Field::kMotion, config.bytes, kMotionBytes, true));
	zassert_ok(protocol.stage(kNfcSyncField, &sync, 1, true));
	const auto motion = accept(protocol, 1, Field::kMotion);
	zassert_mem_equal(motion.data, config.bytes, kMotionBytes);
	protocol.complete(motion, 0);
	const auto nfc = accept(protocol, 2, kNfcSyncField);
	zassert_equal(nfc.length, 1);
	zassert_equal(nfc.data[0], 1);
	protocol.complete(nfc, 0);
	config.bytes[7] = 1;
	zassert_equal(protocol.stage(Field::kMotion, config.bytes, kMotionBytes, true), -EINVAL);
	const uint8_t fluid = 6;
	zassert_ok(protocol.stage(Field::kDefaultMode, &fluid, 1, true));
	zassert_equal(accept(protocol, 3, Field::kDefaultMode).data[0], 6);
}
ZTEST(ble_protocol, test_extended_url_fragments_and_compact_staging)
{
	static_assert(sizeof(BleProtocol) < 400,
		      "Staging must not allocate an artwork buffer for scalar fields");
	TestProtocol protocol;
	const char url[] = "HTTPS://EXAMPLE.COM/ABCDE";
	static_assert(sizeof(url) == 26);
	uint8_t first[20] = {0, 25}, second[9] = {18, 25};
	memcpy(first + 2, url, 18);
	memcpy(second + 2, url + 18, 7);
	zassert_equal(protocol.stage(Field::kUrl, second, sizeof(second), true), -EINVAL);
	zassert_ok(protocol.stage(Field::kUrl, first, sizeof(first), true));
	ConfigCommand command;
	const uint8_t request[] = {kBleVersion, 1, 0, 0, 0, 1};
	zassert_equal(protocol.accept(request, sizeof(request), true, command), -EINVAL);
	zassert_ok(protocol.stage(Field::kUrl, second, sizeof(second), true));
	const uint8_t brightness = 16;
	zassert_ok(protocol.stage(Field::kBrightness, &brightness, 1, true));
	zassert_ok(protocol.accept(request, sizeof(request), true, command));
	zassert_equal(command.length, 25);
	zassert_mem_equal(command.data, url, 25);
	protocol.complete(command, 0);
	const uint8_t level_request[] = {kBleVersion, 2, 0, 0, 0, 3};
	zassert_ok(protocol.accept(level_request, sizeof(level_request), true, command));
	zassert_equal(command.data[0], brightness);
}

ZTEST(ble_protocol, test_32_frame_transfer_and_bad_gray_runs)
{
	TestProtocol protocol;
	uint8_t artwork[4 + 32 * kFrameBytes] = {1, 32, 100, 0};
	artwork[4] = 128;
	artwork[sizeof(artwork) - 1] = 1;
	for (size_t offset = 0; offset < sizeof(artwork); offset += 15) {
		const size_t count = sizeof(artwork) - offset < 15 ? sizeof(artwork) - offset : 15;
		uint8_t fragment[20] = {1, static_cast<uint8_t>(offset),
					static_cast<uint8_t>(offset >> 8),
					static_cast<uint8_t>(sizeof(artwork)),
					static_cast<uint8_t>(sizeof(artwork) >> 8)};
		memcpy(fragment + 5, artwork + offset, count);
		zassert_ok(protocol.stage(Field::kArtwork, fragment, count + 5, true));
	}
	auto command = accept(protocol, 1, Field::kArtwork);
	zassert_equal(command.length, sizeof(artwork));
	zassert_mem_equal(command.value(), artwork, sizeof(artwork));
	protocol.complete(command, 0);
	const uint8_t invalid[] = {1, 0, 0, 14, 0, 2, 1, 150, 0, 0, 0, 2, 3, 0, 100, 0, 0, 0, 64};
	zassert_equal(protocol.stage(Field::kArtwork, invalid, sizeof(invalid), true), -EINVAL);
}
ZTEST_SUITE(ble_protocol, nullptr, nullptr, nullptr, nullptr, nullptr);

ZTEST(ble_protocol, test_wide_128_frame_transfer_and_small_command)
{
	static_assert(sizeof(ConfigCommand) < 160);
	static_assert(sizeof(BleProtocol) < 400);
	static uint8_t blob[kArtworkBytes];
	blob[0] = 2;
	blob[1] = 128;
	blob[2] = 100;
	for (unsigned i = 0; i < 128; i++) {
		const size_t at = 6 + i * 1029;
		blob[at] = 1;
		blob[at + 2] = 4;
		blob[at + 3] = 100;
		for (unsigned p = 0; p < 1024; p++) {
			blob[at + 5 + p] = i + p;
		}
	}
	zassert_true(valid_artwork(blob, sizeof(blob)));
	TestProtocol protocol;
	uint8_t packet[244];
	packet[0] = 2;
	auto put = [](uint8_t *out, uint32_t value) {
		for (unsigned i = 0; i < 4; i++) {
			out[i] = value >> (8 * i);
		}
	};
	for (size_t offset = 0; offset < sizeof(blob);) {
		const size_t count = sizeof(blob) - offset < 235 ? sizeof(blob) - offset : 235;
		put(packet + 1, offset);
		put(packet + 5, sizeof(blob));
		memcpy(packet + 9, blob + offset, count);
		zassert_equal(protocol.stage(Field::kArtwork, packet, 9 + count, false), -EACCES);
		zassert_ok(protocol.stage(Field::kArtwork, packet, 9 + count, true));
		offset += count;
	}
	const auto command = accept(protocol, 1, Field::kArtwork);
	zassert_equal(command.length, 131718);
	zassert_equal(command.value(), art_staging);
	zassert_mem_equal(command.value(), blob, sizeof(blob));
	zassert_equal(protocol.stage(Field::kArtwork, packet, 20, true), -EBUSY);
	protocol.reset();
	zassert_false(protocol.current(command));
	put(packet + 1, 0);
	put(packet + 5, kArtworkBytes + 1);
	zassert_equal(protocol.stage(Field::kArtwork, packet, 20, true), -EINVAL);
}

ZTEST(ble_protocol, test_sequential_read_cursor)
{
	ArtworkReadCursor read;
	const uint8_t sequential[] = {4}, meta[] = {3}, bad[] = {2, 0xff, 0xff, 0xff, 0xff};
	zassert_true(read.select(sequential, sizeof(sequential), 1000));
	zassert_true(read.sequential && read.wide);
	zassert_equal(read.capacity(246), 236);
	zassert_equal(read.capacity(22), 13);
	read.complete(0, 244, 244, 236);
	zassert_equal(read.offset, 236);
	read.complete(1, 244, 244, 236);
	read.complete(0, -1, 244, 236);
	zassert_equal(read.offset, 236);
	zassert_false(read.select(bad, sizeof(bad), 1000));
	zassert_equal(read.offset, 236);
	zassert_true(read.select(meta, sizeof(meta), 1000));
	zassert_true(read.metadata && !read.sequential);
}
