zgeez/Pixel-Badge/(commit log)

2026-10-05 Freeze Rev A badge architecture (#2)
    * docs: freeze Rev A badge architecture
    * docs: address architecture review findings
    * docs: address USB-C, NFC security, and battery sensing review
2026-10-05 docs: accept Rev A architecture ADRs (#3)
    ADRs 0001-0006 were merged in #2 with status Proposed. The repository's
    ADR process changes the status to Accepted once the introducing pull
    request is approved and merged, so mark them Accepted and update the
    decisions index and architecture overview wording that referred to the
    pending pull request.
    Acceptance records the design choices only; prototype-dependent values
    remain provisional and no hardware validation is implied.
2026-10-05 hw: start Rev A schematic project and resolve design decisions (#4)
    * hw: add Rev A schematic skeleton
    Add the KiCad 10.0.6 project with a root schematic and one empty
    hierarchical sheet per Rev A block, plus project-relative symbol and
    footprint library tables so the project opens without global library
    setup.
    * build: add KiCad schematic check command
    Run ERC on the full hierarchy with errors and warnings both failing,
    and export the schematic PDF and BOM to build/hardware/ as generated
    artifacts. A self-test injects a fault into a temporary copy of the
    project and requires ERC to report it, so a passing run cannot come
    from a check that silently stopped working.
    Exposed as `dev.ps1 ha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
    [debug.kicad_sch, imu.kicad_sch, led_matrix.kicad_sch, matrix_columns.kicad_sch, matrix_rows.kicad_sch, mcu_module.kicad_sch, microphone.kicad_sch, nfc.kicad_sch]
2026-10-06 hw: draw Rev A power tree and charger with USB charging state (#5)
    * fw: add ICM-42688-P I2C driver
    NCS v3.4.1's icm4268x driver supports SPI only, and the Rev A IMU is
    wired for I2C. Add a small project driver, packaged as a Zephyr module
    under firmware/src/drivers so the application and tests share its
    Kconfig, bindings and sources.
    The driver reuses the stock register map and devicetree property
    encoding, applies the datasheet's I2C settings (I3C SDR/DDR off, slew
    rates, SPI interface disabled) and INT_ASYNC_RESET = 0, and supports
    data-ready interrupts. Moving the part to SPI only changes the node.
    An emulator test on native_sim covers reset and identity checks, the
    I2C-mode configura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
    [power_tree.kicad_sch, usb_charger_battery.kicad_sch]
2026-10-06 hw: draw MCU module and debug sheets (#6)
    * hw: draw MCU module and debug sheets
    Draw the MDBT53-P1M with Raytac's normal-voltage DC/DC reference
    circuit (Ver.E section 8.1.2): VDD and VDDH on 3V3 with 4.7 uF, a
    10 uH inductor and 1 uF on each internal regulator output, and module
    VBUS through 2.2 ohm with 4.7 uF. The 32.768 kHz crystal uses the
    nRF5340's internal 9 pF load, with external load caps left unfitted.
    USB D+/D- reach the module through 0 ohm links that can take the
    27 ohm resistors shown in Raytac's figure.
    The debug sheet has the ARM Cortex 10-pin SWD header and pads for
    reset, SWD, UART, ground and six spare GPIO. The header connects to
    the nRF5340 DK's debug out; pin 3 is gr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
    [debug.kicad_sch, mcu_module.kicad_sch]
2026-10-07 hw: draw UI, IMU, microphone and NFC sheets (#7)
    * hw: add IMU, NFC tag, button and microphone footprints
    Add project symbols for the ICM-42688-P and NT3H2111W0FHKH, drawn from
    the TDK and NXP pin tables. The IMU uses KiCad's LGA-14 3 x 2.5 mm
    footprint, whose pad centres and numbering match TDK's package
    drawing.
    New footprints:
    - NT3H2111W0FHKH XQFN8 (SOT902-3), using the reflow footprint in the
    NXP datasheet: 0.40 x 0.22 mm lands, paste 0.025 mm inside, and no
    land under the centre metal area.
    - XUNPU TS-1088 tact switch, from the vendor PCB drawing.
    - Knowles LGA-5 microphone with the acoustic hole enlarged to 0.8 mm,
    inside Knowles' 0.6-1.0 mm recommendation.
    * hw: draw UI, IMU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
    [imu.kicad_sch, microphone.kicad_sch, nfc.kicad_sch, power_tree.kicad_sch, usb_charger_battery.kicad_sch, user_interface.kicad_sch]
2026-10-07 hw: draw LED matrix, row and column drivers and scan-stall safety (#8)
    * repo: ignore KiCad local history
    KiCad 10 keeps automatic snapshots in a .history folder (with its own
    Git repository) next to the project. Ignore it, and make the hygiene
    check reject it, so local history cannot be committed.
    * hw: save schematic sheets in KiCad's own format
    Opening and saving the project in KiCad 10 rewrites the generated
    sheets and project file in its native layout. KiCad also merges seven
    overlapping wire segments on the USB sheet. Nets, values and
    footprints are unchanged, so committing this once keeps later edits
    made in KiCad free of formatting churn.
    * hw: add column driver and monostable sy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
    [debug.kicad_sch, imu.kicad_sch, led_matrix.kicad_sch, matrix_columns.kicad_sch, matrix_rows.kicad_sch, mcu_module.kicad_sch, microphone.kicad_sch, nfc.kicad_sch]
2026-10-07 fw: add Rev A board definition and build it in CI (#9)
    * fw: add Rev A board definition
    Add the smart_led_badge board (MDBT53-P1M, nRF5340) for both cores,
    modified from Zephyr's raytac_mdbt53_db_40 board for the Rev A pin
    map.
    The application core gets the matrix SPIM and control GPIOs, the IMU
    and NTAG I2C buses, PDM, the SAADC channels, buttons, status LED,
    UART on the test pads, USB and the watchdog. Board signals without a
    driver are zephyr,user GPIOs. The network core owns no pins because
    P1.00/P1.01 carry the NTAG bus. VREGH stays disabled (normal-voltage
    mode) and the LFXO uses the internal 9 pF load.
    The board files stay under Apache-2.0: they keep the upstream
    copyright notices,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
2026-10-07 hw: verify pin mapping and fix the USB ESD footprint (#10)
    * hw: use TI's DQA0010A land pattern for the USB ESD array
    KiCad's generic USON-10 footprint comes from another TI part and has
    0.30 mm pads on all ten pins with the rows 0.77 mm apart. TI's
    DQA0010A land pattern for the TPD4E05U06 uses 0.20 mm signal pads,
    0.40 mm ground pads (pins 3 and 8) and rows 0.835 mm apart, with
    narrower paste on the ground pads. The new project footprint follows
    TI's land pattern and stencil examples.
    TI also lists a DQA0010B outline whose pins 3 and 8 are joined by
    exposed metal, so no other net may pass between those pads.
    * hw: check symbol pin numbers against footprint pads
    The hardware check now co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
    [usb_charger_battery.kicad_sch]
2026-10-07 hw: use single-sided assembly with a through-hole battery header and low-profile inductors (#11)
    * hw: use a through-hole side-entry battery header
    The board is assembled on one side only, so the battery header can no
    longer be an SMT part on the rear. J302 becomes a JST S2B-PH-K-S
    through-hole side-entry header: its body sits on the rear beside the
    pack's lead exit and its pins are soldered from the front, outside the
    LED field. The footprint matches JST's through-hole layout (circuit 1
    position, 2.0 mm pitch, 0.75 mm drill).
    The symbol becomes a plain two-pin connector because the part has no
    mounting pads. Pin 1 stays BAT- and pin 2 BAT+. An Assembly field marks
    the part as hand-soldere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
    [power_tree.kicad_sch, usb_charger_battery.kicad_sch]
2026-10-07 hw: freeze the Rev A schematic for layout (#12)
    * hw: freeze the Rev A schematic for layout
    The freeze review checked every sheet against the netlist and the parts'
    datasheets: rails and enables, charger and regulator capacitors, matrix
    start-up and blanking, test points, USB, I2C, PDM, fault states and
    back-power paths. No circuit change was needed.
    The sheets' title blocks and the hardware documents now mark the
    schematic as frozen for layout. Later changes go through a recorded
    decision; the matrix LED footprint still follows the final LED part.
    Points for bring-up include the VBUS attach capacitance, the charger
    enable while 3V3 is absent, VLED loop stability and VBUS-before-VDD
    behavi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
    [debug.kicad_sch, imu.kicad_sch, led_matrix.kicad_sch, matrix_columns.kicad_sch, matrix_rows.kicad_sch, mcu_module.kicad_sch, microphone.kicad_sch, nfc.kicad_sch]
2026-10-09 ci: lock host test packages and fall back when the snapshot is down (#14)
    The unit-test job installs g++-multilib and make from a fixed Ubuntu
    snapshot. When snapshot.ubuntu.com returned 503, apt-get update only
    warned, and the job failed later with a misleading "unable to locate
    package" error.
    Pinning g++-multilib alone did not pin the compiler: it pulls in
    g++-13 and its libraries, which apt may resolve to newer versions.
    The script now locks all ten packages the job installs at the versions
    it installed from the snapshot. apt's install plan must match that set
    exactly, and the installed versions are checked afterwards.
    The index update retries and fails on any download error. If the
    sn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
2026-10-09 hw: start the Rev A layout with placement and matrix routing (#13)
    * docs: record Raytac's USB decoupling reply and VBUS limit
    Raytac R&D confirmed in writing that the DECUSB capacitor for the USB
    regulator is inside the MDBT53 modules, and that the 4.7 µF behind 2.2 Ω
    in their reference circuit is C_VBUS (C402/R401 on this board).
    The attach-inrush fallback now stays within the nRF5340 limit of 6 Ω DC
    VBUS source resistance, including the cable, when VDDH is not supplied
    from VBUS: R401 stays at or below 4.7 Ω, and a smaller C402 is checked
    against the nRF5340 VBUS decoupling requirement before it is fitted.
    * hw: add layout footprints for LEDs, NFC coil, test pads and mic
    The matri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
    [debug.kicad_sch, led_matrix.kicad_sch, microphone.kicad_sch, nfc.kicad_sch, power_tree.kicad_sch, smart-led-badge.kicad_pcb, test_points.kicad_sch, usb_charger_battery.kicad_sch]
2026-10-09 fw: map the Rev A pin roles onto the nRF5340 DK (#15)
    Bench firmware runs on the DK before the badge exists, so the DK
    build should use the badge's pins wherever the DK allows. The overlay
    moves SPIM4 to its dedicated pins P0.08-P0.10 (the DK board puts it on
    the Arduino SPI pins, which the bench uses for the HUB75 panel), puts
    matrix LAT and BLANK on P0.11/P0.12, and swaps I2C1 to SCL on P1.02 and
    SDA on P1.03 as on Rev A. It also adds a frame marker on P0.26 for the
    logic analyzer and removes Buttons 3 and 4, whose pins carry the matrix
    SPI.
    P0.10 and P0.11 are also the flow-control pins of the debugger's serial
    port 0. UART1 stays off, and the overlay stops forwarding those two
    pins to t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
2026-10-10 fw: add the matrix scan timing bench test and its DK result (#16)
    * build: let the build scripts build any app directory
    Bench tests live in their own application directories under
    firmware/bench, separate from the badge image. build-firmware.sh takes
    APP_DIR and dev.ps1 takes -App; both default to firmware/, so existing
    builds are unchanged.
    * fw: add a matrix scan timing bench test for the DK
    Drives the Rev A matrix scan signals on the DK pins with the planned
    hardware timing: TIMER1 times each 160 us row slot and drives the SPIM4
    list transfer and the LAT and BLANK pins through DPPI and GPIOTE, and
    TIMER2 stops the scan after 32 rows. The CPU only restarts each frame
    from one interrupt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
2026-10-11 fw: add a HUB75 bench display, module self-checks and QR screening (#17)
    * fw: add a HUB75 bench display driver
    The DK needs a display for bench work, test patterns and QR screening,
    before the badge exists. This drives a HUB75 RGB panel from GPIO as a
    Zephyr display (smartledbadge,hub75): a monochrome 32 x 32 window in
    MONO01 format.
    TIMER0 times each 160 us row slot. Its interrupt latches the row shifted
    during the previous slot and shifts the next row while this one is lit;
    a second compare switches OE off through DPPI and GPIOTE, so the on-time
    (brightness) is set by hardware and a late interrupt skips a row instead
    of leaving it lit. Frames are double buffered and swapped at the frame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
    [results.csv]
2026-10-11 fw: pass the module self-checks on the DK bench modules (#18)
    * fw: recover the I2C bus after the IMU turns I3C off
    On the bench ICM-42688-P module, the first I2C transaction after
    INTF_CONFIG6 turns I3C SDR/DDR off stalled until the 500 ms TWIM
    timeout; the driver's bus recovery then freed it and setup continued.
    Since the timeout fell on the INTF_CONFIG4 access, initialisation
    failed on every boot. A 1 ms pause did not help.
    The driver now runs the bus recovery right after that write: 5 of 5
    boots initialise, and the application starts about 0.45 s sooner. This
    is a bench observation, not a datasheet requirement; the likely cause
    is the part holding SDA after the interface change.
    * fw: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
    [bringup.cpp, icm42688_i2c.c]
2026-10-11 docs: allow voice recording with a visible indicator (#19)
    * fw: fi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
2026-10-12 fw: add the prototype badge foundation (#20)
    * fw: vendor the fixed-buffer QR encoder
    Pin the MIT C encoder at v1.8.0 and preserve its original sources.
    Keep its build and formatting policy separate from application code.
    Preserve upstream trailing whitespace in the two pinned source files.
    * fw: add host-tested badge services
    Add bounded URL/settings validation, QR/name rendering, button
    classification, display recovery and reset-loop logic. Publish recovered
    schemas only after replacing all old fields with defaults.
    Keep services portable and cover interrupted recovery on native_sim.
    * build: configure local QR links from dotenv
    Select a validated QR default from local URL configurati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
    [boot_guard.hpp, boot_retention.cpp, buttons.hpp]
2026-10-12 fw: add guarded NFC updates and explicit provisioning (#21)
    * fw: add guarded NTAG EEPROM and NDEF services
    Encode bounded URI records without changing case-sensitive paths. Guard
    STOP-separated frames, poll write completion and verify readable bytes.
    Bound recovery and reject irreversible configuration writes.
    Clear the FD latch before interrupt enable and retain handoff pulses.
    * fw: integrate verified NFC updates and provisioning
    Share the I2C mutex with deferred IMU reads and move NFC transactions out
    of bring-up. Gate URL updates on QR submission and verified tag data.
    Require explicit RF provisioning and retain only a non-secret receipt.
    Reject legacy RF-proof receipts and provision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
2026-10-13 fw: add BLE configuration and Pixel Badge app (#22)
    * fw: update NFC provisioning and URL worker
    Require two fresh generated-password RF sessions under ADR 0014.
    Keep transport errors inconclusive and retain guarded finalization.
    Expose serialized URL work for the configuration client and add fixed
    non-secret diagnostics without relaxing the receipt policy.
    Cover all host mailbox setup writes with best-effort credential erasure,
    preserve the original failure, and reject cleanup-only failures.
    * fw: define the portable BLE settings protocol
    Stage one field per authenticated connection and correlate Apply status
    with request identifiers and connection generations. Use a fixed wire
    pending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
    [ble.cpp]
2026-10-13 hw: replace the MDBT53 with the E73 nRF52840 module (#23)
    * hw: add E73-2G4M08S1C library assets
    Add the symbol, footprint and envelope model for the Ebyte
    E73-2G4M08S1C (nRF52840) module that replaces the MDBT53-P1M on Rev A.
    The footprint follows the Ebyte specification drawing, mirrored from
    the bottom view, and every pad centre was checked against the drawing
    dimensions. Castellated lands extend 0.3 mm beyond the body. Ebyte
    publishes no antenna keep-out, so the footprint keeps every copper
    layer clear at the ceramic-antenna end. The symbol reuses the MDBT53
    pin locations per net so the MCU sheet wiring carries over. The 3D
    model is a 13 x 18 x 3.0 mm envelope for clearance checks only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
    [debug.kicad_sch, imu.kicad_sch, matrix_columns.kicad_sch, matrix_rows.kicad_sch, mcu_module.kicad_sch, nfc.kicad_sch, smart-led-badge.kicad_pcb, test_points.kicad_sch]
2026-10-14 app: add Pixel Badge Studio and BLE content controls (#24)
    * repo: add shared classic bitmap font
    Use the same printable ASCII glyphs in firmware and Flutter previews.
    Retain the upstream BSD license and source provenance.
    * fw: add persistent Studio content and BLE controls
    Extend authenticated configuration with bounded text and 16-frame artwork,
    paged readback at the default MTU, and guarded same-URL NFC resync.
    Preserve schema recovery, pairing and NFC verification requirements.
    Native content, persistence and protocol checks plus both DK sysbuilds
    pass. Physical animation timing and full acceptance remain pending.
    * app: add Pixel Badge Studio and offline drafts
    Add adaptive light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
2026-10-15 fw: add audio visualization and private phone recording (#25)
    * fw: add audio analysis and recording codecs
    Add fixed-buffer level and spectrum analysis, independent IMA ADPCM
    blocks, and recording gain, rumble filtering and peak limiting. Native
    tests cover signal processing, codec boundaries and deterministic
    cleanup. Acoustic calibration and sustained target timing remain bench
    work.
    * fw: add authenticated audio session cryptography
    Derive ephemeral P-256/HKDF session keys over the authenticated
    Bluetooth bond. Authenticate replay-counted controls and encrypt each
    recording with a fresh key and nonce. Native reference vectors cover
    agreement, authenticators, encryption and rejection p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
    [AudioWireTest.kt, BadgeAudio.kt]
2026-10-16 fw: add motion controls and simplify NFC synchronization (#26)
    * fw: add fluid mode and IMU display orientation
    Add bounded fixed-point particles, mounting-axis configuration and
    filtered four-way orientation with QR orientation locked on entry.
    Integrate the DRDY worker, persistent motion settings and BLE status.
    Native motion, settings and protocol checks pass. Actual frame timing,
    stack use, sensor mounting and the nRF52840 port remain unverified.
    * fw: synchronize NFC without a phone verifier
    Replace the RF-proof receipt prerequisite with guarded local policy
    and NDEF readback checks. Preserve protected-tag checks, current-boot
    UID binding, field guards and the existing URL rollback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
    [ble.cpp, ble_protocol.hpp, main.cpp, modes.cpp, modes.hpp]
2026-10-18 app: add grayscale studio and larger badge animations (#27)
    * fw: extend prototype display and artwork storage
    Add 8-bit content, timed animations and 128-frame flash-backed artwork
    with CRC verification, inactive-bank writes and manifest-last activation.
    Bound playback RAM and BLE staging; preserve settings and legacy assets.
    Use a common eight-plane HUB75 schedule for binary and gray content,
    retain display recovery, and render scrolling/bouncing text at 20 ms.
    QR encoding selects the strongest fitting version-one correction level.
    Optical timing, QR brightness, combined-load and Rev A port acceptance
    remain separate from prototype builds and host tests.
    * build: extend QR defaults and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
2026-10-18 fw: add separate nRF52840 Rev A firmware and bench (#28)
    * fw: separate prototype and shared firmware sources
    Keep the nRF5340 application, board definitions and radio configuration
    under an explicit prototype root. Share services and drivers for the
    separate MCU targets, including portable display recovery and capture
    profiles. Update existing build and test paths with the relocation.
    * fw: add the Rev A nRF52840 board target
    Add the E73 pin contract, single-core application/controller layout and
    safe startup configuration. Preserve two firmware slots and 128-frame
    artwork capacity. Add compiled contract and row-packing checks.
    Matrix output and charging remain disabled by default. Powe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
2026-10-19 hw: lay out and route the Rev A board (#29)
    * hw: add fab-layer references to custom footprints
    Show each part's reference on F.Fab so the assembly drawing used for
    bring-up and rework labels the custom parts the same way as the KiCad
    library parts. Copper, courtyards and silkscreen are unchanged.
    * hw: join the NFC coil's twin pad-2 ends as a jumper
    The coil's inner and outer pad-2 ends are connected by footprint copper
    (the In1 crossover), which KiCad does not count as a connection, so
    NFC_LB stayed unrouted. Treat the duplicate pad numbers as a jumper.
    The pad 1/2 net tie is unchanged.
    * hw: remove unfitted parts and spare test points
    Free routing room on the Rev A board:
    - remove th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
    [matrix_columns.kicad_sch, matrix_rows.kicad_sch, microphone.kicad_sch, nfc.kicad_sch, power_tree.kicad_sch, smart-led-badge.kicad_pcb, test_points.kicad_sch, usb_charger_battery.kicad_sch]
2026-10-20 fw: add Rev A power and matrix bring-up diagnostics (#30)
    * fw: add Rev A power and matrix bring-up diagnostics
    Extend the diagnostics image so first power-up can be checked step by
    step without lighting the matrix or charging the pack:
    - reset cause, 32.768 kHz clock source, switched VBAT divider, VLED and
    CC1/CC2 sense through the SAADC
    - BQ25620 identity, faults, TS zone, D+/D- result, its ADC and event
    flags; the documented input-limit policy, TS_TH4_TH5_TH6 = 011 and
    the I2C watchdog are kept in force
    - MTX_SAFE_SENSE and a TLC59283 chain readback on MISO with the LED
    rail off and no LAT pulse
    - button, power-switch edges and a status LED heartbeat
    Charging stays off unless di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
    [bq25620.hpp, bringup.cpp, check_reva_contract.py, main.cpp, matrix_chain.hpp, matrix_diag.cpp, matrix_diag.hpp]
2026-10-21 ci: fall back to the Ubuntu archive when snapshot downloads fail (#34)
    The unit-tests job installs its host compiler from a pinned Ubuntu
    snapshot and fell back to the regular archive only when the package
    index could not load. On 2026-10-21 the snapshot served the index but
    returned 503 for the packages, so the job failed without trying the
    archive. The install step now retries and, if it still fails, switches
    to the archive with the same locked versions; the install plan is
    checked again on the archive, so nothing else can be installed.
2026-10-21 fw: add the Rev A power manager, load shedding and USB policy (#31)
    * fw: add the battery load-shed policy
    A pure state machine for the PROPOSED defaults in docs/power.md. A
    loaded VBAT below 3.55 V caps brightness at level 127; three loaded
    readings below 3.40 V turn the LED rail off. Re-enable needs 10 s at
    3.70 V (battery-qualified) or USB with at least a 500 mA input limit
    and 3.50 V (input-qualified), and ramps 13/64/127/255 in 5 s steps.
    A shed within 60 s of a re-enable is a failed attempt: retries back
    off from 60 s to 15 min, and after three failures only battery
    qualification counts. Invalid readings keep the rail off; three
    unloaded readings below 3.30 V on battery request the lo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
    [bq25620.hpp, charging_only.cpp, charging_only.hpp, display_sync.h, hub75_timing.h, icm42688_i2c.c, imu_power.h, main.cpp]
2026-10-21 build: add Rev A recover, flash and RTT commands
    Rev A is programmed over SWD through the nRF5340 DK's debug out, and
    the wired setup still assumed the DK as the target. dev.ps1 now has:
    - recover: ERASEALL plus nrfutil's keep-open firmware, needed once for
    a new module because newer nRF52840 build codes ship with AP-Protect
    enabled. It erases the whole chip and requires -EraseAll.
    - flash: programs merged.hex with chip_erase_mode set to the ranges the
    image touches, verifies by readback and resets, so UICR (pin reset,
    NFC pins as GPIO, open debug port), settings, the bond and artwork
    survive.
    - rtt: logs RTT channel 0 with JLinkRTTLogger.
    The DK's own nRF5340 and its prototype d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
2026-10-21 docs: describe Rev A flashing, recovery and RTT logs
    Add the flashing section to the Rev A README and turn the bring-up
    programming steps into the new commands, including the probe check
    with the badge unpowered and the one-time recover for a new module.
2026-10-21 build: build and flash the three programs by name (#35)
    * build: build and flash the three programs by name
    The project has three programs: the nRF5340 DK prototype, the Rev A
    diagnostics image and the Rev A main image. dev.ps1 -Image selects one
    and sets its target, application, board, build directory and base
    configuration. Bench add-ons (matrix stepper, first charge, matrix and
    recording bench) stay opt-in -ExtraConfFile builds, so LED output and
    charging still need a deliberate build.
    flash and rtt now also cover the prototype. Flashing the DK requires
    the probe to identify its nRF5340 (a board on the debug-out cable is
    refused), an nrf5340dk build, and images that stay inside MCUboot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
2026-10-21 docs: add the expected bring-up log lines for each step (#36)
    * docs: add the expected bring-up log lines for each step
    Bring-up compares RTT logs against what the firmware should print, and
    that knowledge lived only in the source. List, for each checklist step,
    the program to flash and the exact log lines that mean pass, fail or
    follow-up: reset and clock, power manager, outputs-off matrix chain,
    IMU, NFC, microphone, USB-C limits and suspend, the pack probe and
    first charge, the matrix stepper, and the main image's power states.
    Expected values are design expectations to compare with a meter.
    * docs: list each matrix bench step and the armed main build
    Each MODE press advances one of el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
2026-10-21 fw: add a scan-stall test step to the Rev A matrix bench (#38)
    * fw: add a scan-stall test step to the Rev A matrix bench
    If the scan stops with BLANK low, only the external one-shot keeps an
    LED from staying lit. The bring-up plan tests it with a firmware hang,
    which a debugger halt does not cover, and the bench had no way to stop
    the scan with an LED lit.
    Step 12 of the matrix bench lights one LED (row 0, column 0) after a
    single LAT pulse and sends no more. The driver times MTX_SAFE_SENSE
    from the pulse and logs the width against the calculated 760-1410 us.
    A TIMER compare re-blanks through the existing PPI link at 3000 us, so
    the LED is bounded even if the one-shot fails or the CPU sto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
    [display_sync.h, matrix_diag.cpp, reva_matrix.c]
2026-10-21 build: refuse Rev A flash and recover on bootloader boards (#37)
    * build: refuse Rev A flash and recover on bootloader boards
    The bench also has a Pro Micro nRF52840 with the Adafruit UF2
    bootloader, and the chip identity alone cannot tell it from the badge.
    Programming merged.hex would overwrite its MBR and recover would erase
    the bootloader.
    flash and recover now read UICR.NRFFW[0] (0x10001014), where the MBR
    finds a bootloader's start address, with --family nrf52. Rev A images
    carry no UICR data and recover erases UICR, so on the badge it reads
    0xffffffff. Any other value is refused. flash also refuses an
    unreadable word; recover accepts it, since AP-Protect can hide UICR on
    a new modul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
2026-10-22 docs: list the expected values for Rev A bring-up (#39)
    * docs: list the expected values for Rev A bring-up
    The bring-up plan judges first-power readings against design values,
    which were spread across the power and hardware docs and the firmware
    timing. Collect them with their sources: rail set points, column and
    peak row current, the first-charge setting, CC thresholds, the
    one-shot width, and the firmware's IMU and microphone pass bands.
    Add upper bounds on the average LED current at each matrix bench step,
    derived from the scan timing in hub75_timing.h. Idle current has no
    calculated value in the design, so it is recorded as a baseline rather
    than judged against a guess.
    * docs: inclu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
2026-10-22 fw: stop charging above about 38 C board temperature (#40)
    * fw: stop charging above about 38 C board temperature
    The pack on order is Adafruit 328, but its distributor and Adafruit
    link different specifications: PKCELL allows charging at 0-45 C,
    Hunan Sounddon at 0-40 C. The charger's own HOT threshold on this
    board is 41.7-44.5 C and the firmware WARM step only lowers VREG, so
    charging could continue above 40 C.
    Add a charge gate on the charger's TS reading: CHG_EN stays low below
    38.4 % of REGN (38.0 C nominal, 37.3-38.7 C with 1 % RT1, R25 and B)
    and is released at 40.0 % (36.1 C). An unread TS counts as too warm.
    The thresholds and hysteresis are unit-tested against the RT1 / NTC
    netw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
2026-11-04 fw: bring up the Rev A boards (#41)
    * fw: run the Rev A matrix scan in hardware
    The per-row worker thread either starved every lower-priority thread or,
    below them, managed about 33 frames/s with visible flicker on board 1.
    The frame is now pre-encoded into 256 row slots. SPIM2 walks them by
    EasyDMA list, TIMER3 compares start each transfer and drive LAT and
    BLANK through PPI/GPIOTE, and a TIMER4 counter stops the sequence after
    each 32-row plane, so the CPU takes one interrupt per plane. The
    firmware count is about 215 frames/s; it has not been captured on a
    logic analyzer yet. A stalled or halted CPU stops LAT after at most one
    plane and the external one-shot blanks the matrix.
    SPIM3 st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
    [audio_runtime.cpp, battery_level.hpp, battery_log.cpp, battery_log.hpp, battery_log.py, ble.cpp]
2026-11-04 hw: add the printable badge carrier parts
    3MF print files for the Rev A wearable carrier: rear carrier, front
    face, matrix pixel grid and diffuser, mode and action button caps,
    button plunger, magnetic backing and magnet retaining cap, an M2 thread
    test coupon, and a printable model of the populated PCB, without the
    rear JST, for fit checks.
    With the printed diffuser, the badge's QR code scans far more readily
    than on the bare LEDs; this is a first hands-on result, not a measured
    scan test. Fit, latch retention and switch access are not yet verified
    on prints.
    [action-button-cap.3mf, button-plunger.3mf, front-face.3mf, m2-thread-coupon.3mf, magnet-retaining-cap.3mf, magnetic-backing.3mf, matrix-diffuser.3mf, matrix-pixel-grid.3mf]
2026-11-04 docs: add Rev A photos and the fluid video
    Photos of board 1 running (QR code, artwork, recording view, charging
    bench), the fluid effect before and after the edge fix with a short
    video, the printed carrier, a rear board render and the DK wiring.
    None of the files carry EXIF, GPS or device metadata.
2026-11-04 docs: rewrite the guides for the Rev A boards
    The guides still described Rev A as in production and awaiting
    bring-up, and the Rev A firmware guide described the old thread-driven
    scan. They now reflect the bring-up results, the hardware-sequenced
    scan, the new bench add-ons and the diffuser's effect on QR scanning.
    Each guide is shorter and plainer. The BLE protocol is reorganised
    around the current wire format, with older capability sets in one
    compatibility section. The expected LED currents are recalculated for
    the current slot timing (256 ticks plus the on-time). Dated validation
    records and decision records keep their text; only links to renamed
    headings changed.
